AlpAydinoglu/cartpole_mechanical_setup/Mechanical Design/CAD/foam.SLDPRT

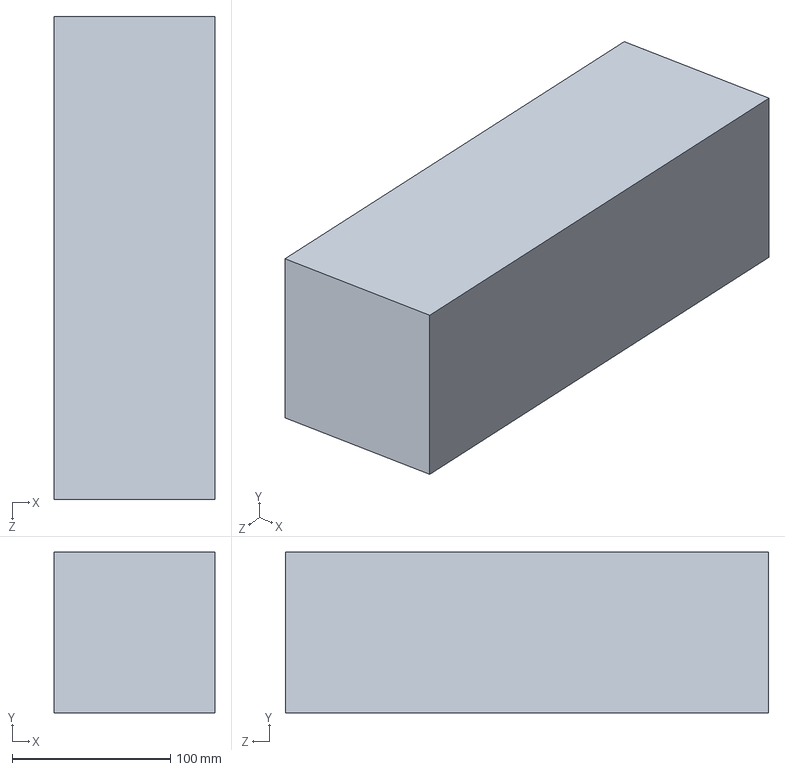
[picture p1: CAD file, 2021-07-19]
Mechanical Design/CAD/foam.SLDPRT
101.6 x 101.6 x 304.8 mm
