AlpAydinoglu/cartpole_mechanical_setup/Mechanical Design/CAD/linearBearingBig.SLDPRT

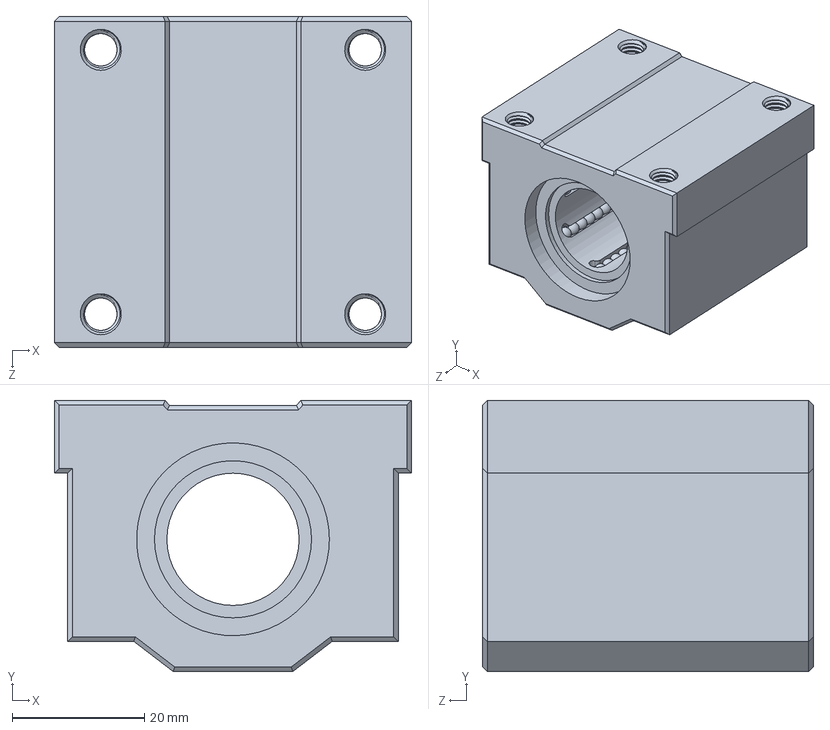
[picture p2: CAD file, 2021-07-19]
Mechanical Design/CAD/linearBearingBig.SLDPRT
54.0 x 41.0 x 50.0 mm
