AlpAydinoglu/cartpole_mechanical_setup/Mechanical Design/CAD/PC42part.SLDPRT

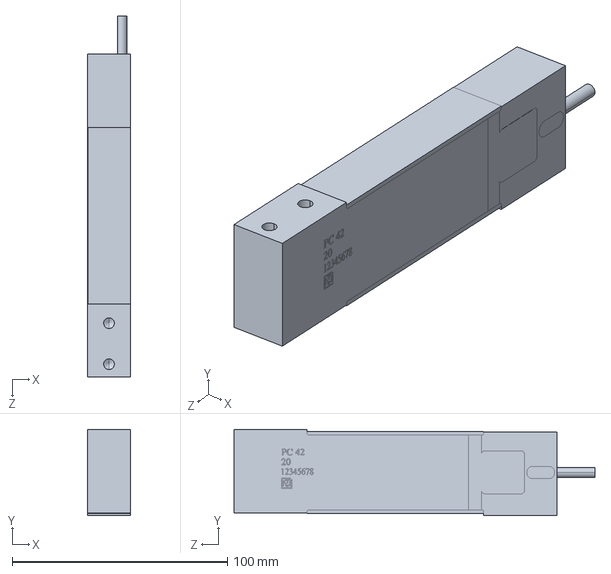
[picture p3: CAD file, 2021-07-19]
Mechanical Design/CAD/PC42part.SLDPRT
20.0 x 40.0 x 167.7 mm
