AlpAydinoglu/cartpole_mechanical_setup/Mechanical Design/CAD/ballBearingAndHousing.SLDPRT

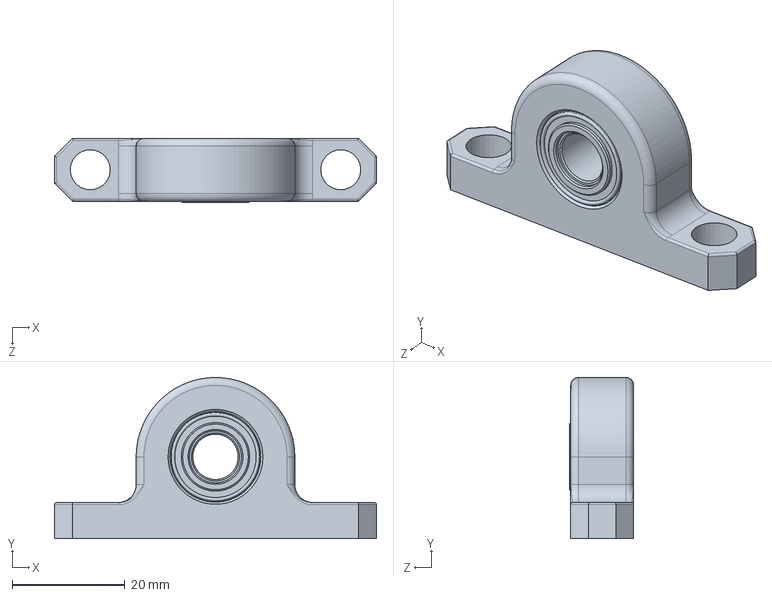
[picture p4: CAD file, 2021-07-19]
Mechanical Design/CAD/ballBearingAndHousing.SLDPRT
57.2 x 28.6 x 11.5 mm
