AlpAydinoglu/cartpole_mechanical_setup/Mechanical Design/CAD/motorMount.SLDPRT

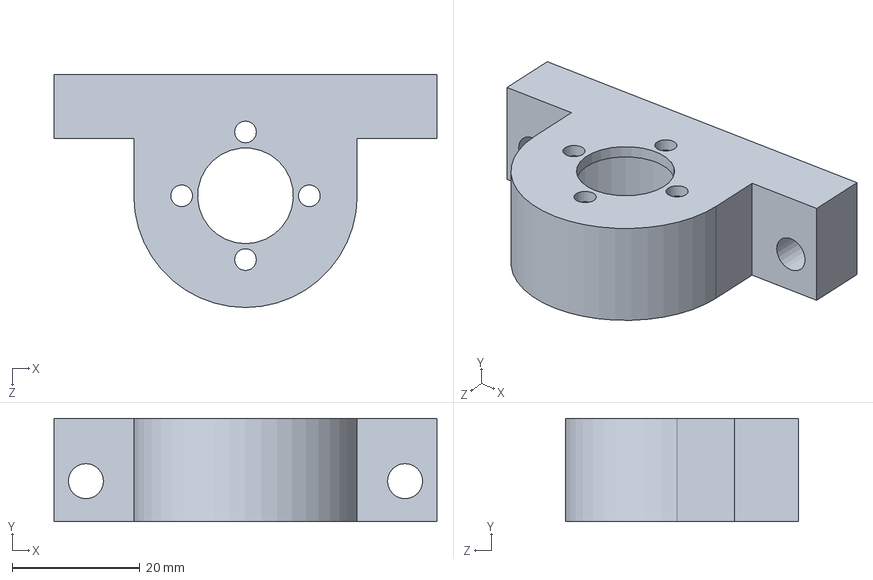
[picture p5: CAD file, 2021-07-19]
Mechanical Design/CAD/motorMount.SLDPRT
60.0 x 16.2 x 36.5 mm
