AlpAydinoglu/cartpole_mechanical_setup/Mechanical Design/CAD/Long.SLDPRT

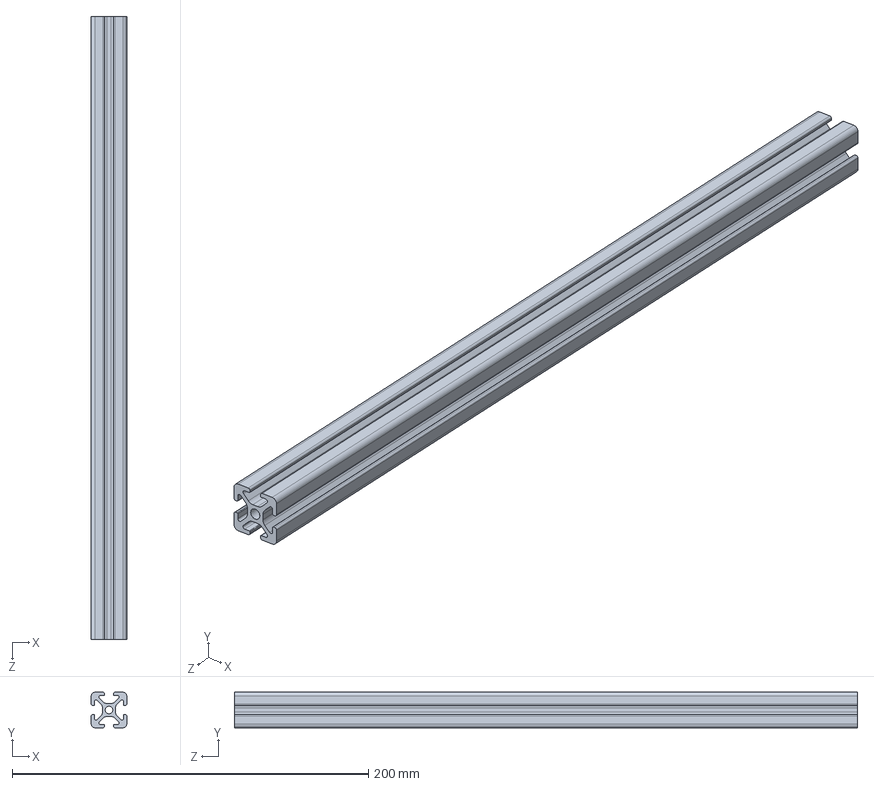
[picture p6: CAD file, 2021-07-19]
Mechanical Design/CAD/Long.SLDPRT
20.0 x 20.0 x 350.0 mm
