AlpAydinoglu/cartpole_mechanical_setup/Mechanical Design/CAD/motorConfigPart.SLDPRT

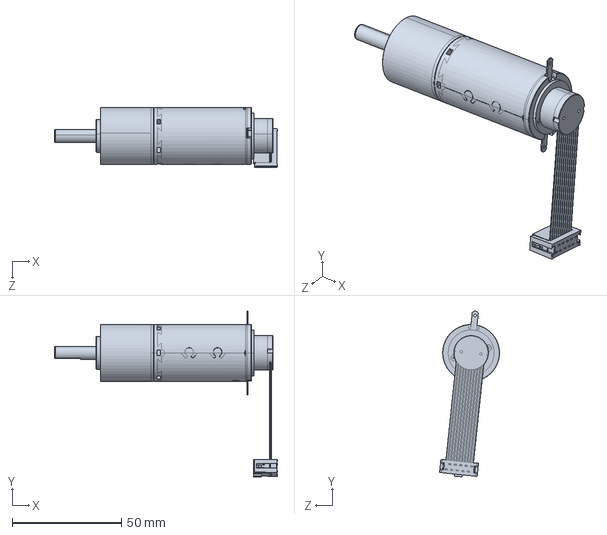
[picture p7: CAD file, 2021-07-19]
Mechanical Design/CAD/motorConfigPart.SLDPRT
102.1 x 75.9 x 27.5 mm
