AlpAydinoglu/cartpole_mechanical_setup/Mechanical Design/CAD/encoderHub.SLDPRT

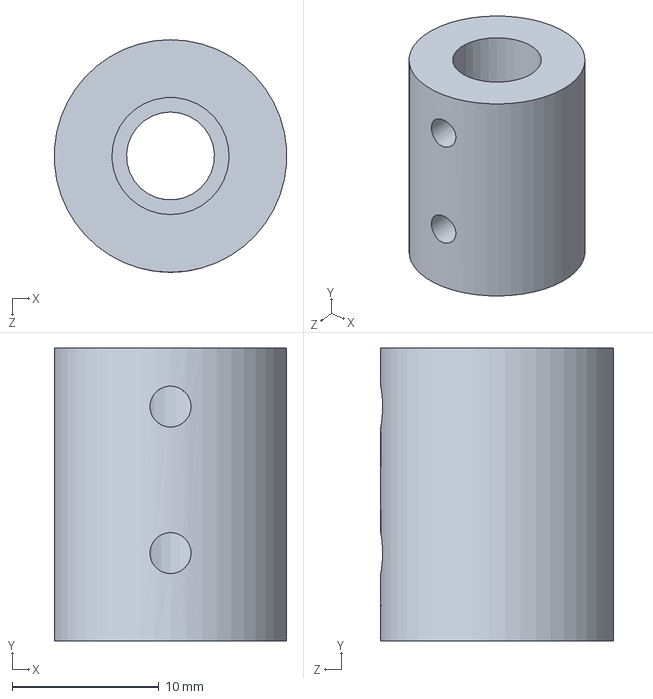
[picture p8: CAD file, 2021-07-19]
Mechanical Design/CAD/encoderHub.SLDPRT
15.8 x 20.0 x 15.9 mm
