AlpAydinoglu/cartpole_mechanical_setup/Mechanical Design/CAD/newEncoderMount.SLDPRT

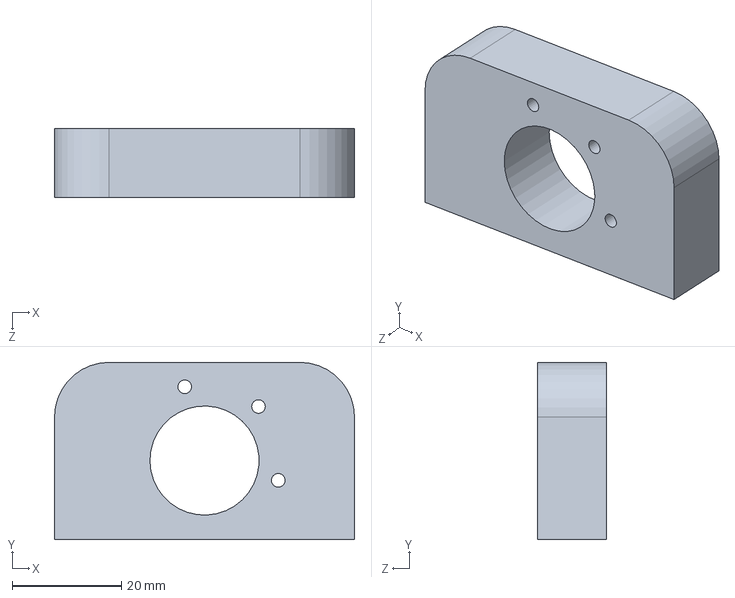
[picture p9: CAD file, 2021-07-19]
Mechanical Design/CAD/newEncoderMount.SLDPRT
55.0 x 32.5 x 12.7 mm
