AlpAydinoglu/cartpole_mechanical_setup/Mechanical Design/CAD/ShortSideBar.SLDPRT

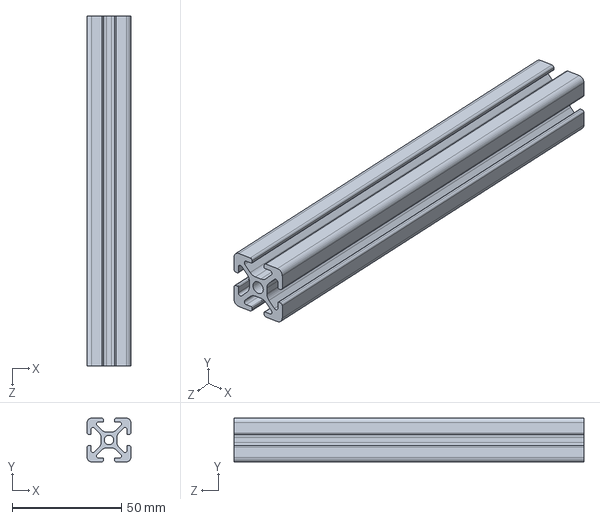
[picture p10: CAD file, 2021-07-19]
Mechanical Design/CAD/ShortSideBar.SLDPRT
20.0 x 20.0 x 160.0 mm
