AlpAydinoglu/cartpole_mechanical_setup/Mechanical Design/CAD/LongBaseBar.SLDPRT

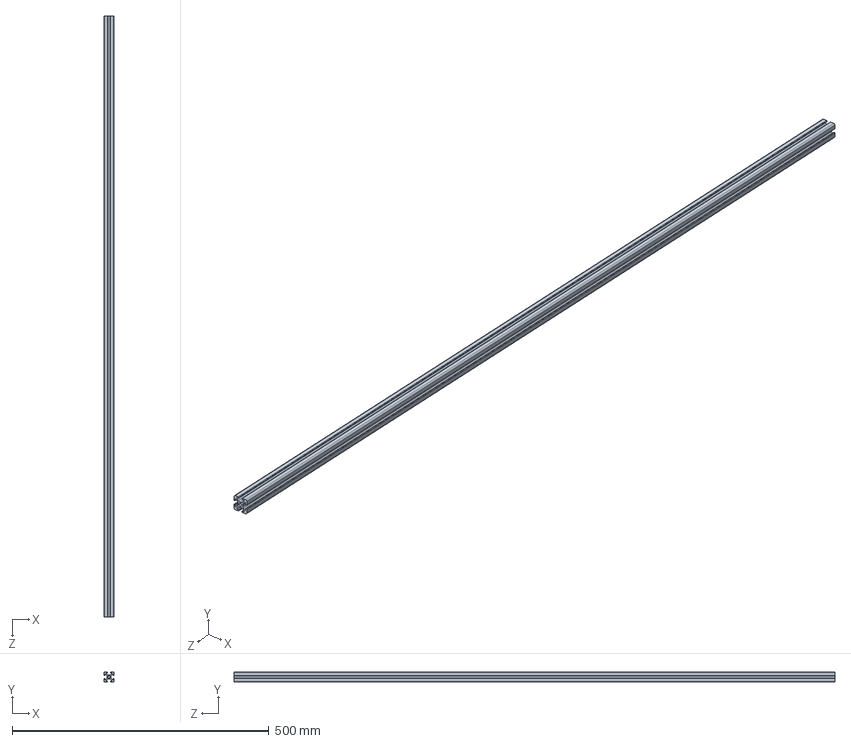
[picture p11: CAD file, 2021-07-19]
Mechanical Design/CAD/LongBaseBar.SLDPRT
20.0 x 20.0 x 1170.0 mm
