AlpAydinoglu/cartpole_mechanical_setup/Mechanical Design/CAD/BTBar.SLDPRT

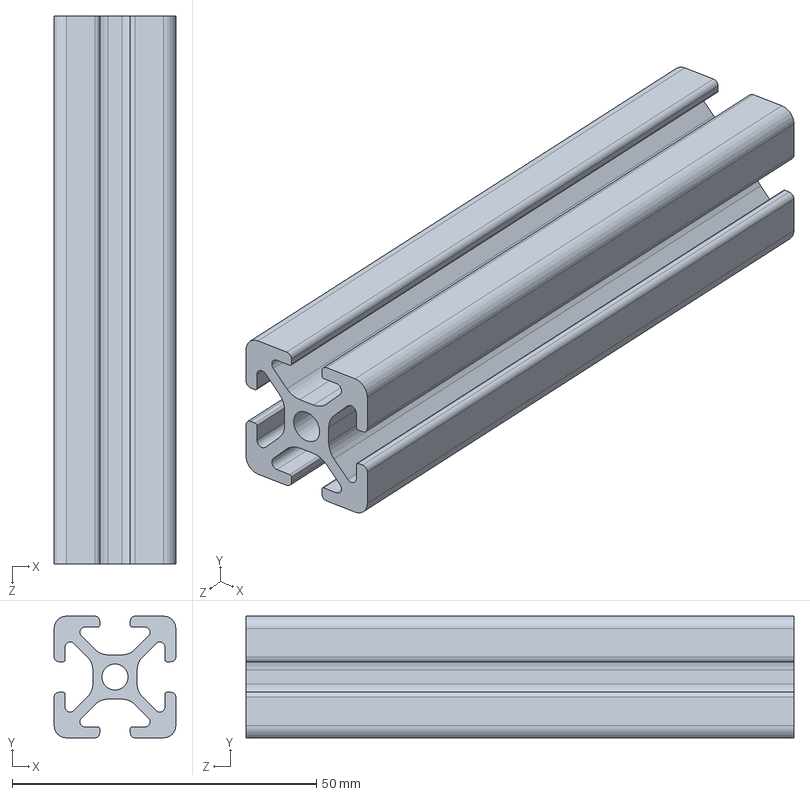
[picture p12: CAD file, 2021-07-19]
Mechanical Design/CAD/BTBar.SLDPRT
20.0 x 20.0 x 90.0 mm
