AlpAydinoglu/cartpole_mechanical_setup/Mechanical Design/CAD/outerEM.SLDPRT

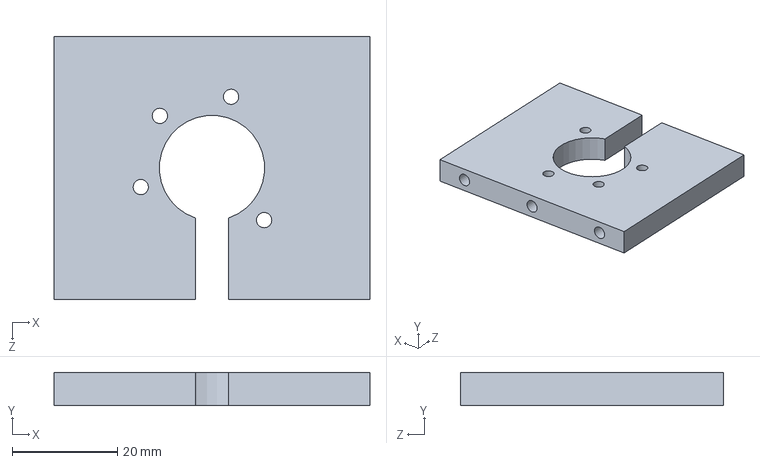
[picture p13: CAD file, 2021-07-19]
Mechanical Design/CAD/outerEM.SLDPRT
60.0 x 6.35 x 50.0 mm
