AlpAydinoglu/cartpole_mechanical_setup/Mechanical Design/CAD/cap.SLDPRT

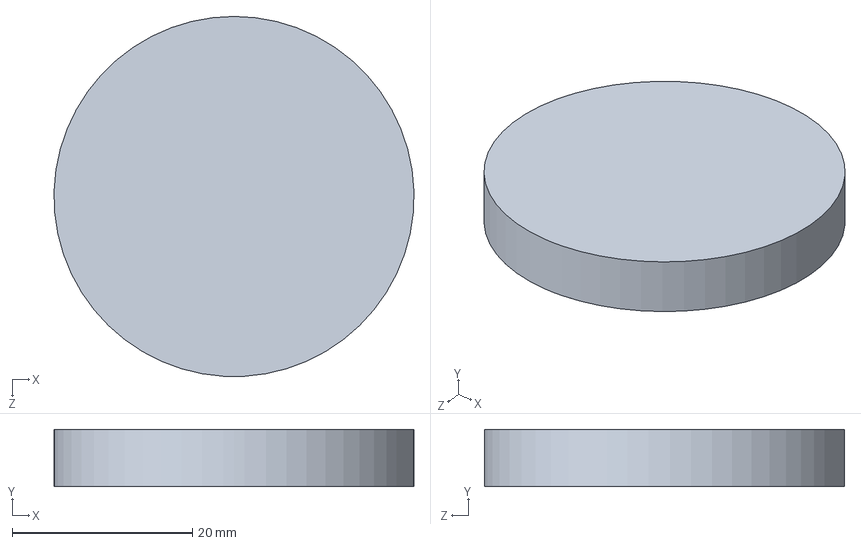
[picture p14: CAD file, 2021-07-19]
Mechanical Design/CAD/cap.SLDPRT
40.0 x 6.35 x 40.0 mm
