AlpAydinoglu/cartpole_mechanical_setup/Mechanical Design/CAD/blockTilt.SLDPRT

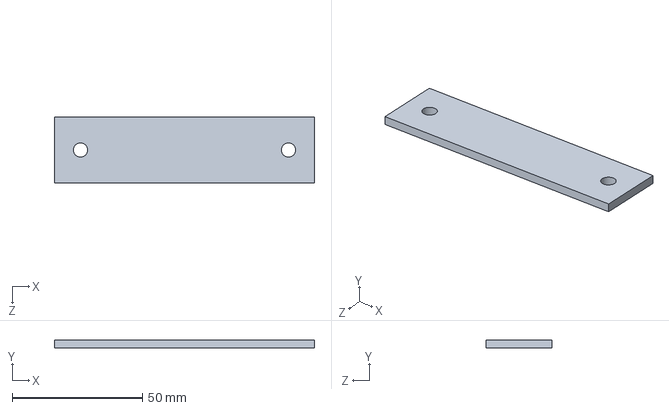
[picture p15: CAD file, 2021-07-19]
Mechanical Design/CAD/blockTilt.SLDPRT
100.0 x 3.17 x 25.4 mm
