AlpAydinoglu/cartpole_mechanical_setup/Mechanical Design/CAD/halfSquashBall.SLDPRT

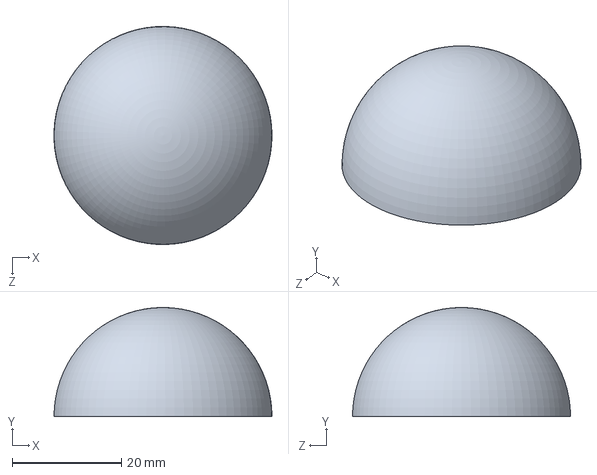
[picture p16: CAD file, 2021-07-19]
Mechanical Design/CAD/halfSquashBall.SLDPRT
40.0 x 20.0 x 40.0 mm
