AlpAydinoglu/cartpole_mechanical_setup/Mechanical Design/CAD/shaftSupportBig.SLDPRT

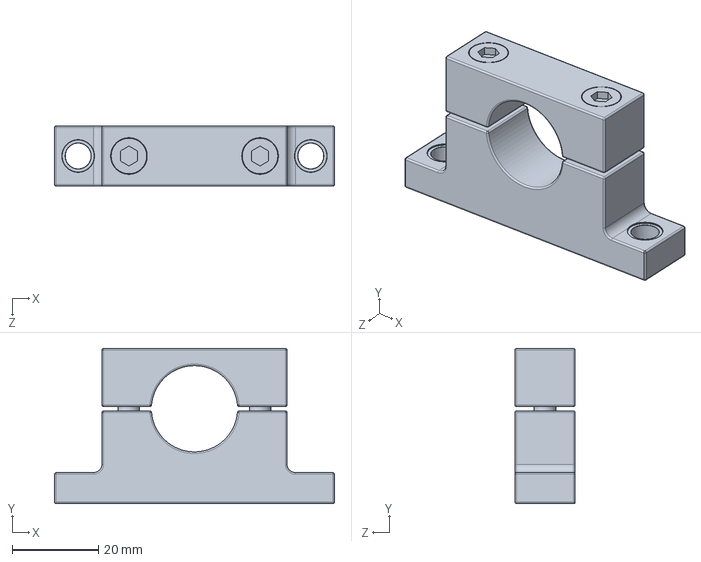
[picture p17: CAD file, 2021-07-19]
Mechanical Design/CAD/shaftSupportBig.SLDPRT
65.0 x 36.0 x 14.0 mm
