AlpAydinoglu/cartpole_mechanical_setup/Mechanical Design/CAD/mdfPart.SLDPRT

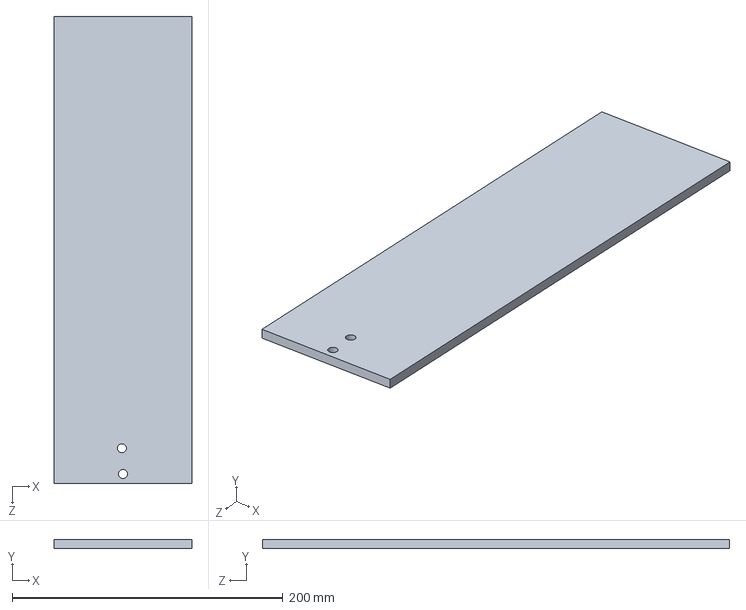
[picture p18: CAD file, 2021-07-19]
Mechanical Design/CAD/mdfPart.SLDPRT
101.6 x 6.35 x 344.8 mm
