AlpAydinoglu/cartpole_mechanical_setup/Mechanical Design/CAD/newEncoder.SLDPRT

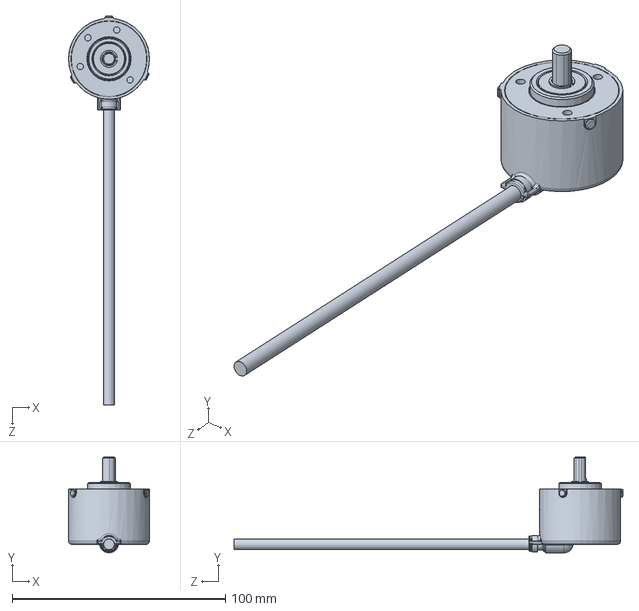
[picture p19: CAD file, 2021-07-19]
Mechanical Design/CAD/newEncoder.SLDPRT
38.0 x 44.9 x 182.6 mm
