AlpAydinoglu/cartpole_mechanical_setup/Mechanical Design/CAD/cornerBracket.SLDPRT

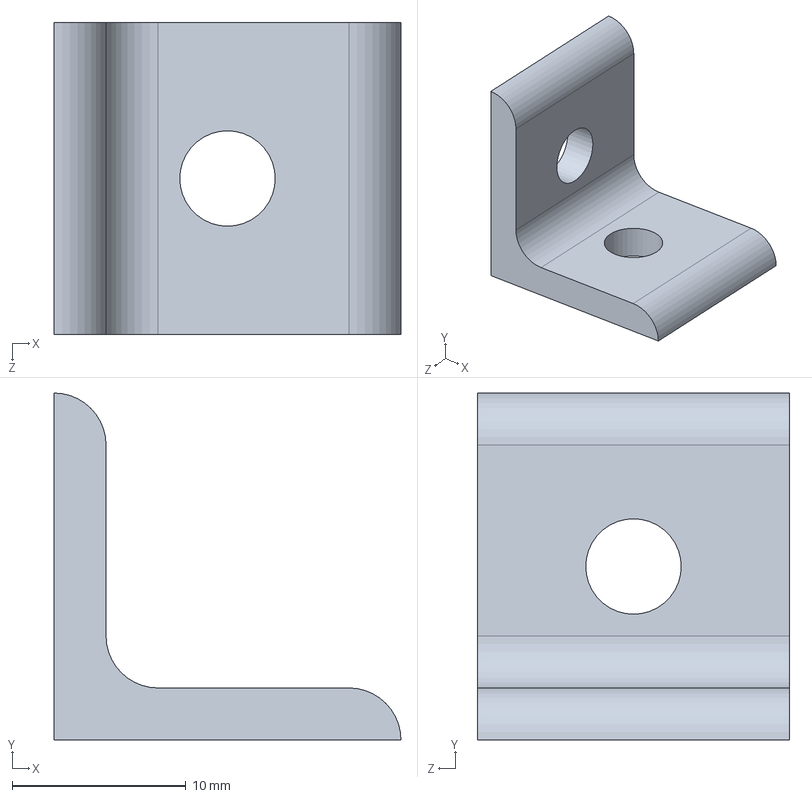
[picture p20: CAD file, 2021-07-19]
Mechanical Design/CAD/cornerBracket.SLDPRT
20.0 x 20.0 x 18.0 mm
