AlpAydinoglu/cartpole_mechanical_setup/Mechanical Design/CAD/motorPulley.SLDPRT

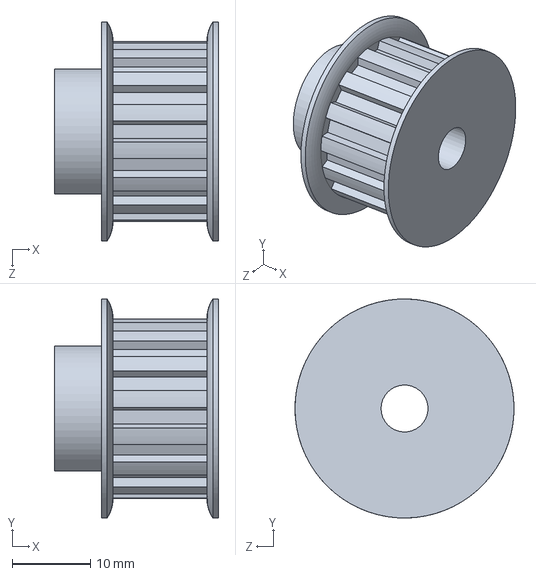
[picture p21: CAD file, 2021-07-19]
Mechanical Design/CAD/motorPulley.SLDPRT
21.0 x 28.0 x 28.0 mm
