AlpAydinoglu/cartpole_mechanical_setup/Mechanical Design/CAD/PCMount.SLDPRT

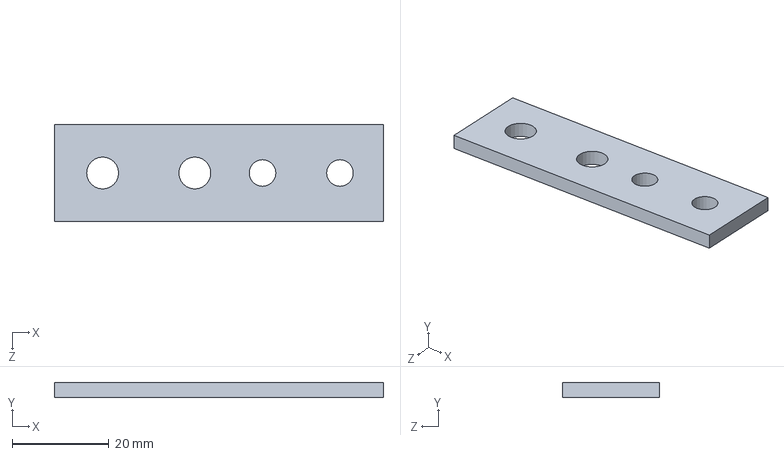
[picture p22: CAD file, 2021-07-19]
Mechanical Design/CAD/PCMount.SLDPRT
68.0 x 3.17 x 20.0 mm
