AlpAydinoglu/cartpole_mechanical_setup/Mechanical Design/CAD/beltTensioner.SLDPRT

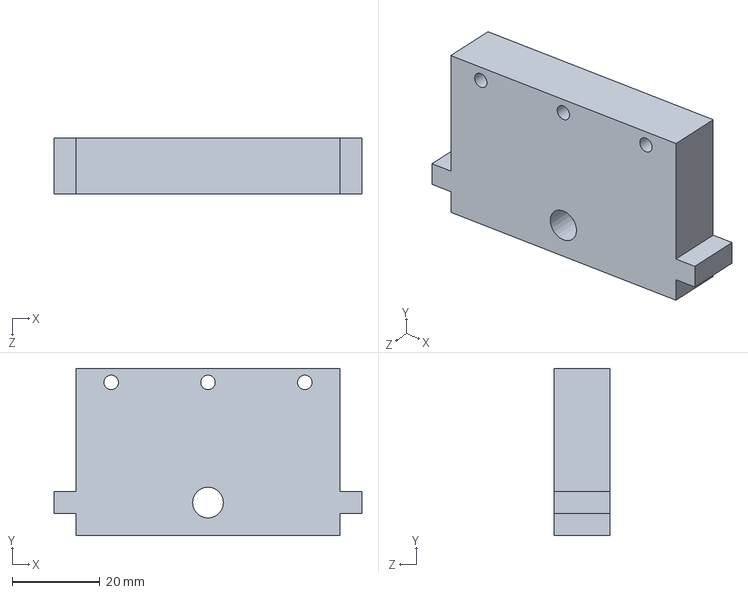
[picture p23: CAD file, 2021-07-19]
Mechanical Design/CAD/beltTensioner.SLDPRT
70.0 x 38.0 x 12.7 mm
