AlpAydinoglu/cartpole_mechanical_setup/Mechanical Design/CAD/pole.SLDPRT

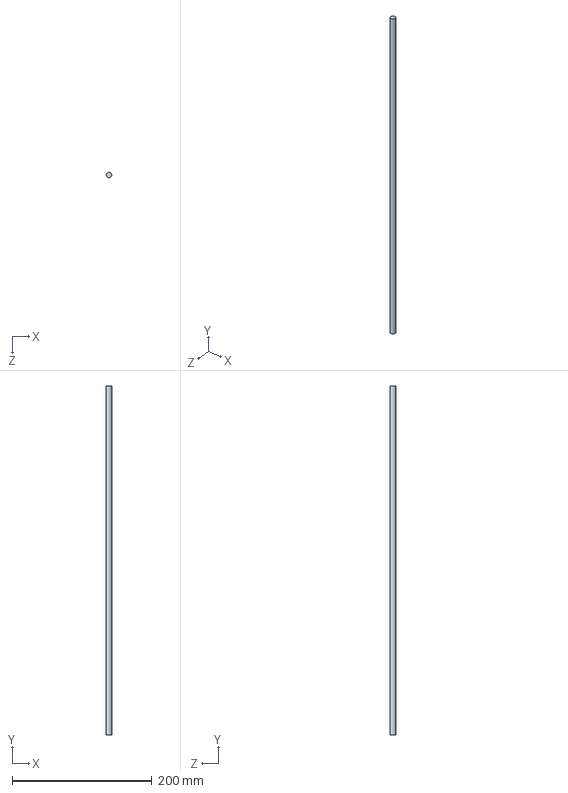
[picture p24: CAD file, 2021-07-19]
Mechanical Design/CAD/pole.SLDPRT
8.00 x 500.0 x 8.00 mm
