AlpAydinoglu/cartpole_mechanical_setup/Mechanical Design/CAD/shaftBig.SLDPRT

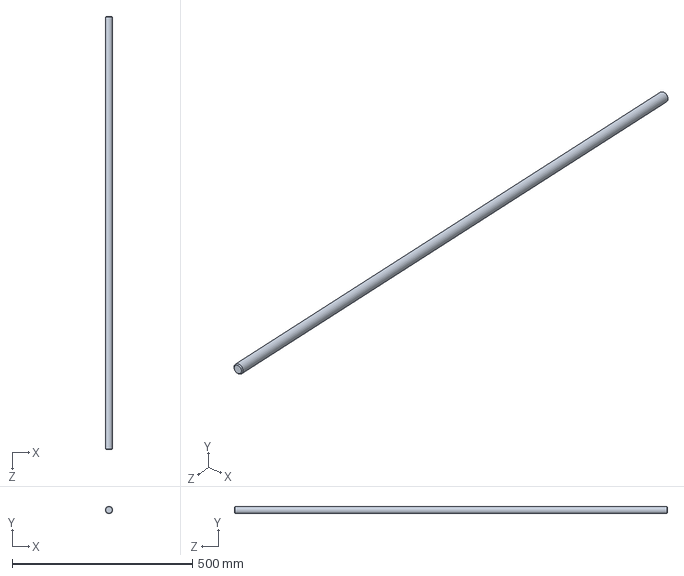
[picture p25: CAD file, 2021-07-19]
Mechanical Design/CAD/shaftBig.SLDPRT
20.0 x 20.0 x 1200.0 mm
