AlpAydinoglu/cartpole_mechanical_setup/Mechanical Design/CAD/newPoleHub.SLDPRT

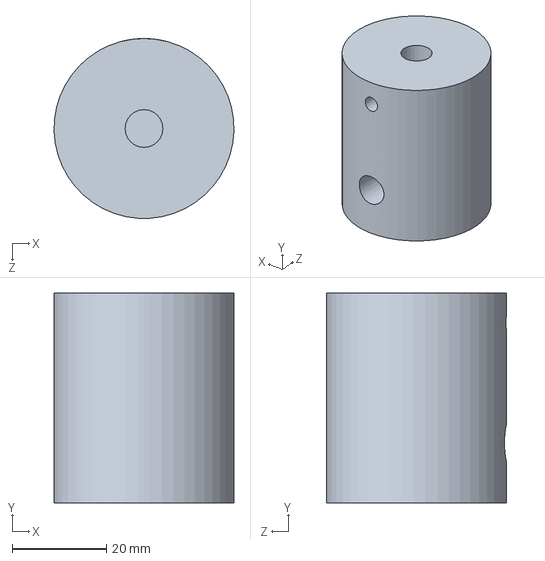
[picture p26: CAD file, 2021-07-19]
Mechanical Design/CAD/newPoleHub.SLDPRT
38.1 x 44.5 x 38.1 mm
