AlpAydinoglu/cartpole_mechanical_setup/Mechanical Design/CAD/Bottom.SLDPRT

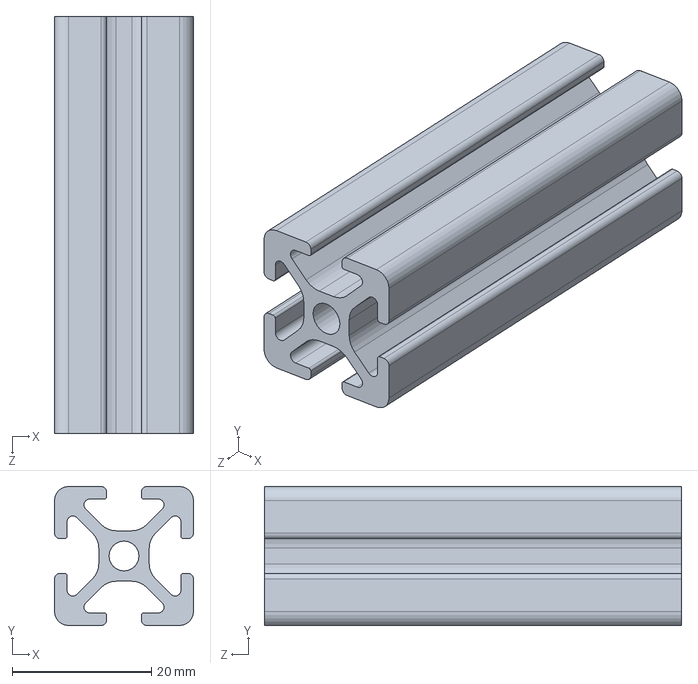
[picture p27: CAD file, 2021-07-19]
Mechanical Design/CAD/Bottom.SLDPRT
20.0 x 20.0 x 60.0 mm
