AlpAydinoglu/cartpole_mechanical_setup/Mechanical Design/CAD/cartBaseBig.SLDPRT

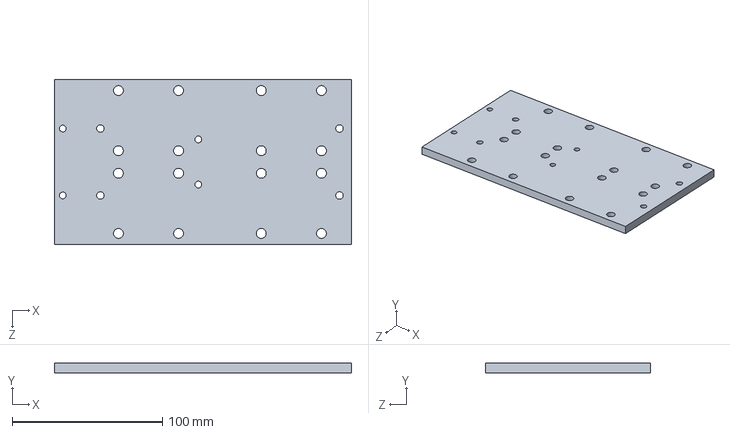
[picture p28: CAD file, 2021-07-19]
Mechanical Design/CAD/cartBaseBig.SLDPRT
197.5 x 6.35 x 110.0 mm
