AlpAydinoglu/cartpole_mechanical_setup/Mechanical Design/CAD/LongSideBar.SLDPRT

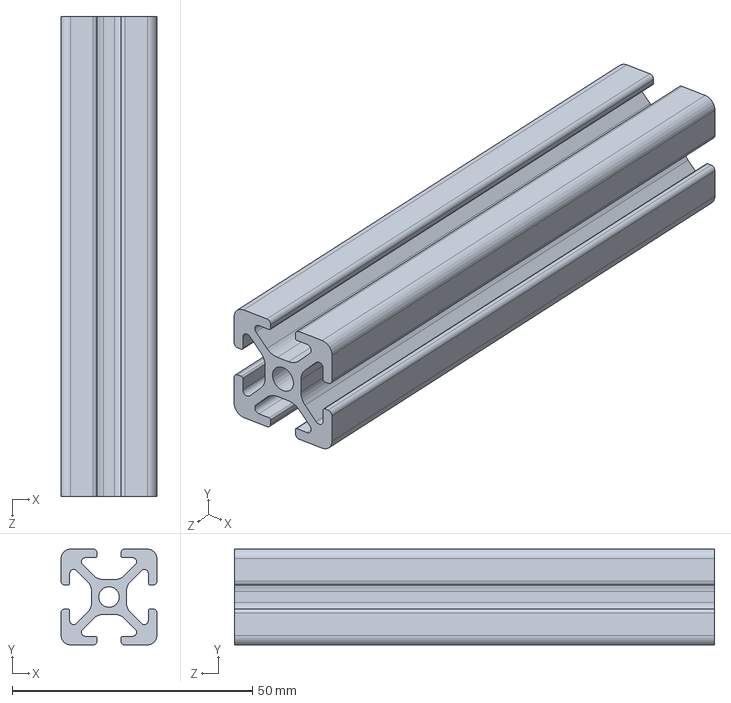
[picture p29: CAD file, 2021-07-19]
Mechanical Design/CAD/LongSideBar.SLDPRT
20.0 x 20.0 x 100.0 mm
