AlpAydinoglu/cartpole_mechanical_setup/Mechanical Design/CAD/beltClamp.SLDPRT

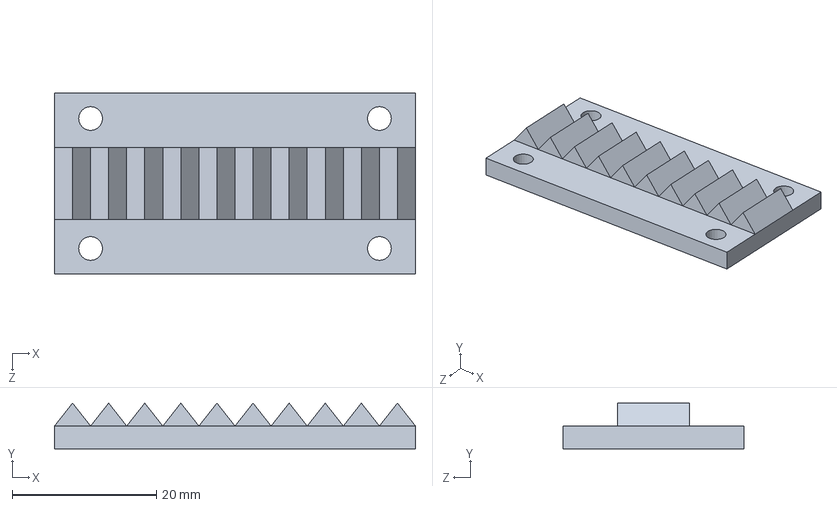
[picture p30: CAD file, 2021-07-19]
Mechanical Design/CAD/beltClamp.SLDPRT
50.0 x 6.35 x 25.0 mm
