AlpAydinoglu/cartpole_mechanical_setup/Mechanical Design/CAD/beltMount.SLDPRT

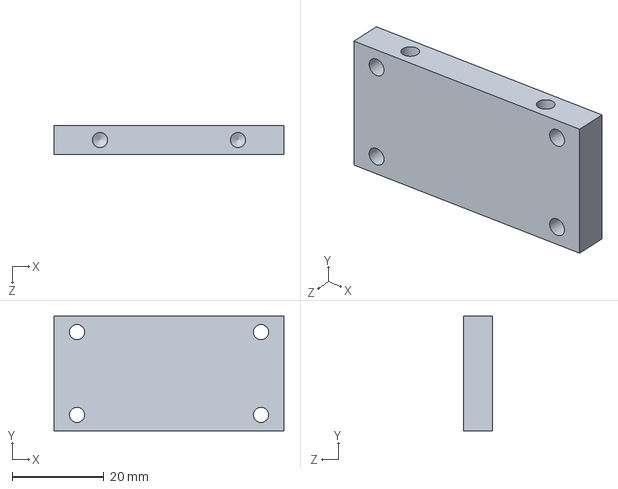
[picture p31: CAD file, 2021-07-19]
Mechanical Design/CAD/beltMount.SLDPRT
50.0 x 25.0 x 6.35 mm
