AlpAydinoglu/cartpole_mechanical_setup/Mechanical Design/CAD/poleCap.SLDPRT

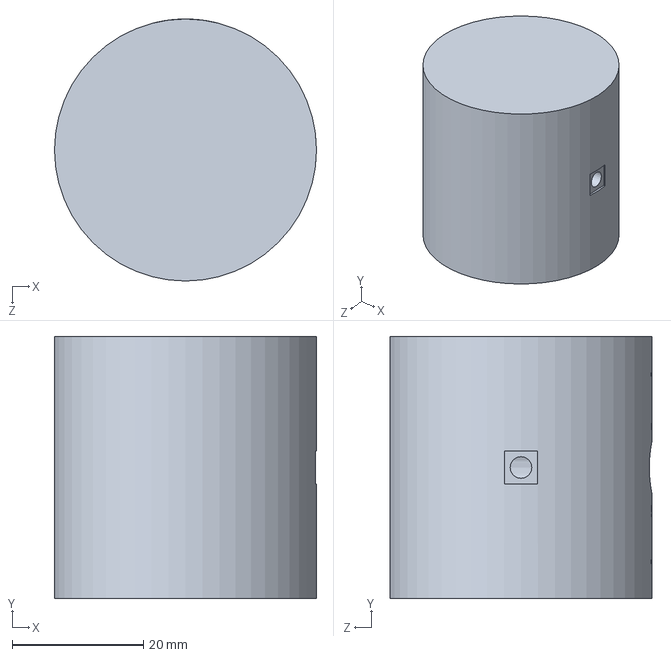
[picture p32: CAD file, 2021-07-19]
Mechanical Design/CAD/poleCap.SLDPRT
40.0 x 40.0 x 40.0 mm
