AlpAydinoglu/cartpole_mechanical_setup/Mechanical Design/CAD/motorMountLift.SLDPRT

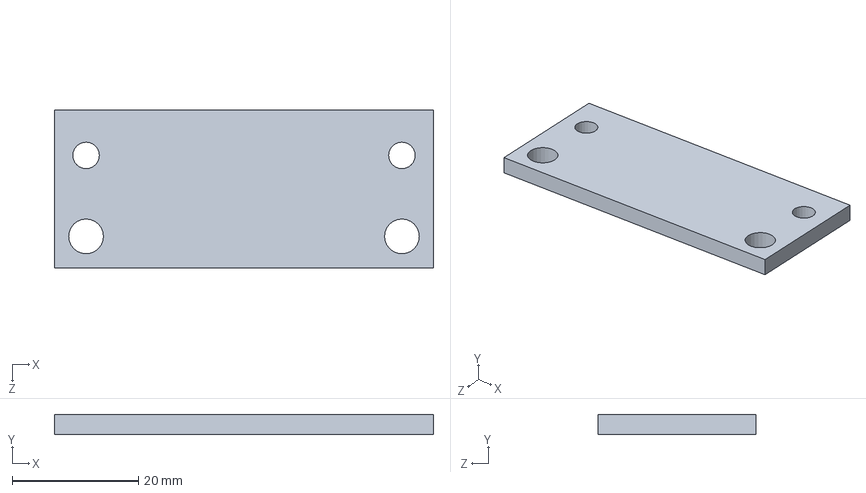
[picture p33: CAD file, 2021-07-19]
Mechanical Design/CAD/motorMountLift.SLDPRT
60.0 x 3.17 x 25.0 mm
