AlpAydinoglu/cartpole_mechanical_setup/Mechanical Design/CAD/rod.SLDPRT

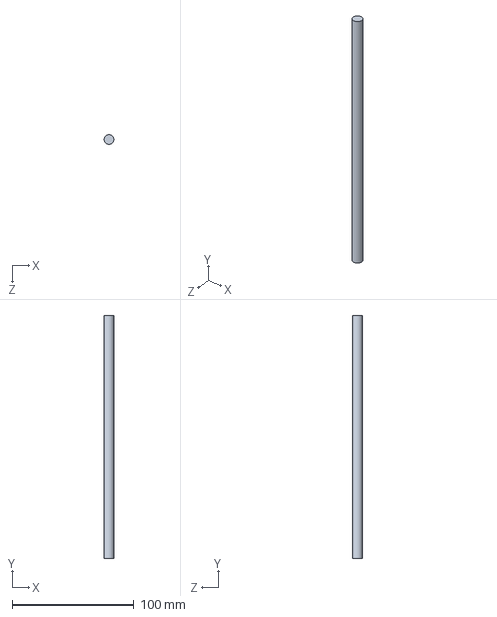
[picture p34: CAD file, 2021-07-19]
Mechanical Design/CAD/rod.SLDPRT
8.00 x 200.0 x 8.00 mm
