AlpAydinoglu/cartpole_mechanical_setup/(list of files, cad)

Other CAD files:
Mechanical Design/DWG/squashBallCap.DWG
Mechanical Design/DWG/foamMount.DWG
Mechanical Design/CAD/screwPress.SLDPRT
Mechanical Design/STL/beltClamp.STL
Mechanical Design/STL/motorMount.STL
