AlpAydinoglu/cartpole_mechanical_setup/Mechanical Design/Documents/Drawings - PDF/1-SimpleSide.pdf

2
3

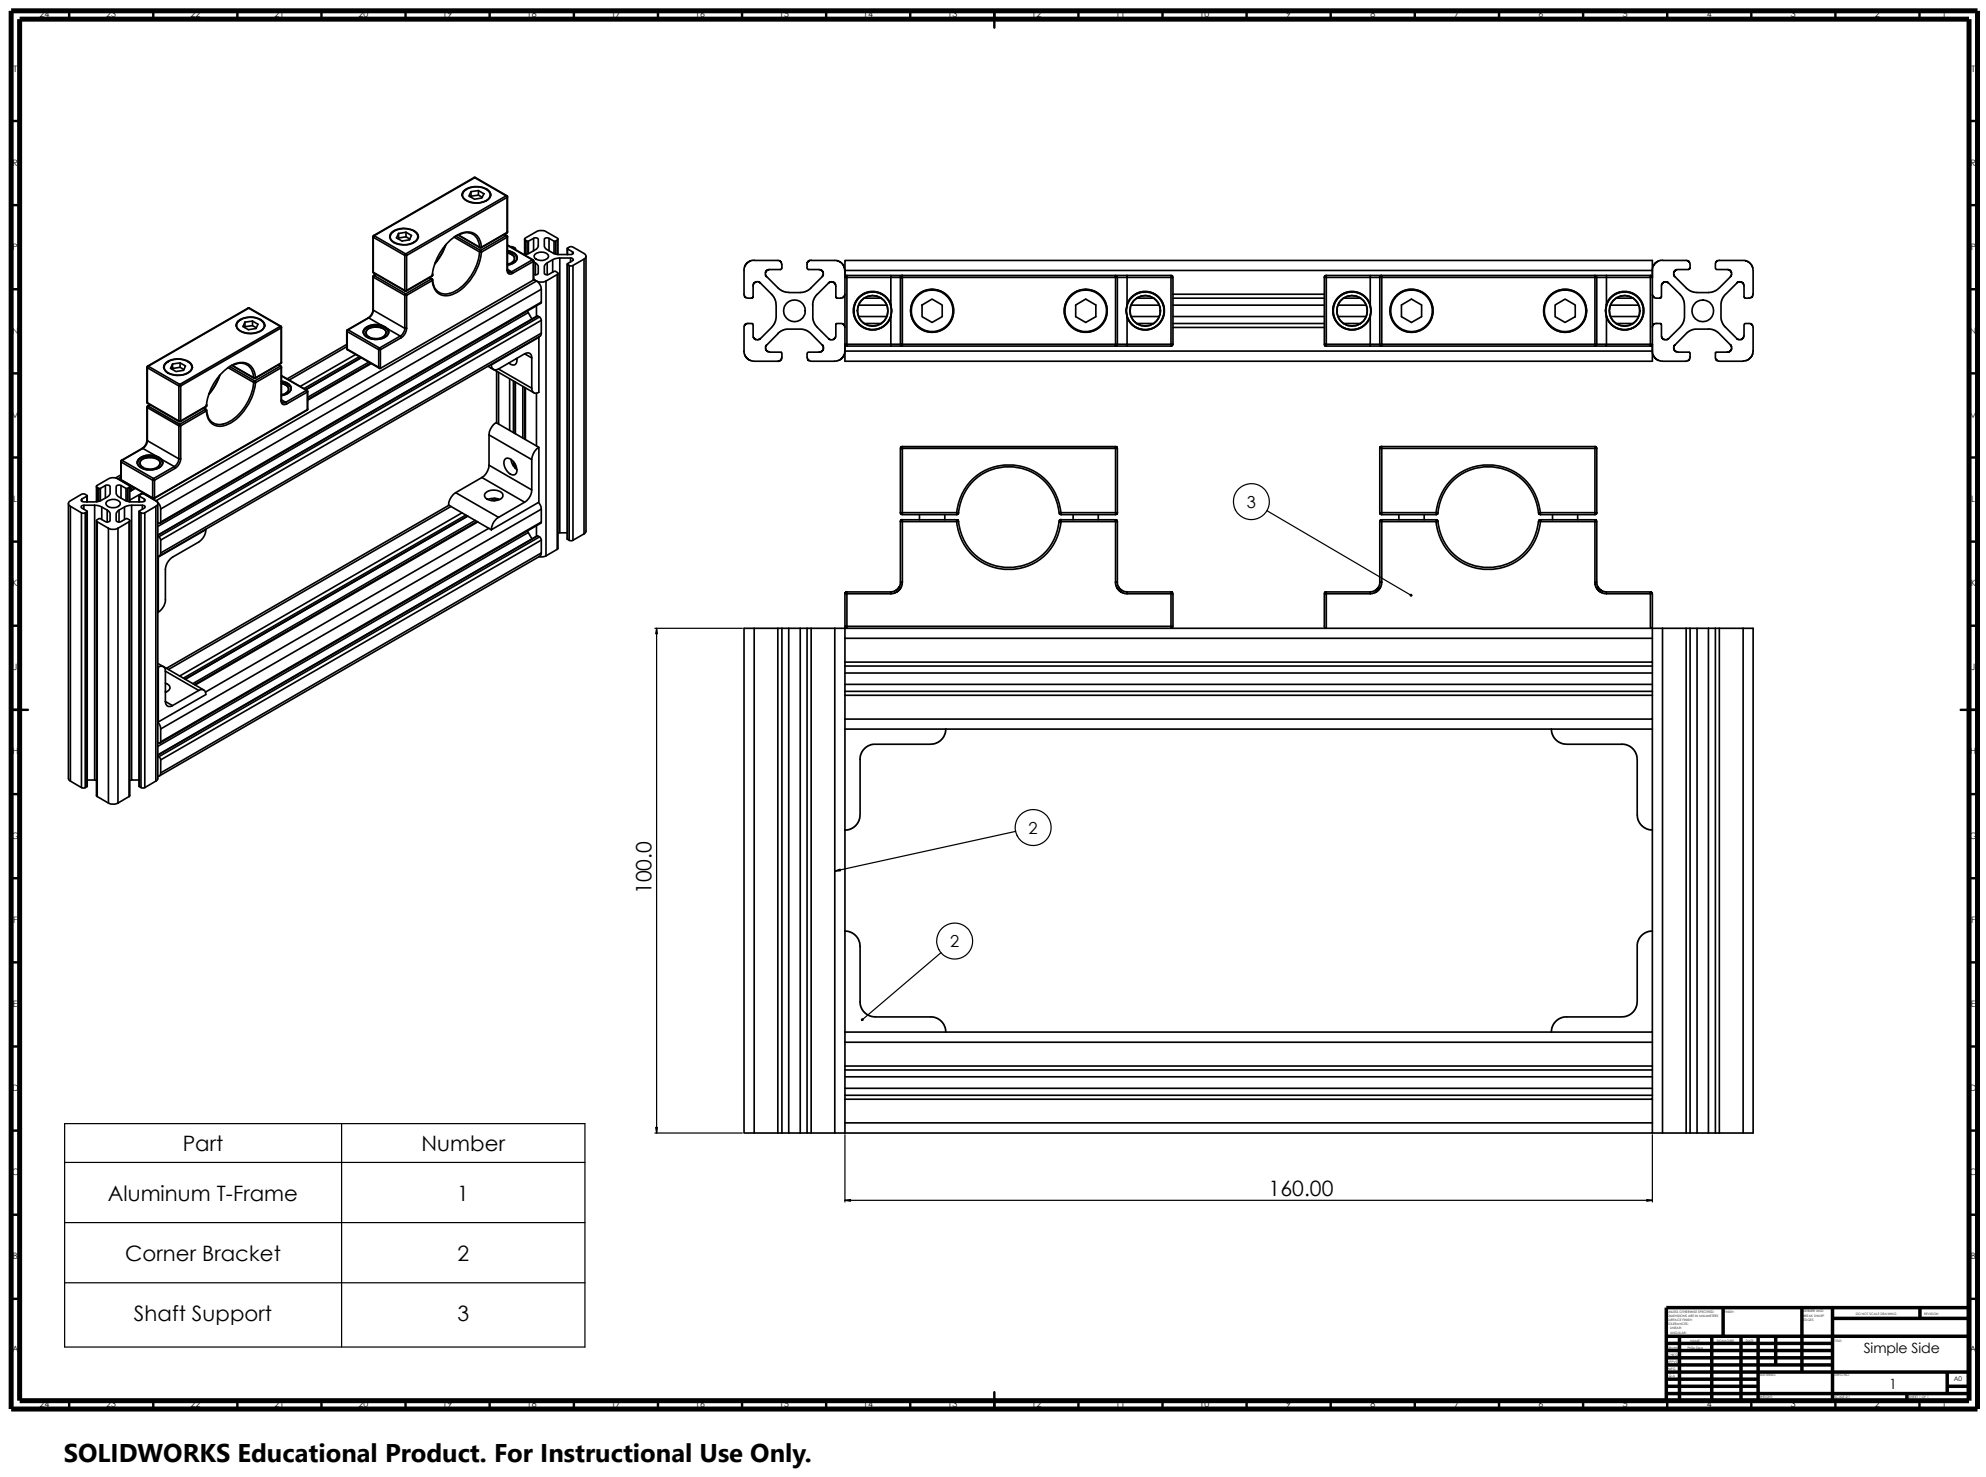
[picture p35: page 1]
FINISH:; EDGES; DO NOT SCALE DRAWING; REVISION; Simple Side; DEBURR AND BREAK SHARP

Part | Number
Aluminum T-Frame | 1

Corner Bracket | 2

Shaft Support | 3

UNLESS OTHERWISE SPECIFIED:
DIMENSIONS ARE IN MILLIMETERS
SURFACE FINISH:
TOLERANCES:
LINEAR:
ANGULAR:

NAME | SIGNATURE | DATE | | | | TITLE:

DRAWN | Philip Sieg
CHK'D APPV'D

MFG
Q.A | | | | MATERIAL: | DWG NO. 1 | A0

24 23 22 21 20 19 18 17 16 15 14 13 | 12 11 10 9 8 7 6 5 | 4 | WEIGHT: 3 | SCALE:2:1 SHEET 1 OF 1 2 1

SOLIDWORKS Educational Product. For Instructional Use Only.
