AlpAydinoglu/cartpole_mechanical_setup/Mechanical Design/Documents/Drawings - PDF/10-EncoderHub.pdf

P | P
R | R

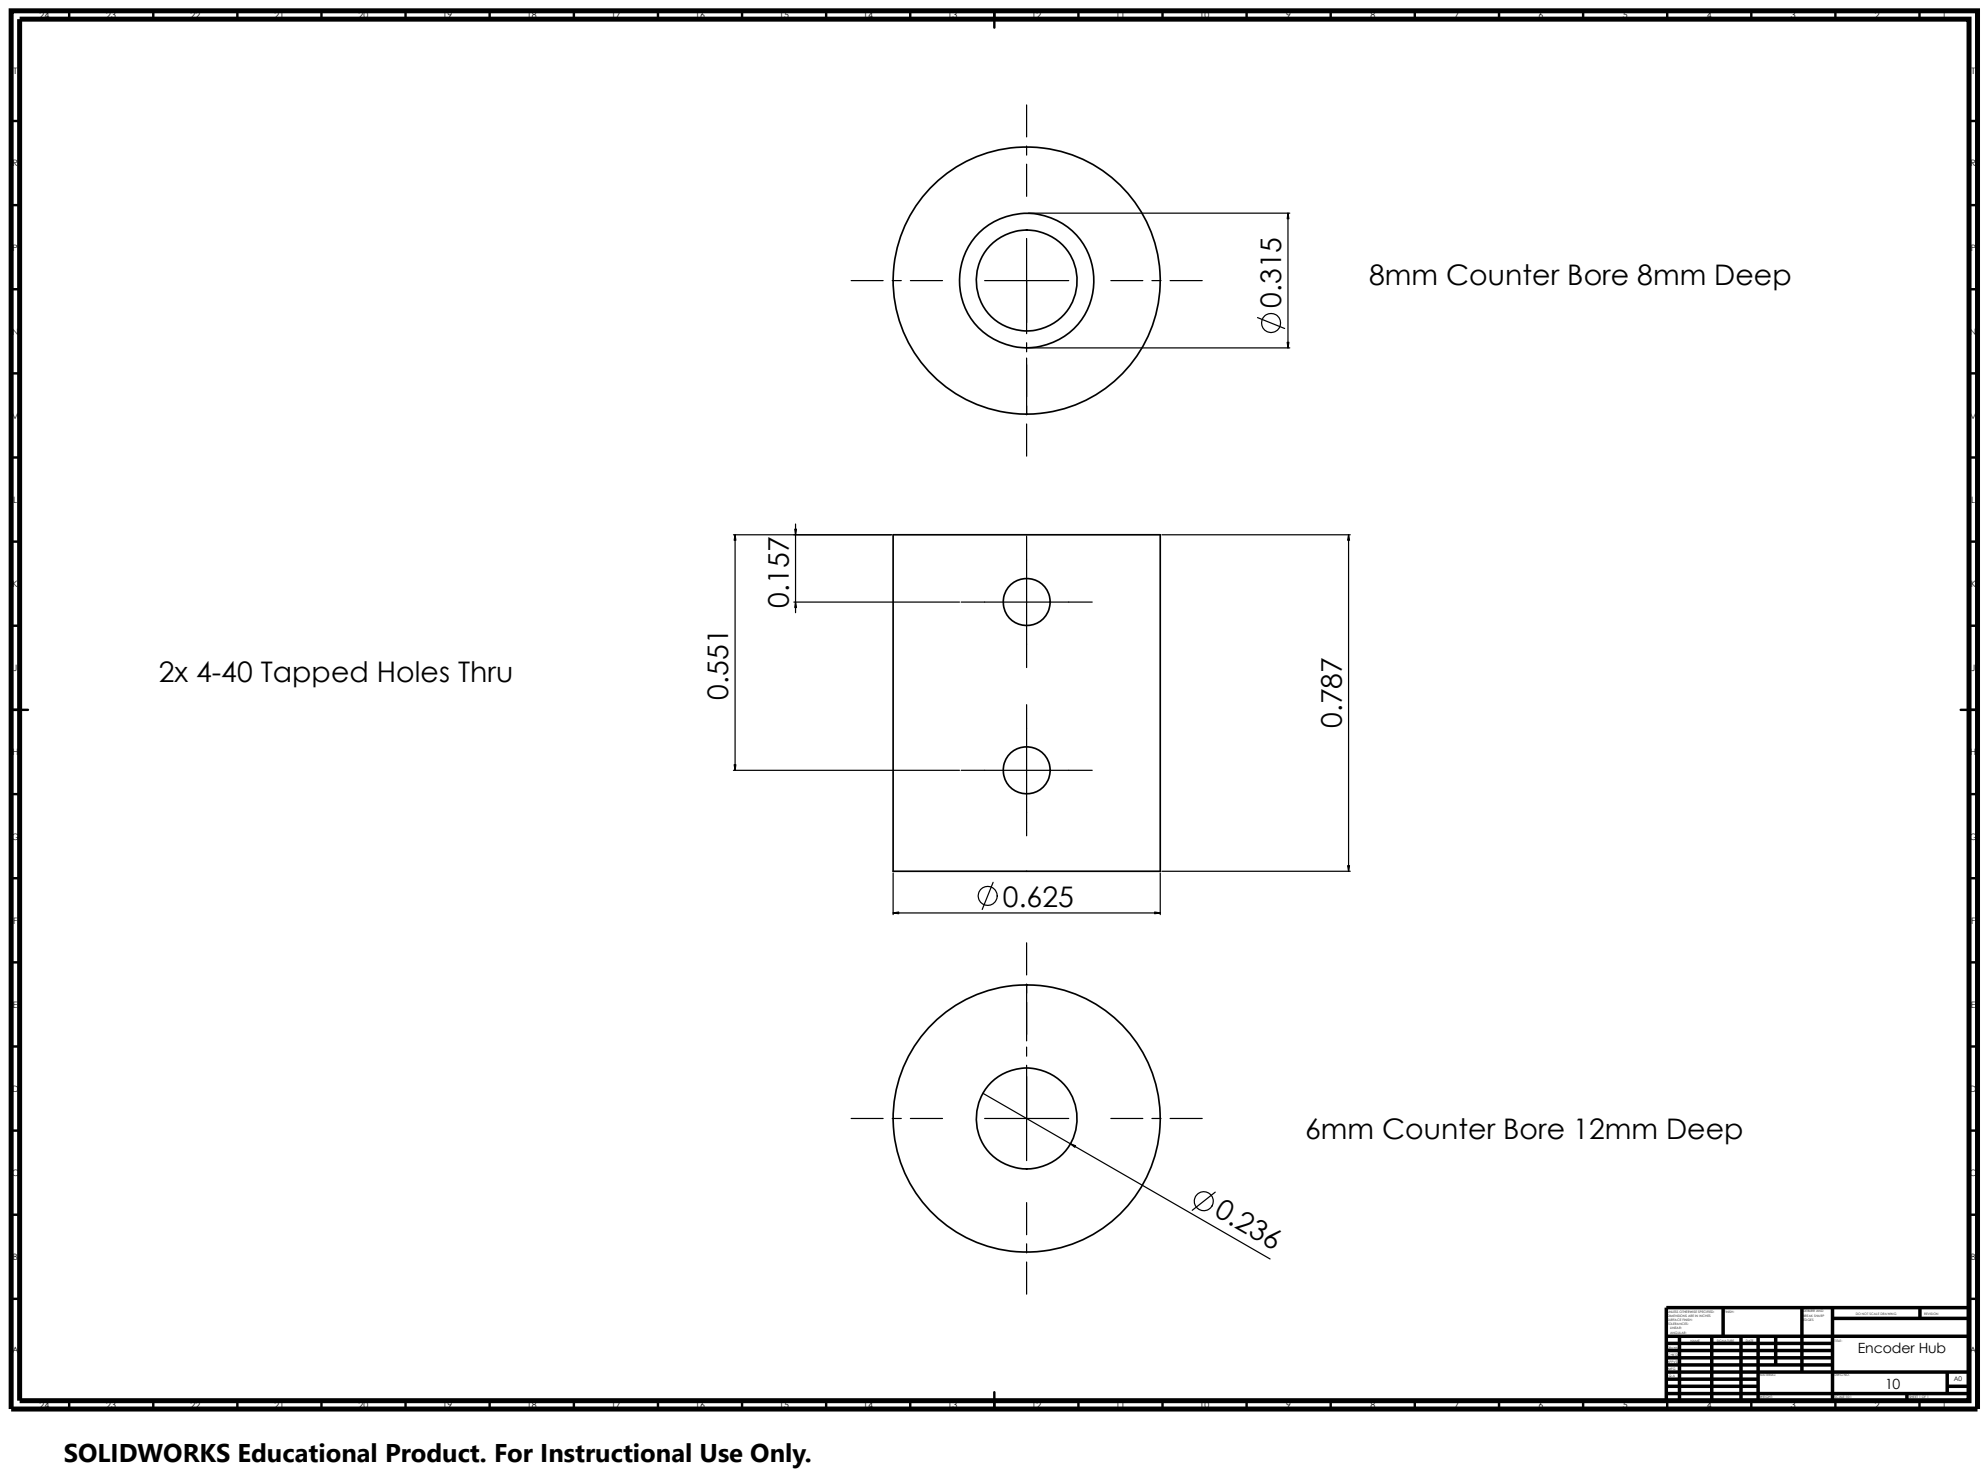
[picture p36: page 1]
WEIGHT:; SCALE:10:1; SHEET 1 OF 1; DWG NO.; FINISH:; EDGES; NAME; SIGNATURE; DATE; MATERIAL:; DO NOT SCALE DRAWING; REVISION; TITLE:; DEBURR AND BREAK SHARP; Encoder Hub

8mm Counter Bore 8mm Deep

2x 4-40 Tapped Holes Thru

6mm Counter Bore 12mm Deep

UNLESS OTHERWISE SPECIFIED:
DIMENSIONS ARE IN INCHES
SURFACE FINISH:
TOLERANCES:
LINEAR:
ANGULAR:

DRAWN
CHK'D APPV'D

MFG Q.A

SOLIDWORKS Educational Product. For Instructional Use Only.
