AlpAydinoglu/cartpole_mechanical_setup/Mechanical Design/Documents/Drawings - PDF/11-ClampMount.pdf

P | P
R | R

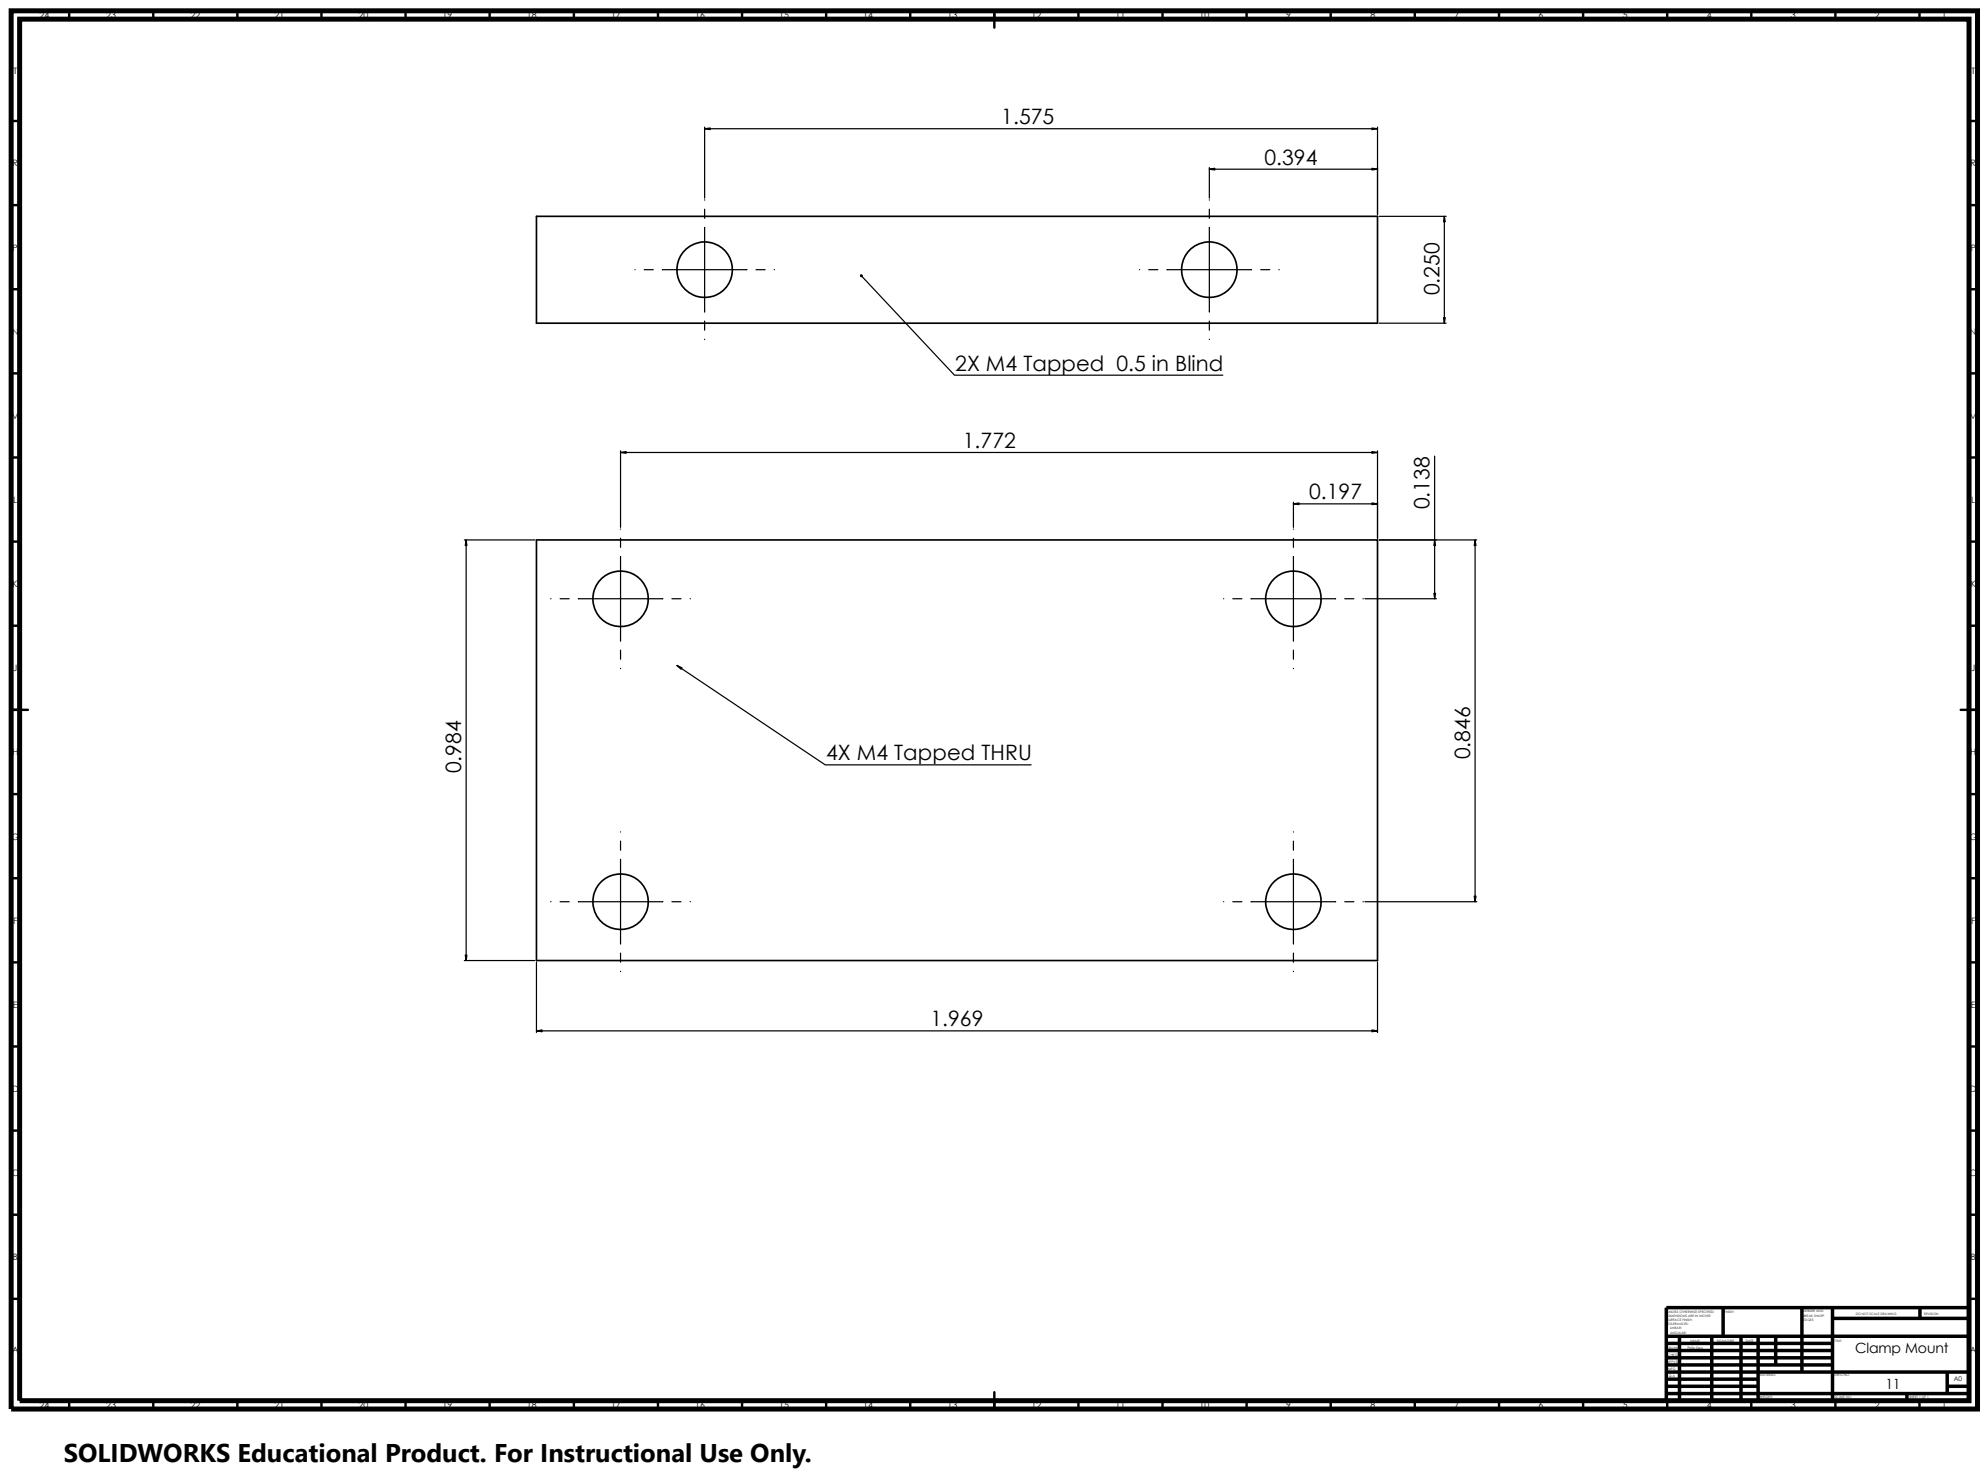
[picture p37: page 1]
WEIGHT:; SCALE:10:1; SHEET 1 OF 1; DWG NO.; FINISH:; EDGES; NAME; SIGNATURE; DATE; MATERIAL:; DO NOT SCALE DRAWING; REVISION; TITLE:; DEBURR AND BREAK SHARP; Clamp Mount; 4X M4 Tapped THRU

2X M4 Tapped 0.5 in Blind

UNLESS OTHERWISE SPECIFIED:
DIMENSIONS ARE IN INCHES
SURFACE FINISH:
TOLERANCES:
LINEAR:
ANGULAR:

DRAWN | Philip Sieg
CHK'D APPV'D

MFG Q.A

SOLIDWORKS Educational Product. For Instructional Use Only.
