AlpAydinoglu/cartpole_mechanical_setup/Mechanical Design/Documents/Drawings - PDF/12-PoleHub.pdf

P | P
R | R

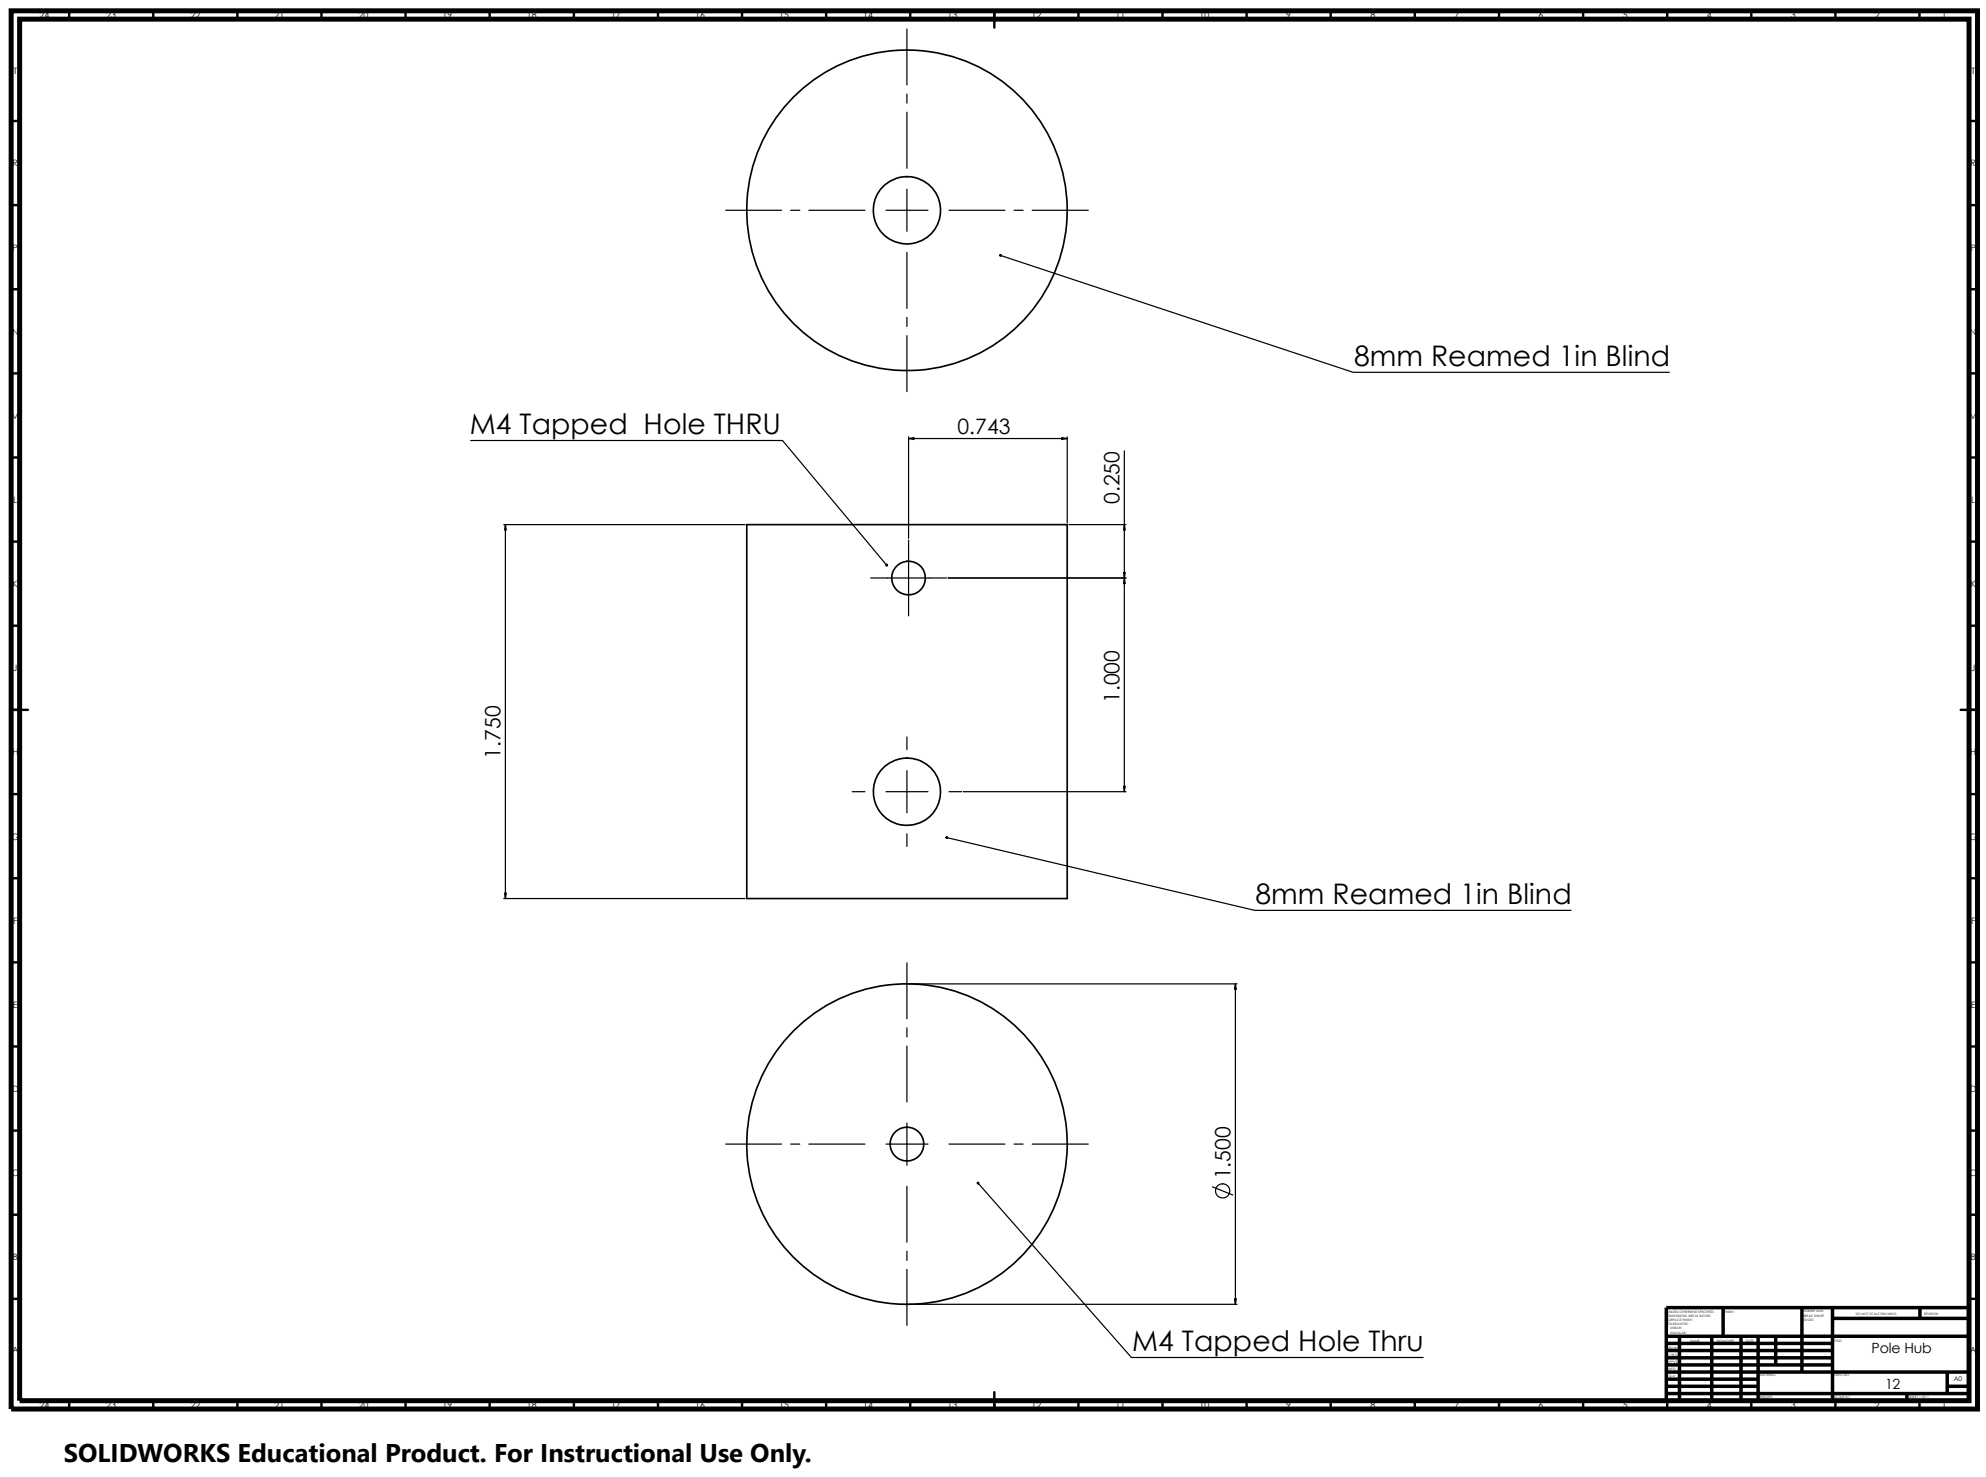
[picture p38: page 1]
WEIGHT:; SCALE:5:1; SHEET 1 OF 1; DWG NO.; FINISH:; EDGES; NAME; SIGNATURE; DATE; MATERIAL:; DO NOT SCALE DRAWING; REVISION; TITLE:; DEBURR AND BREAK SHARP; Pole Hub; 8mm Reamed 1in Blind

M4 Tapped Hole THRU

UNLESS OTHERWISE SPECIFIED:
DIMENSIONS ARE IN INCHES
SURFACE FINISH:
TOLERANCES:
LINEAR:
ANGULAR:

M4 Tapped Hole Thru

DRAWN
CHK'D APPV'D

MFG Q.A

SOLIDWORKS Educational Product. For Instructional Use Only.
