AlpAydinoglu/cartpole_mechanical_setup/Mechanical Design/Documents/Drawings - PDF/13-PoleCap.pdf

P | P
R | R

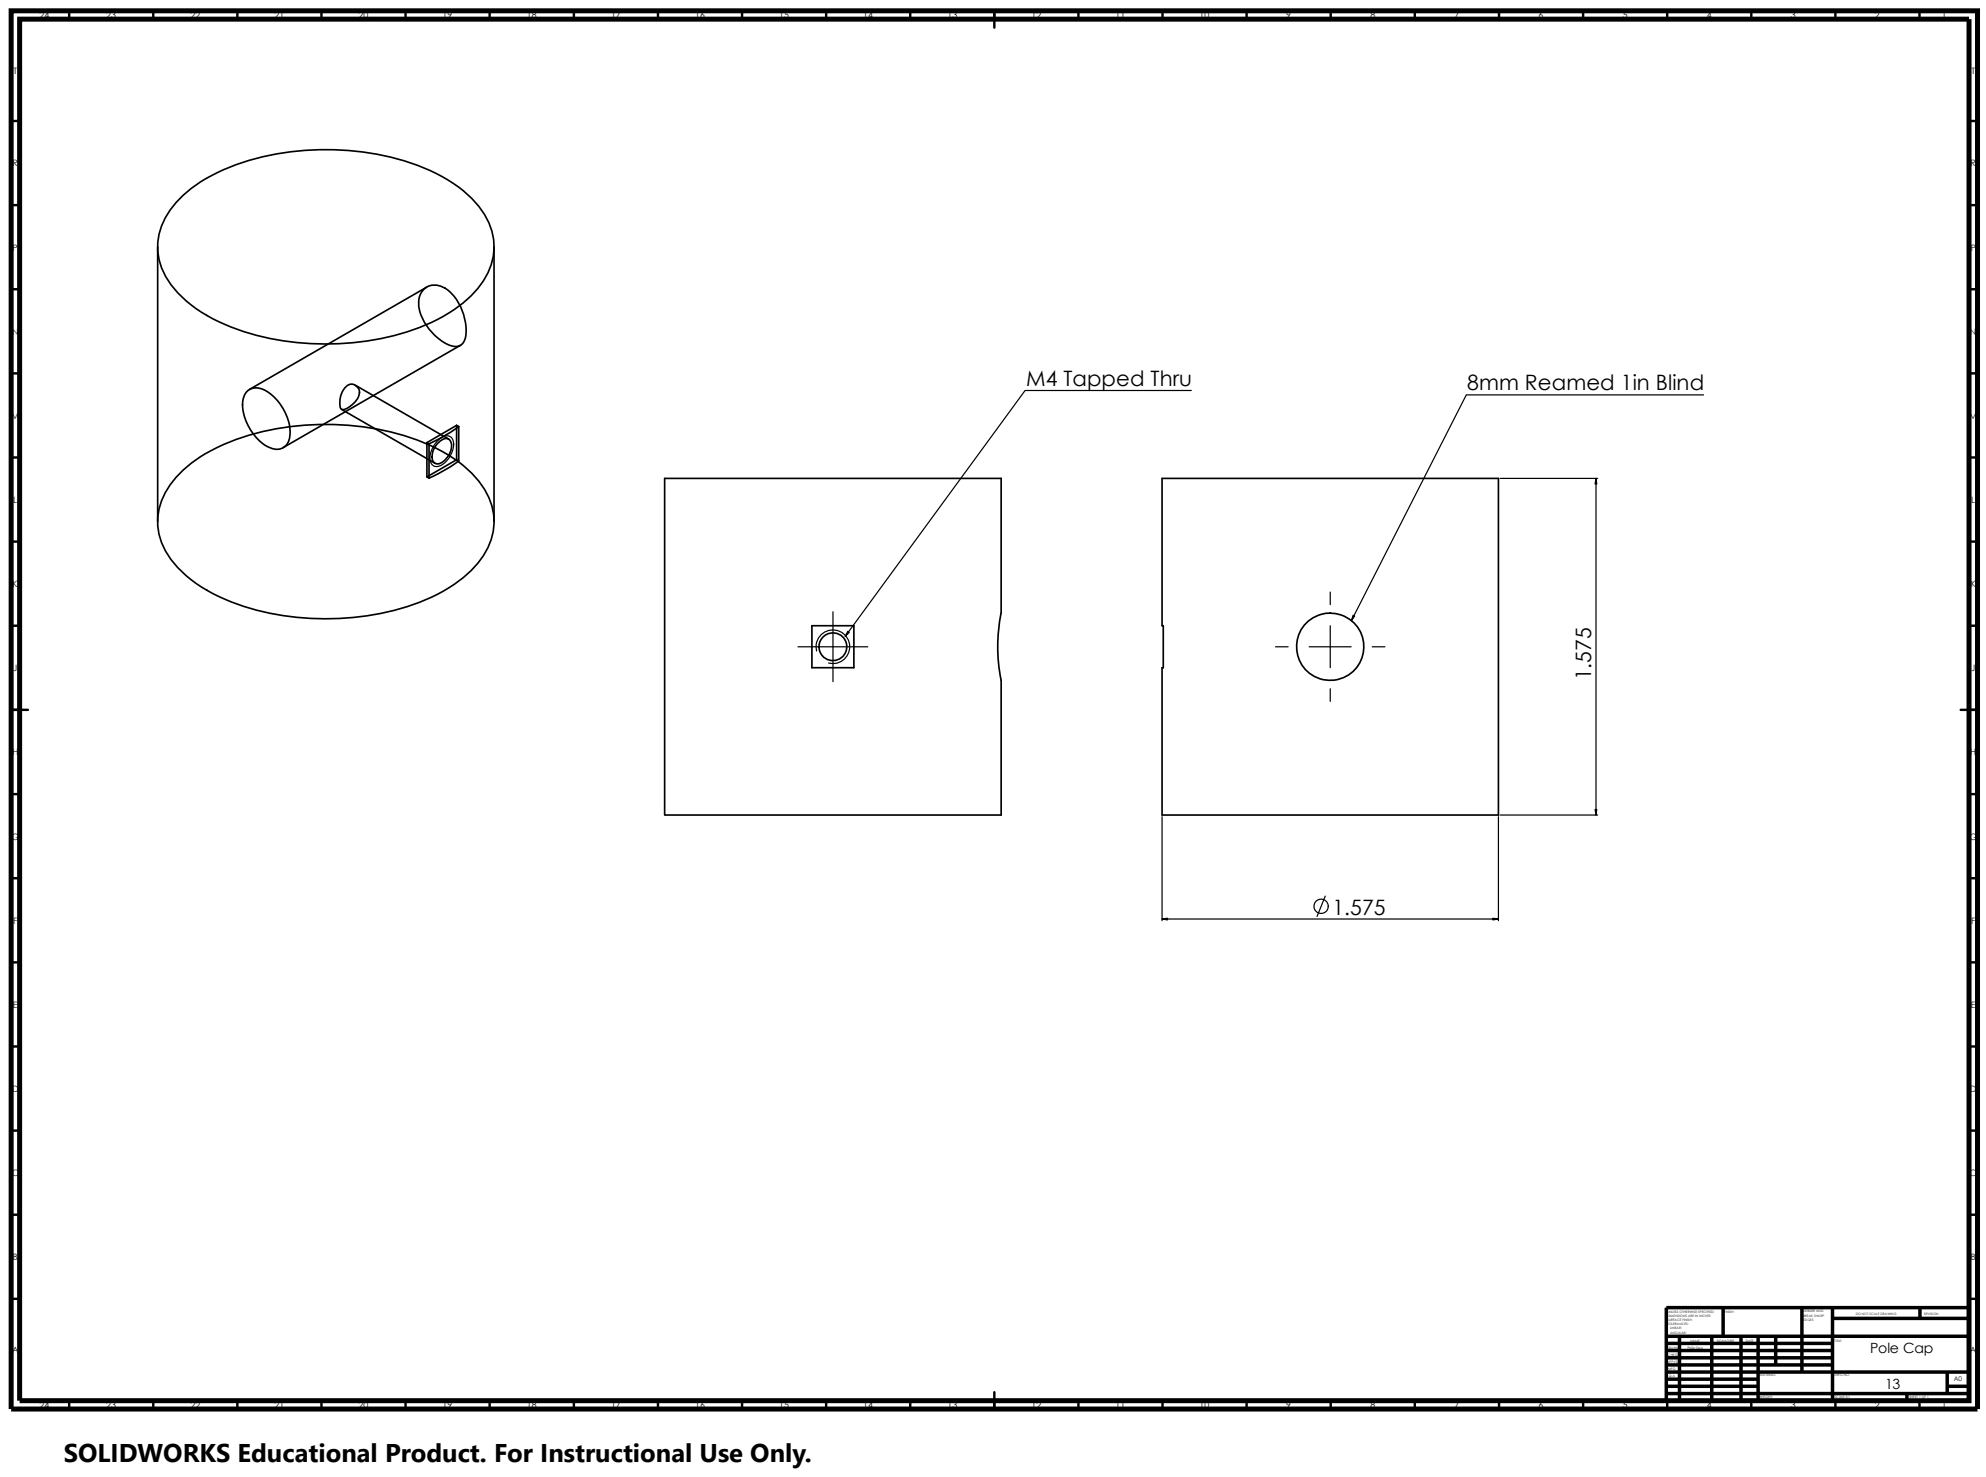
[picture p39: page 1]
WEIGHT:; SCALE:5:1; SHEET 1 OF 1; FINISH:; EDGES; NAME; SIGNATURE; DATE; MATERIAL:; DO NOT SCALE DRAWING; REVISION; TITLE:; DWG NO.; DEBURR AND BREAK SHARP; Pole Cap; M4 Tapped Thru; 8mm Reamed 1in Blind

UNLESS OTHERWISE SPECIFIED:
DIMENSIONS ARE IN INCHES
SURFACE FINISH:
TOLERANCES:
LINEAR:
ANGULAR:

DRAWN | Philip Sieg
CHK'D APPV'D

MFG Q.A

SOLIDWORKS Educational Product. For Instructional Use Only.
