AlpAydinoglu/cartpole_mechanical_setup/Mechanical Design/Documents/Drawings - PDF/14-PCMount.pdf

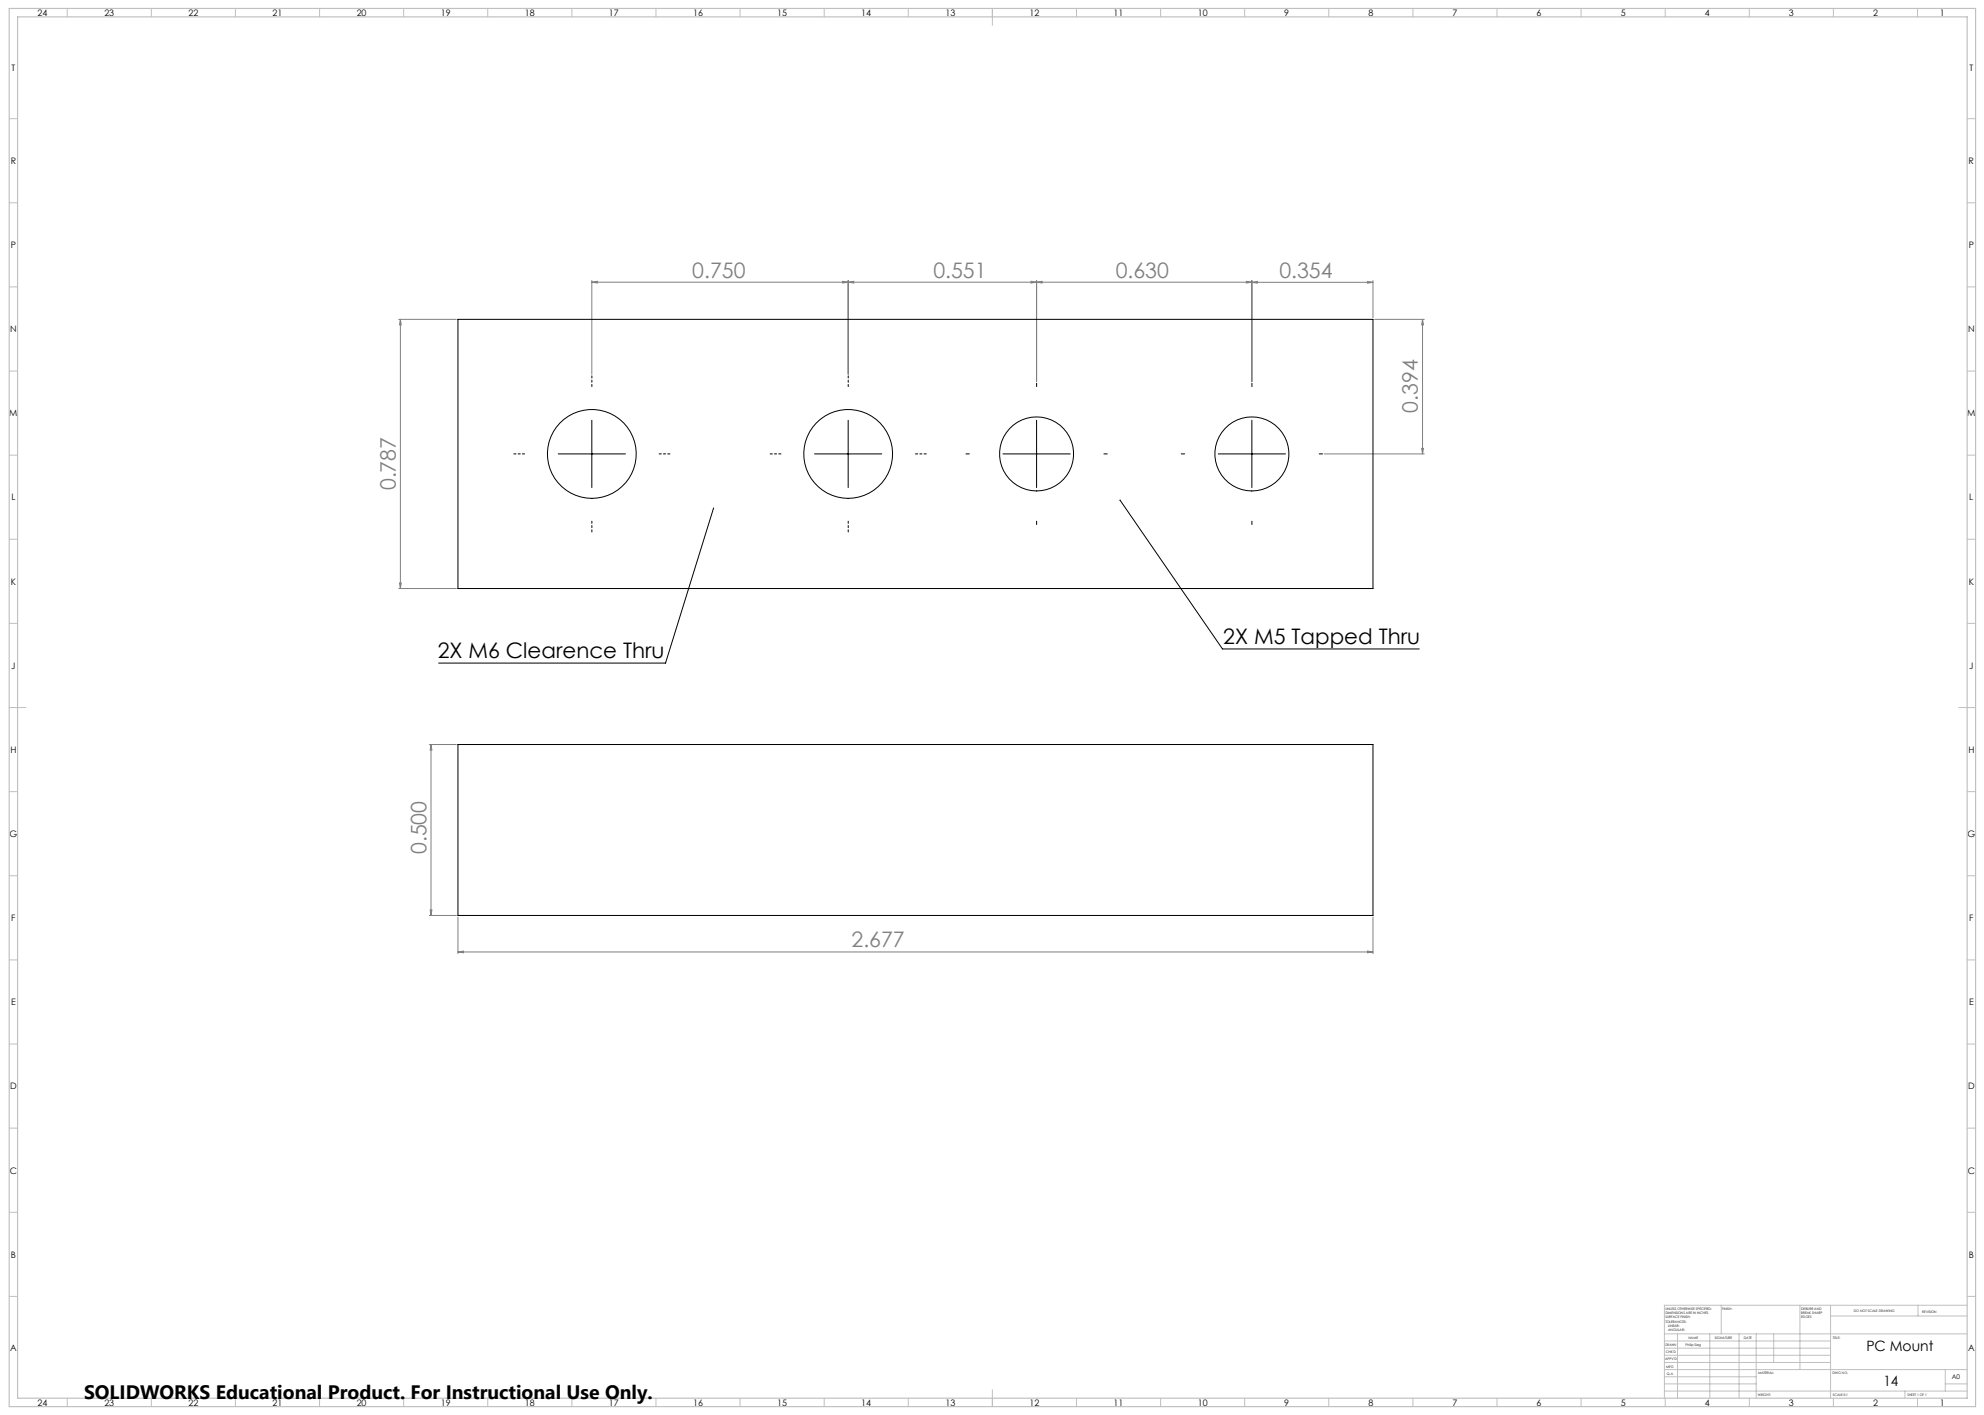
[picture p40: page 1]
FINISH:; DEBURR AND; BREAK SHARP; DO NOT SCALE DRAWING; REVISION; SCALE:5:1; SHEET 1 OF 1

2X M5 Tapped Thru 2X M6 Clearence Thru

UNLESS OTHERWISE SPECIFIED:
DIMENSIONS ARE IN INCHES
SURFACE FINISH:
TOLERANCES:
LINEAR:
ANGULAR:

NAME | SIGNATURE | DATE | | | | TITLE: PC Mount

SOLIDWORKS Educational Product. For Instructional Use Only.

DRAWN | Philip Sieg
CHK'D
APPV'D
MFG
Q.A | | | | MATERIAL: | DWG NO. 14 | A0
