AlpAydinoglu/cartpole_mechanical_setup/Mechanical Design/Documents/Drawings - PDF/15-Wall.pdf

P | P
R | R

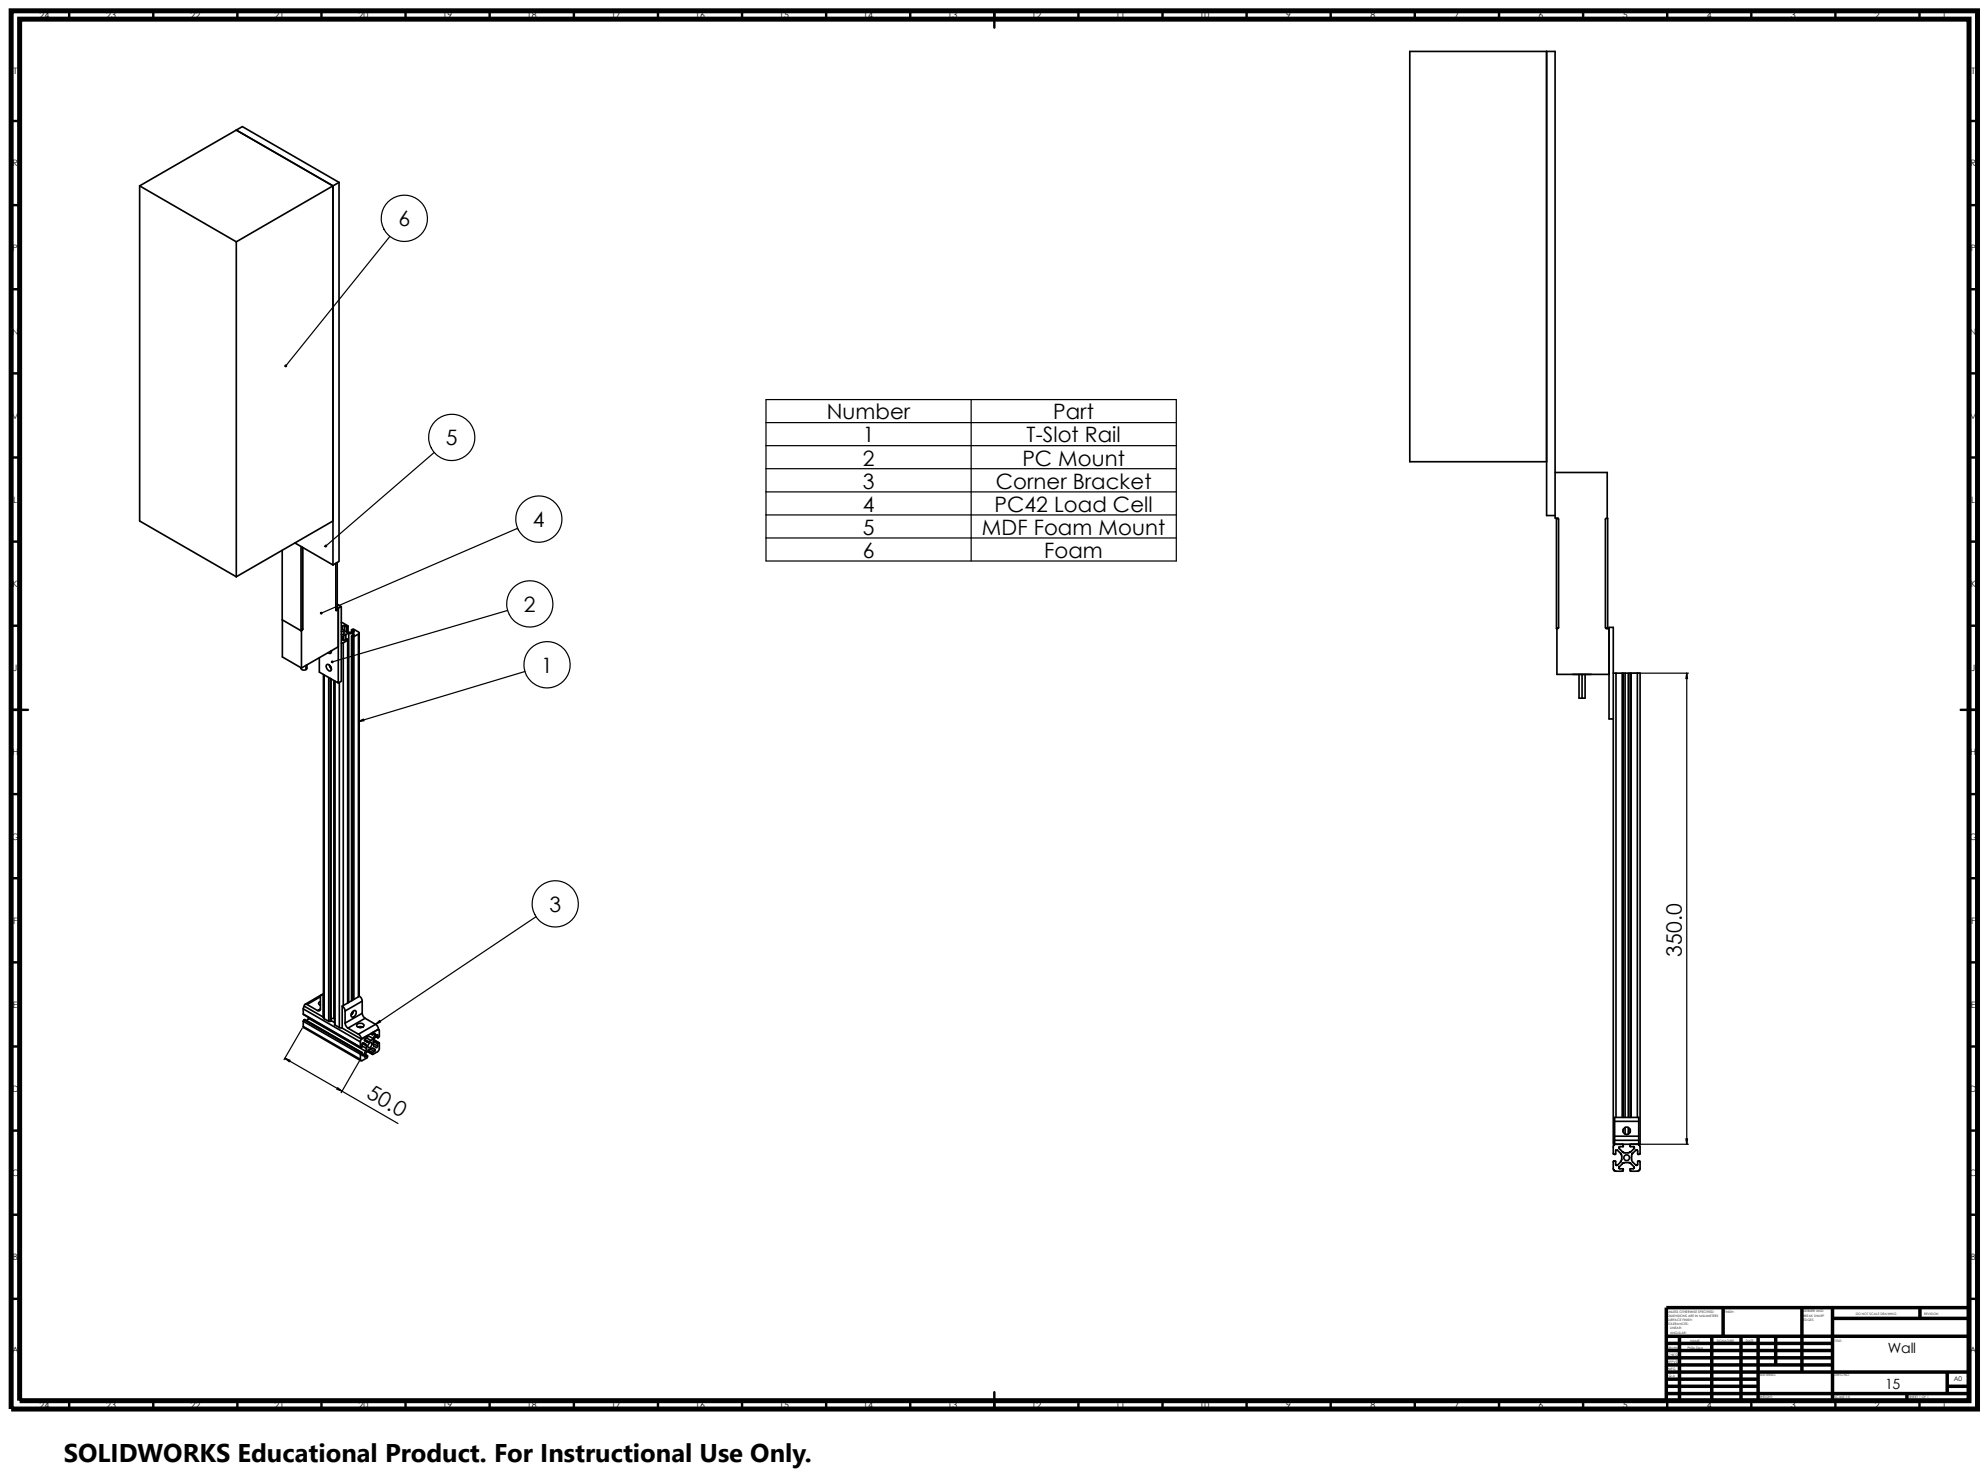
[picture p41: page 1]
WEIGHT:; SCALE:1:5; SHEET 1 OF 1; FINISH:; EDGES; NAME; SIGNATURE; DATE; MATERIAL:; DO NOT SCALE DRAWING; REVISION; TITLE:; DWG NO.; DEBURR AND BREAK SHARP; Wall

Number | Part
1 | T-Slot Rail
2 | PC Mount
3 | Corner Bracket
4 | PC42 Load Cell
5 | MDF Foam Mount
6 | Foam

UNLESS OTHERWISE SPECIFIED:
DIMENSIONS ARE IN MILLIMETERS
SURFACE FINISH:
TOLERANCES:
LINEAR:
ANGULAR:

DRAWN | Philip Sieg
CHK'D APPV'D

MFG Q.A

SOLIDWORKS Educational Product. For Instructional Use Only.
