AlpAydinoglu/cartpole_mechanical_setup/Mechanical Design/Documents/Drawings - PDF/16-TwistGuard.pdf

P | P
R | R

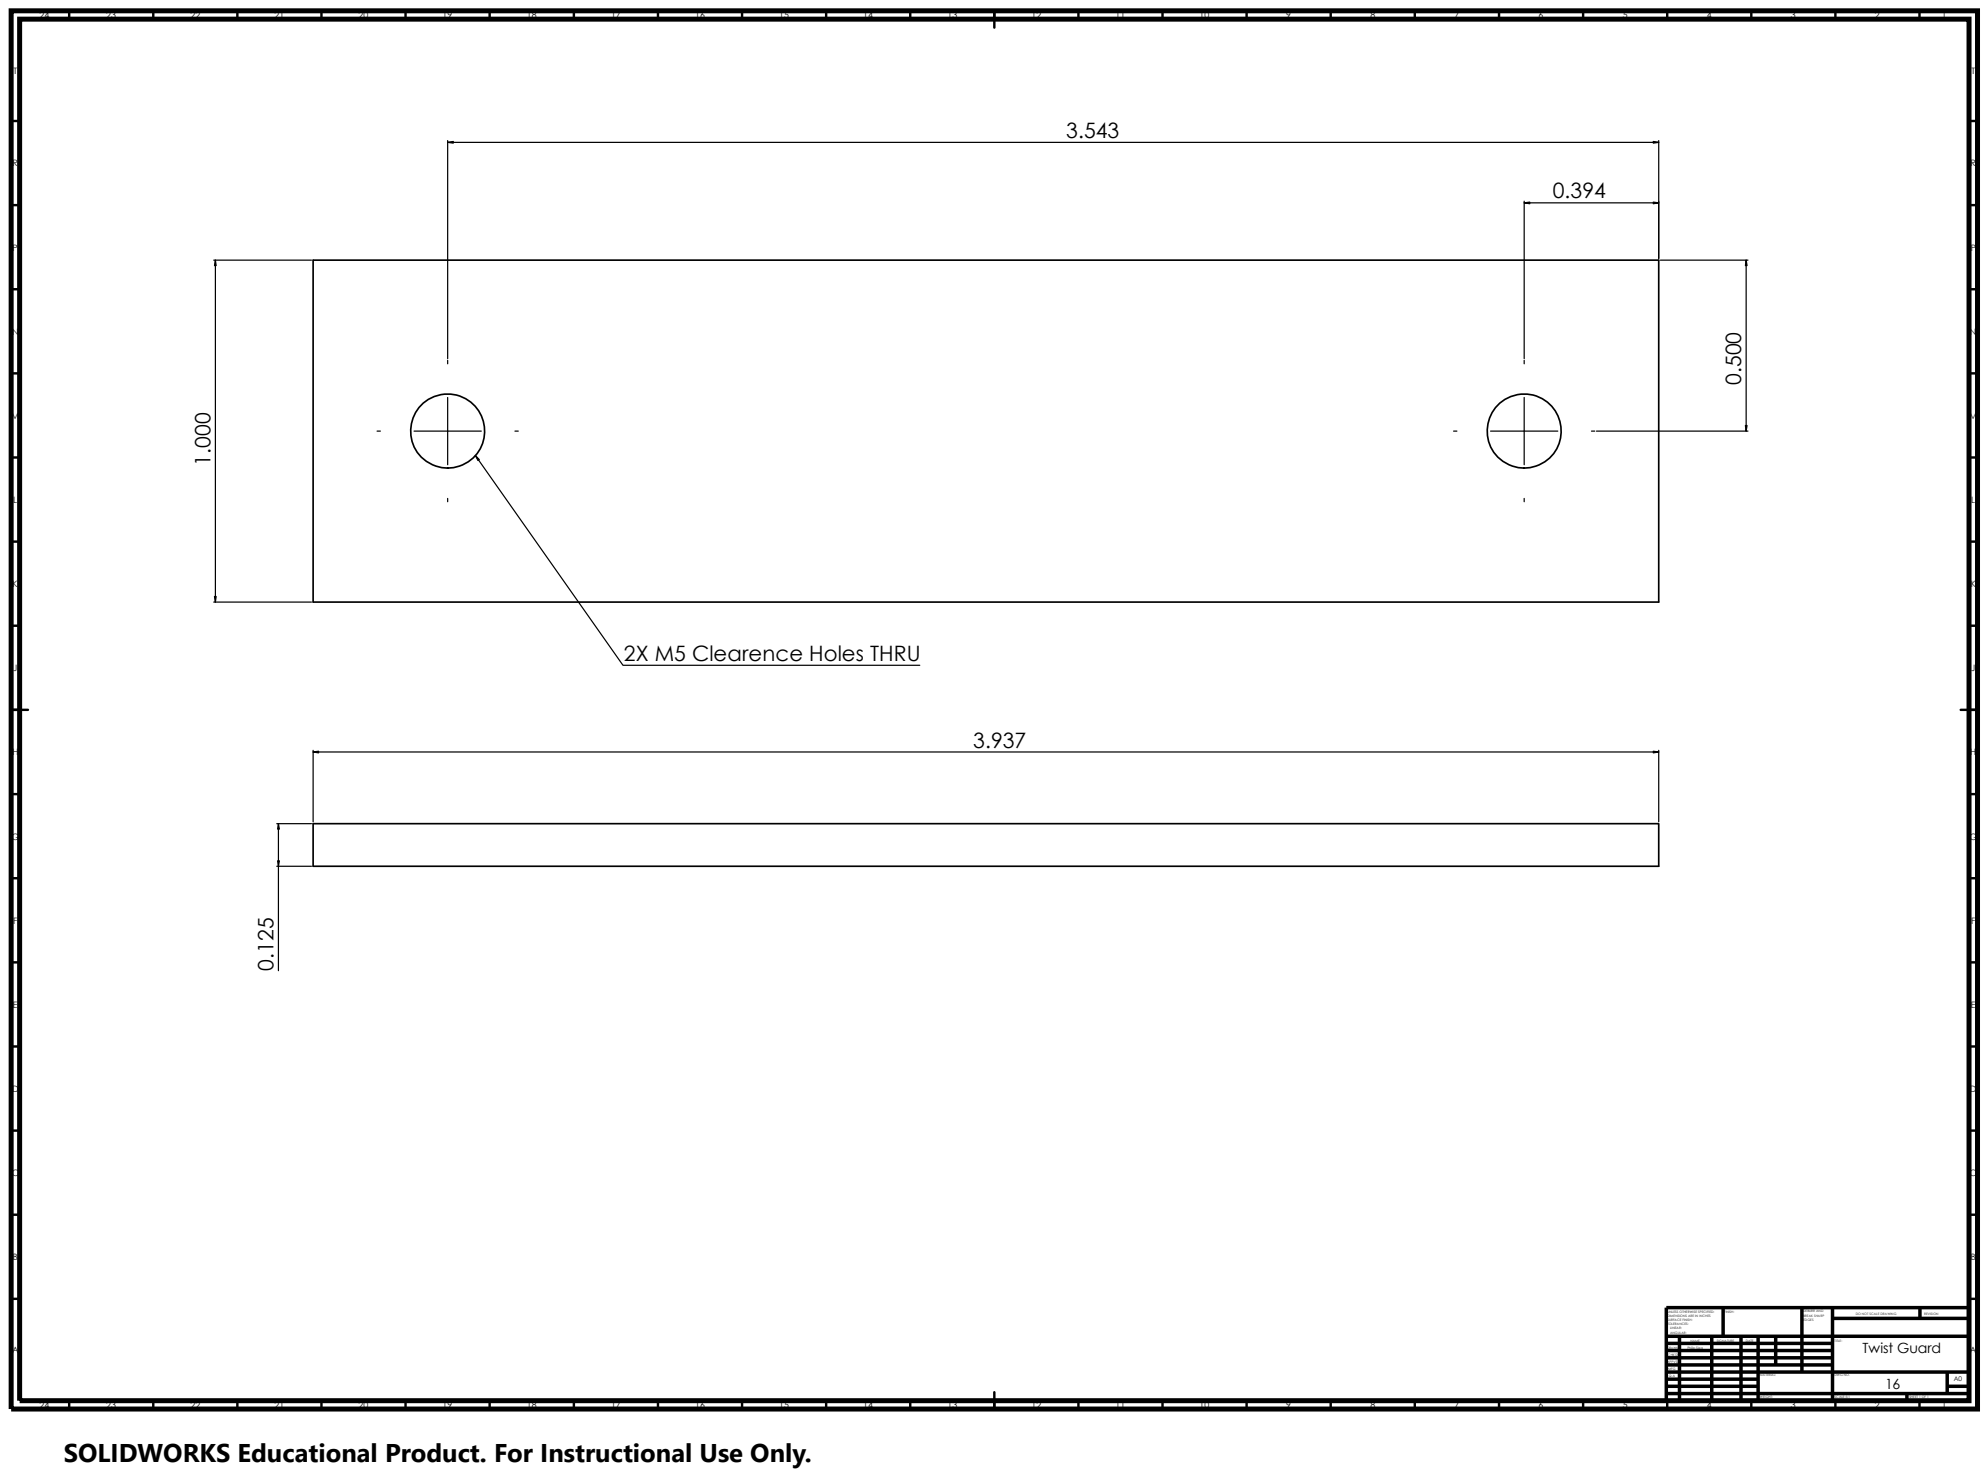
[picture p42: page 1]
WEIGHT:; SHEET 1 OF 1; DWG NO.; FINISH:; EDGES; NAME; SIGNATURE; DATE; MATERIAL:; DO NOT SCALE DRAWING; REVISION; TITLE:; SCALE:5:1; DEBURR AND BREAK SHARP; Twist Guard

2X M5 Clearence Holes THRU

UNLESS OTHERWISE SPECIFIED:
DIMENSIONS ARE IN INCHES
SURFACE FINISH:
TOLERANCES:
LINEAR:
ANGULAR:

DRAWN | Philip Sieg
CHK'D APPV'D

MFG Q.A

SOLIDWORKS Educational Product. For Instructional Use Only.
