AlpAydinoglu/cartpole_mechanical_setup/Mechanical Design/Documents/Drawings - PDF/17-beltTensionerEM.PDF

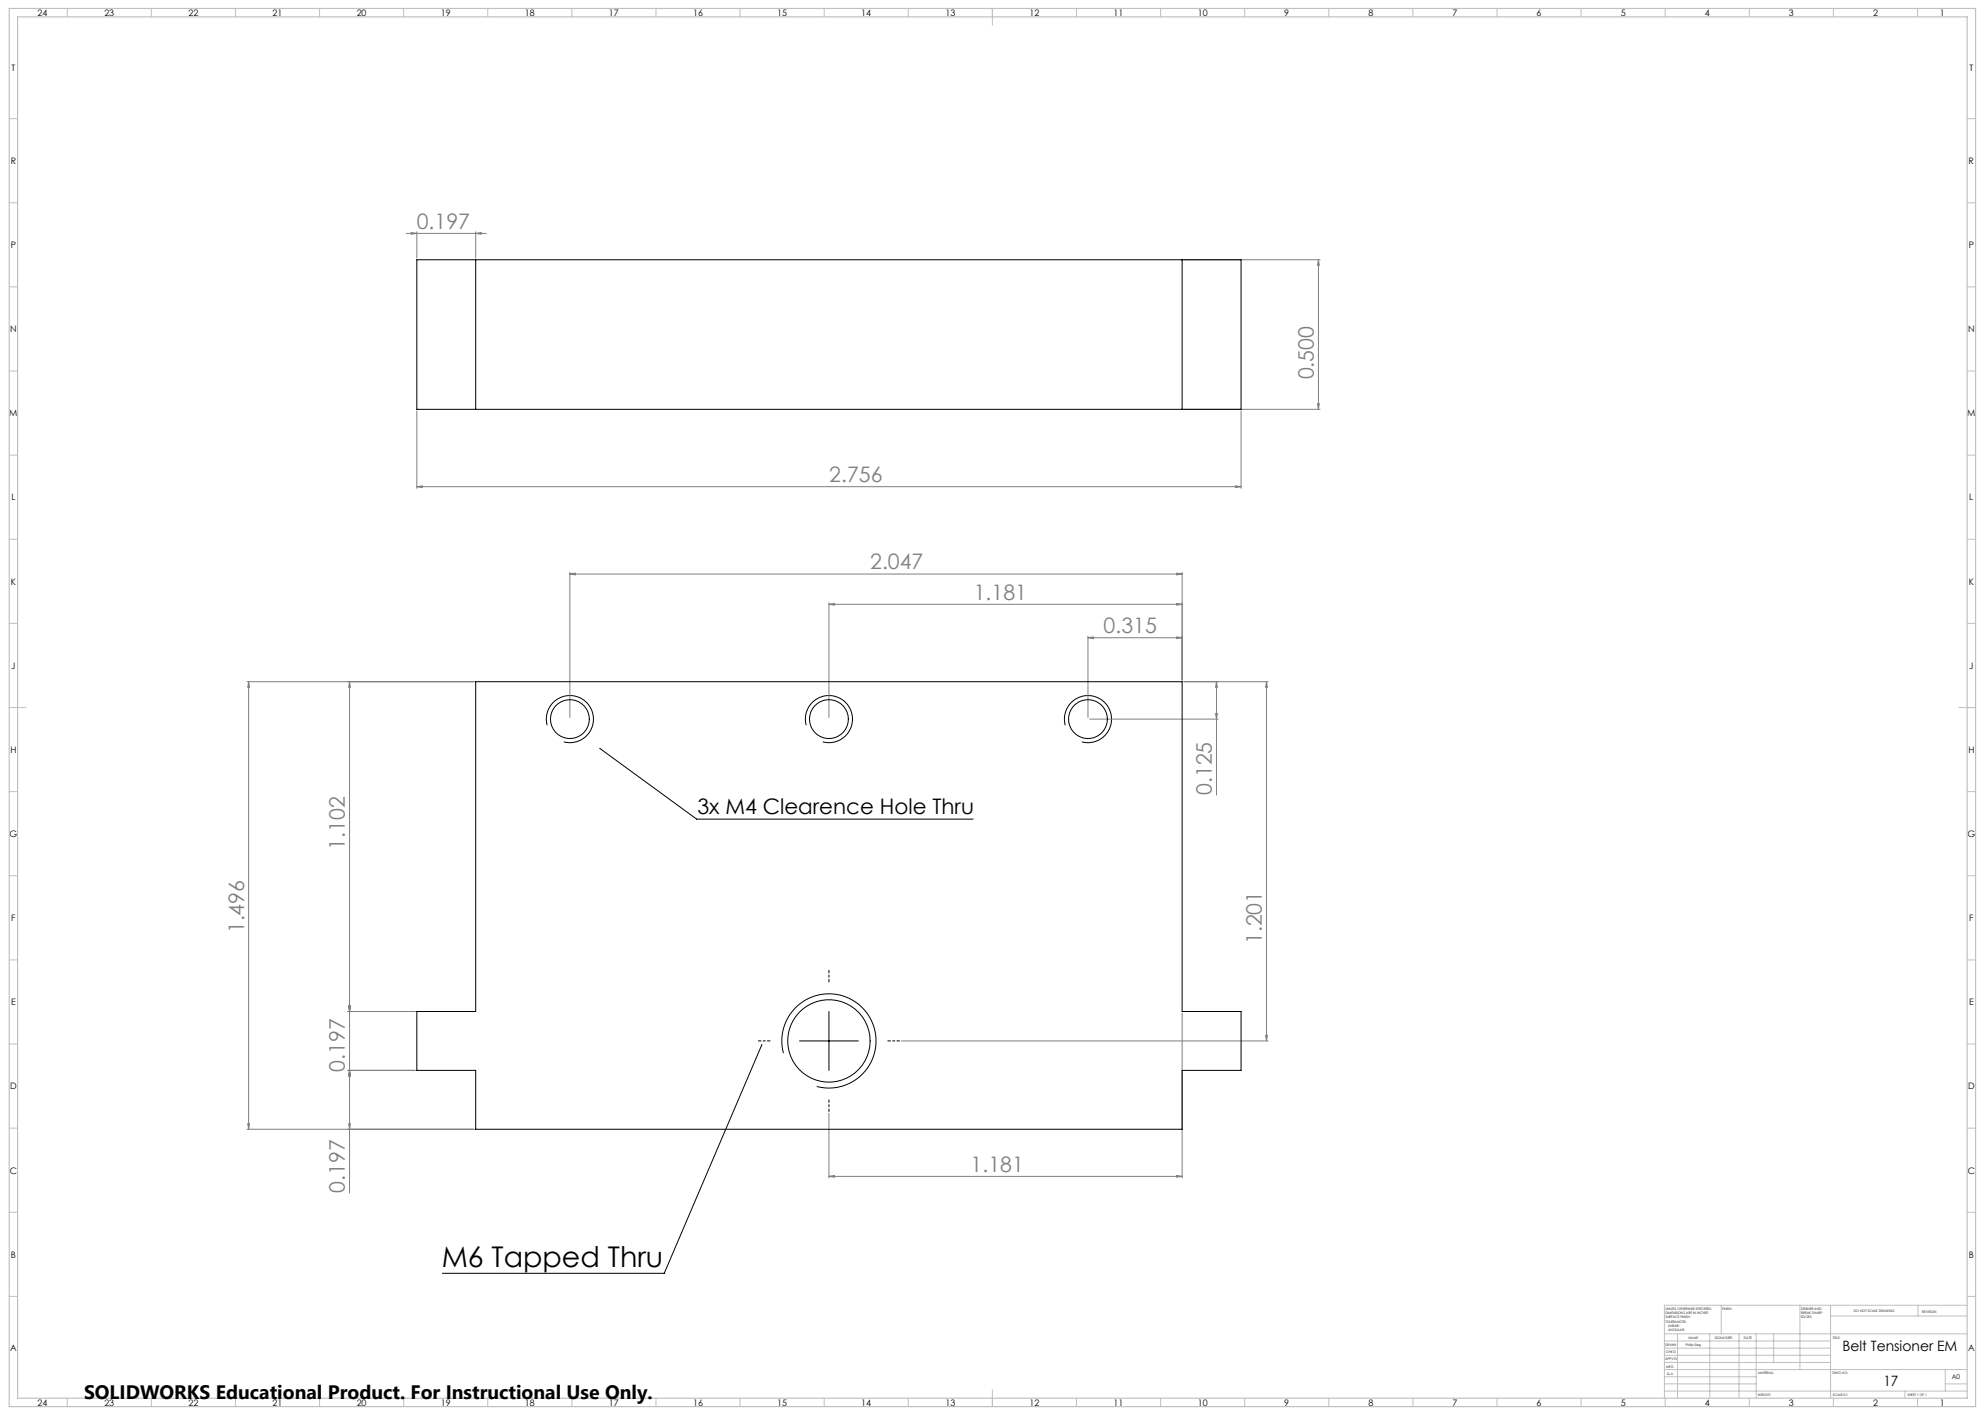
[picture p43: page 1]
M6 Tapped Thru; FINISH:; DEBURR AND; BREAK SHARP; DO NOT SCALE DRAWING; REVISION; SCALE:5:1; SHEET 1 OF 1

3x M4 Clearence Hole Thru

UNLESS OTHERWISE SPECIFIED:
DIMENSIONS ARE IN INCHES
SURFACE FINISH:
TOLERANCES:
LINEAR:
ANGULAR:

NAME | SIGNATURE | DATE | | | | TITLE: Belt Tensioner EM

SOLIDWORKS Educational Product. For Instructional Use Only.

DRAWN | Philip Sieg
CHK'D
APPV'D
MFG
Q.A | | | | MATERIAL: | DWG NO. 17 | A0
