AlpAydinoglu/cartpole_mechanical_setup/Mechanical Design/Documents/Drawings - PDF/18-outerEM.PDF

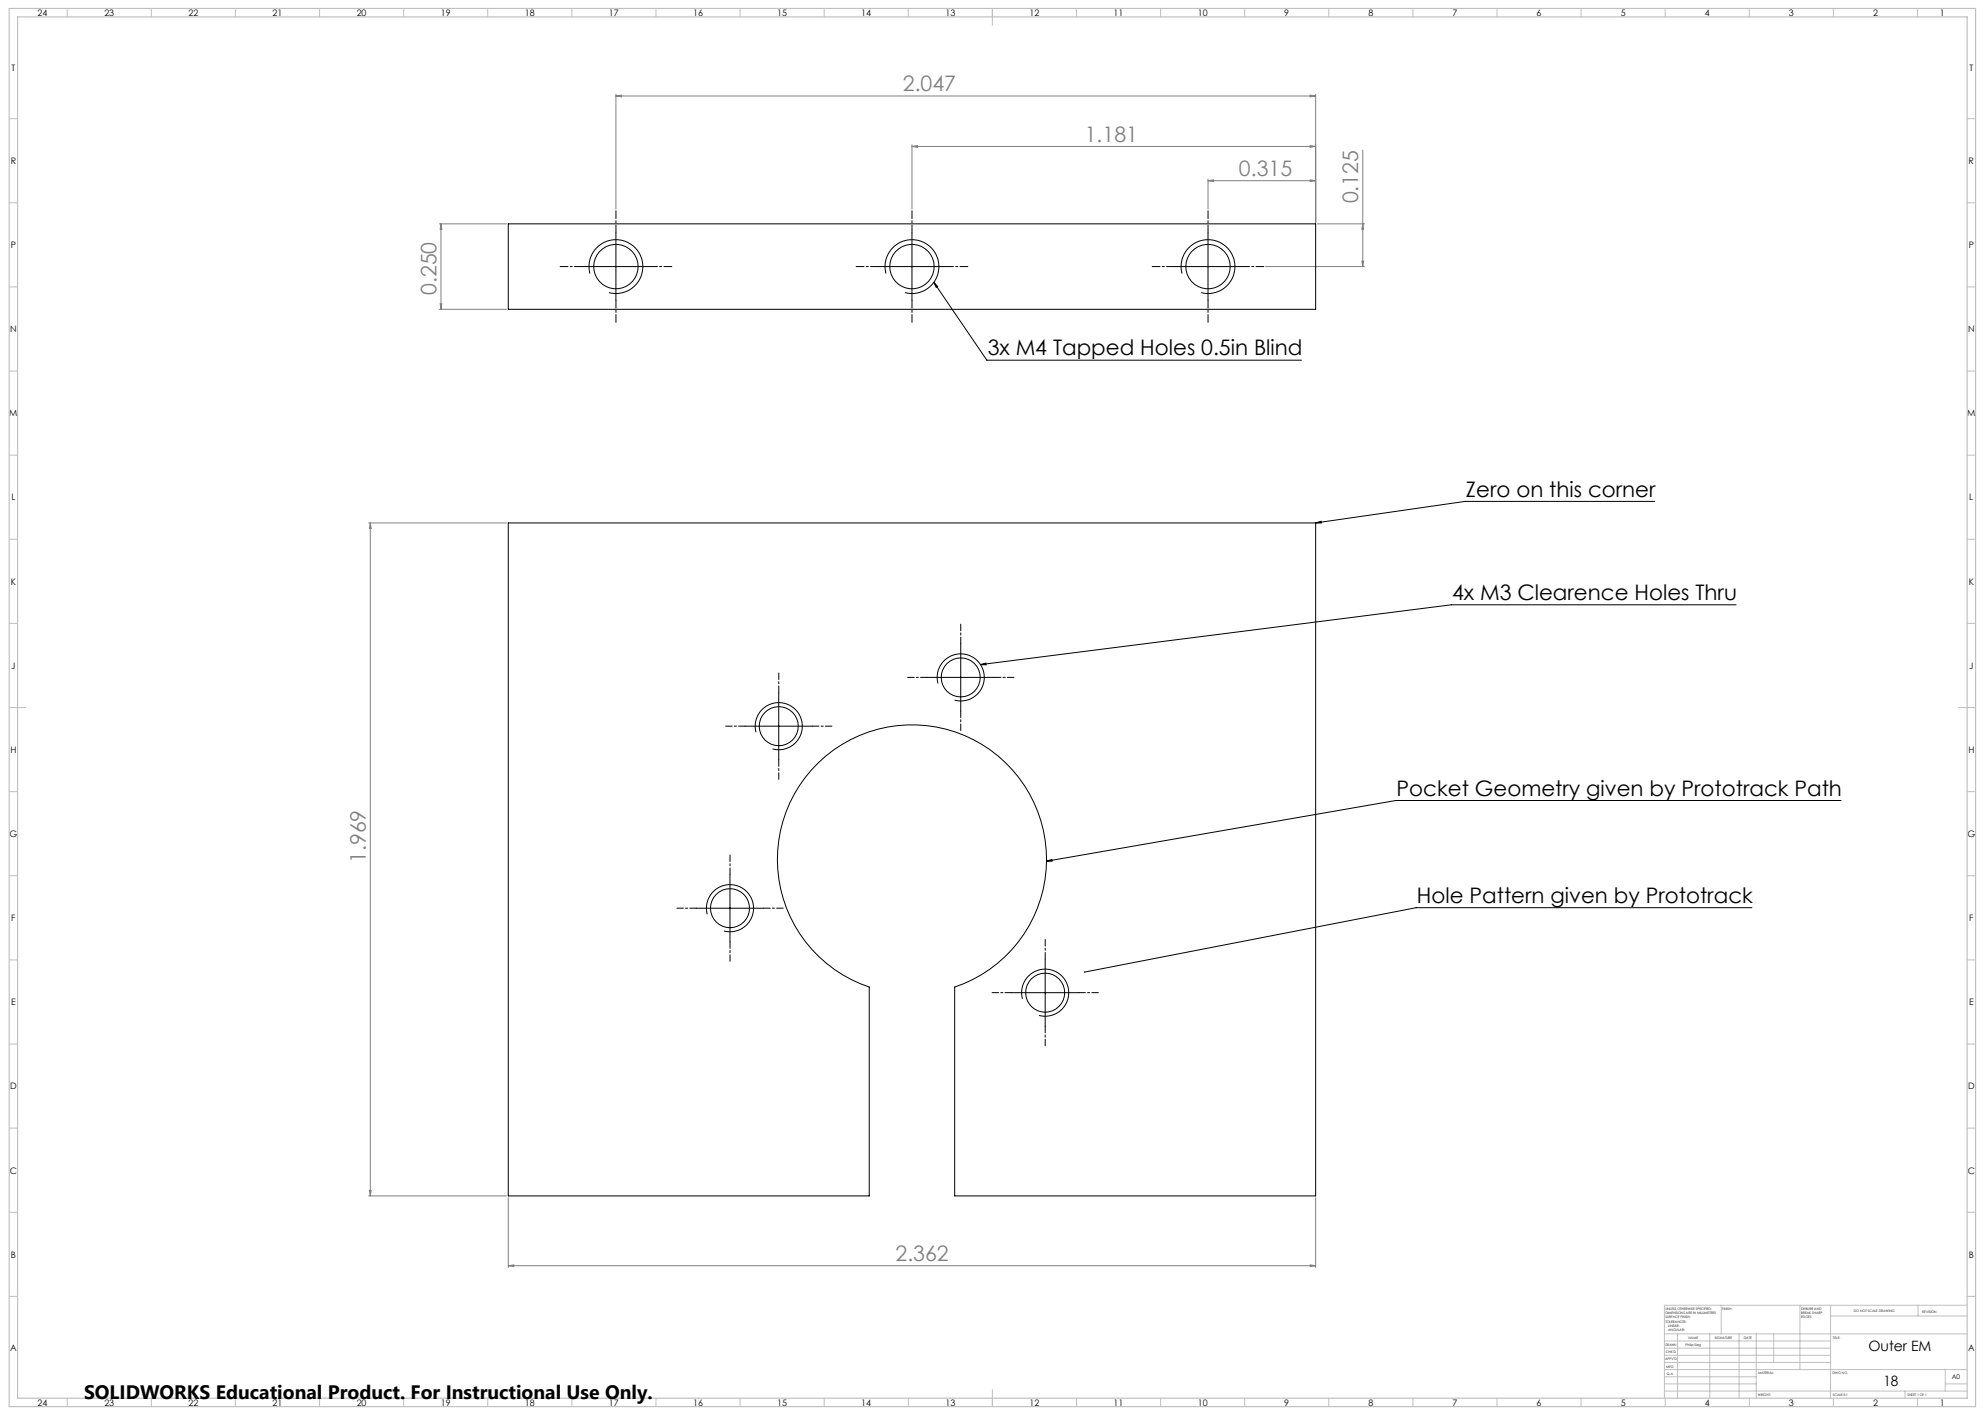
[picture p44: page 1]
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

3x M4 Tapped Holes 0.5in Blind

Zero on this corner

4x M3 Clearence Holes Thru

Pocket Geometry given by Prototrack Path

Hole Pattern given by Prototrack

UNLESS OTHERWISE SPECIFIED:
DIMENSIONS ARE IN MILLIMETERS
SURFACE FINISH:
TOLERANCES:
LINEAR:
ANGULAR:

NAME | SIGNATURE | DATE | | | | TITLE: Outer EM

SOLIDWORKS Educational Product. For Instructional Use Only.

DRAWN | Philip Sieg
CHK'D
APPV'D
MFG
Q.A | | | | MATERIAL: | DWG NO. 18 | A0
