AlpAydinoglu/cartpole_mechanical_setup/Mechanical Design/Documents/Drawings - PDF/19-smallerCartBase.PDF

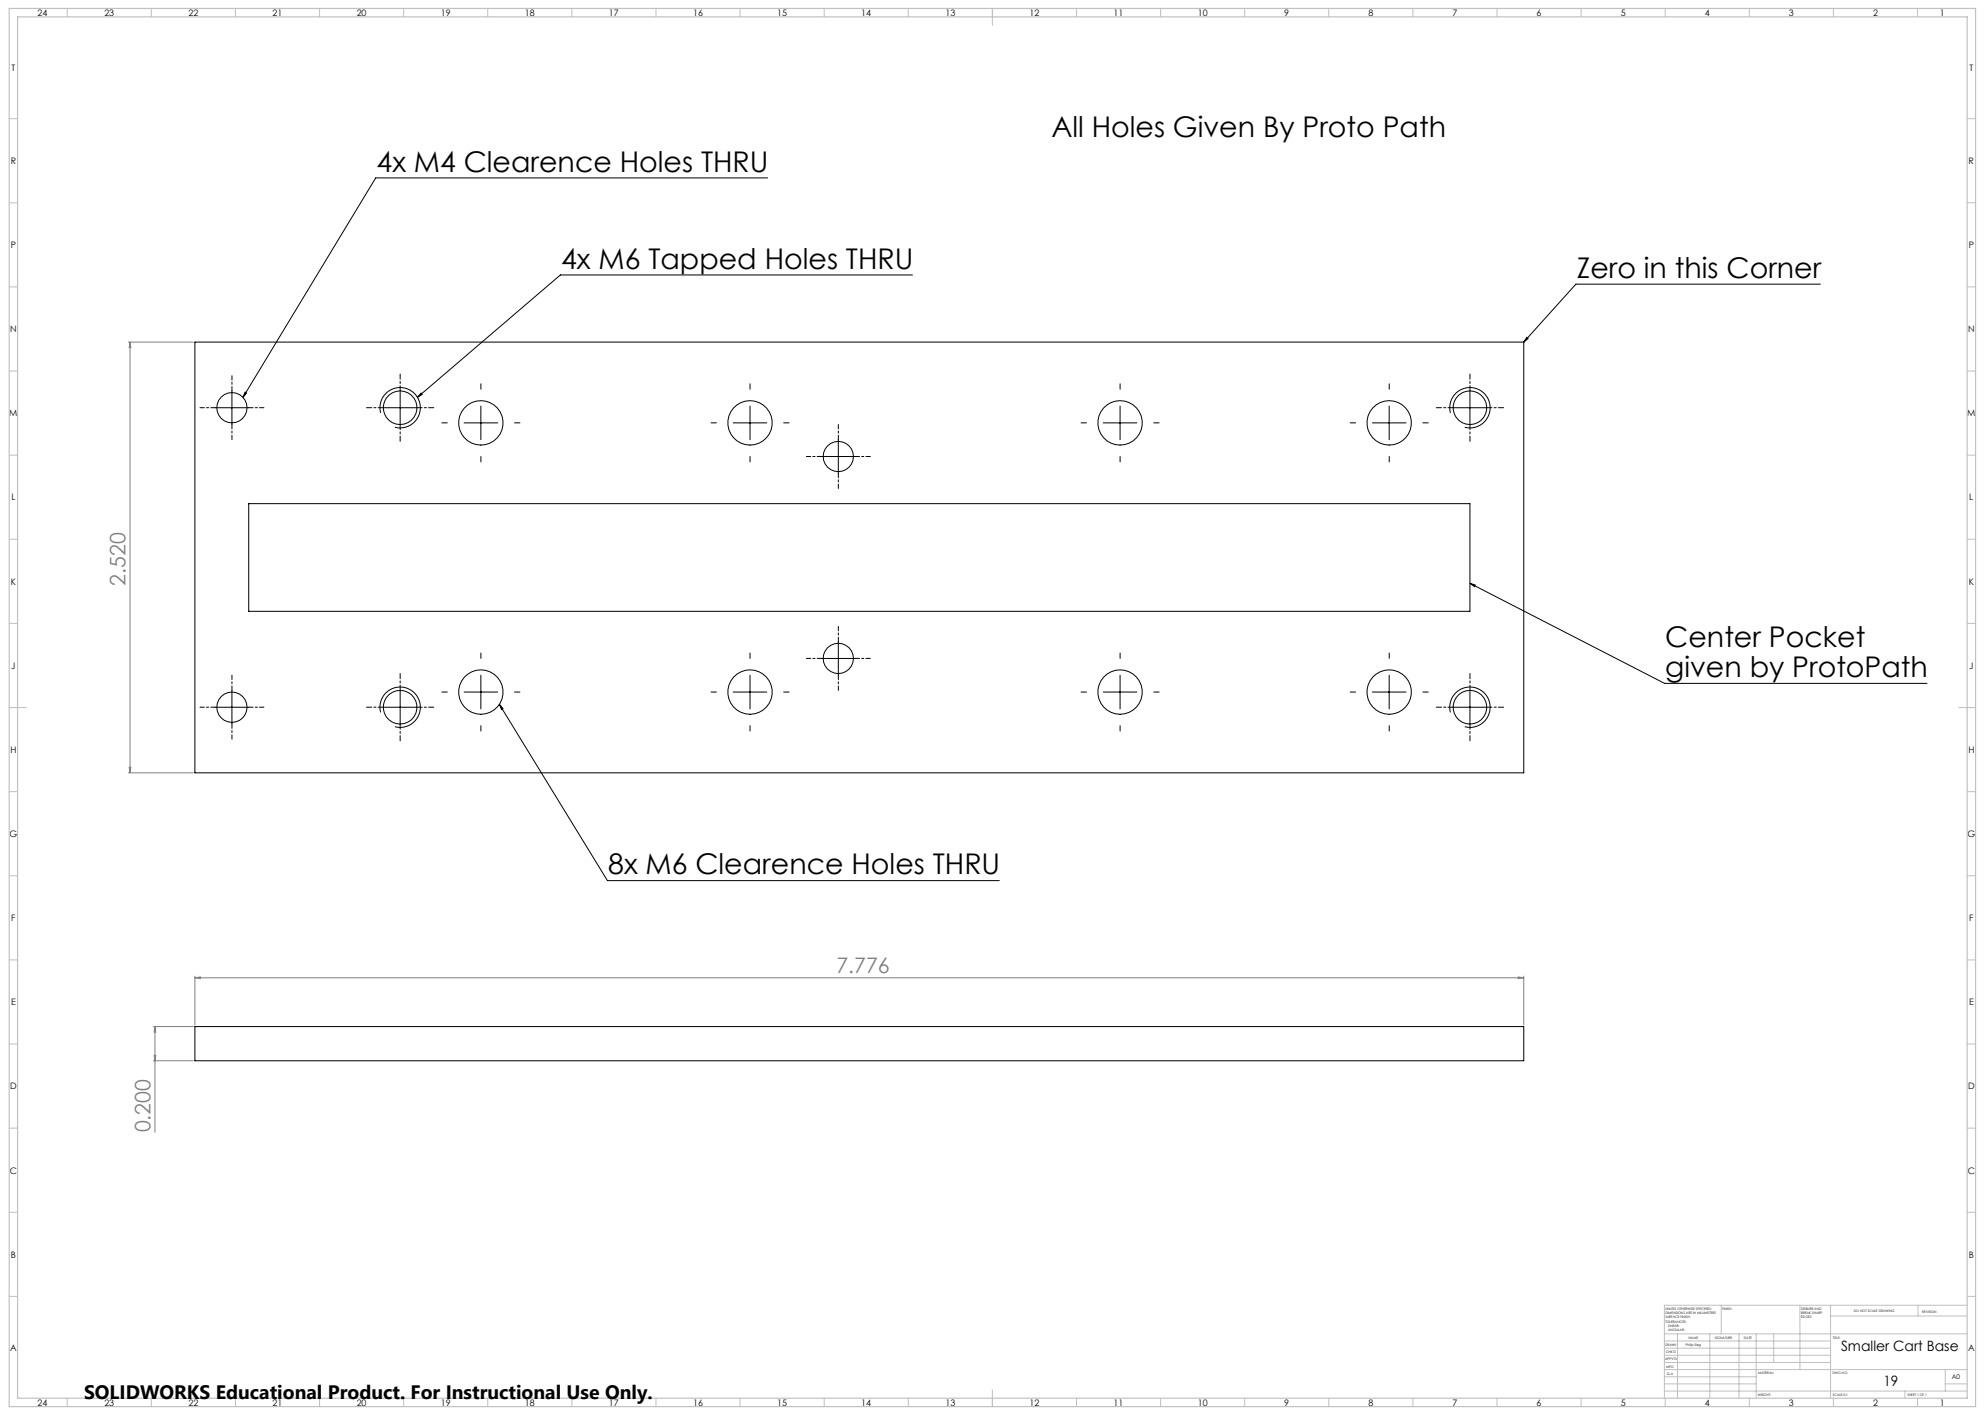
[picture p45: page 1]
FINISH:; DEBURR AND; BREAK SHARP; DO NOT SCALE DRAWING; REVISION; SCALE:2:1; SHEET 1 OF 1

All Holes Given By Proto Path

4x M4 Clearence Holes THRU

4x M6 Tapped Holes THRU

Zero in this Corner

Center Pocket
given by ProtoPath

8x M6 Clearence Holes THRU

UNLESS OTHERWISE SPECIFIED:
DIMENSIONS ARE IN MILLIMETERS
SURFACE FINISH:
TOLERANCES:
LINEAR:
ANGULAR:

NAME | SIGNATURE | DATE | | | | TITLE: Smaller Cart Base

SOLIDWORKS Educational Product. For Instructional Use Only.

DRAWN | Philip Sieg
CHK'D
APPV'D
MFG
Q.A | | | | MATERIAL: | DWG NO. 19 | A0
