AlpAydinoglu/cartpole_mechanical_setup/Mechanical Design/Documents/Drawings - PDF/2-MechanicalBase.pdf

2
3

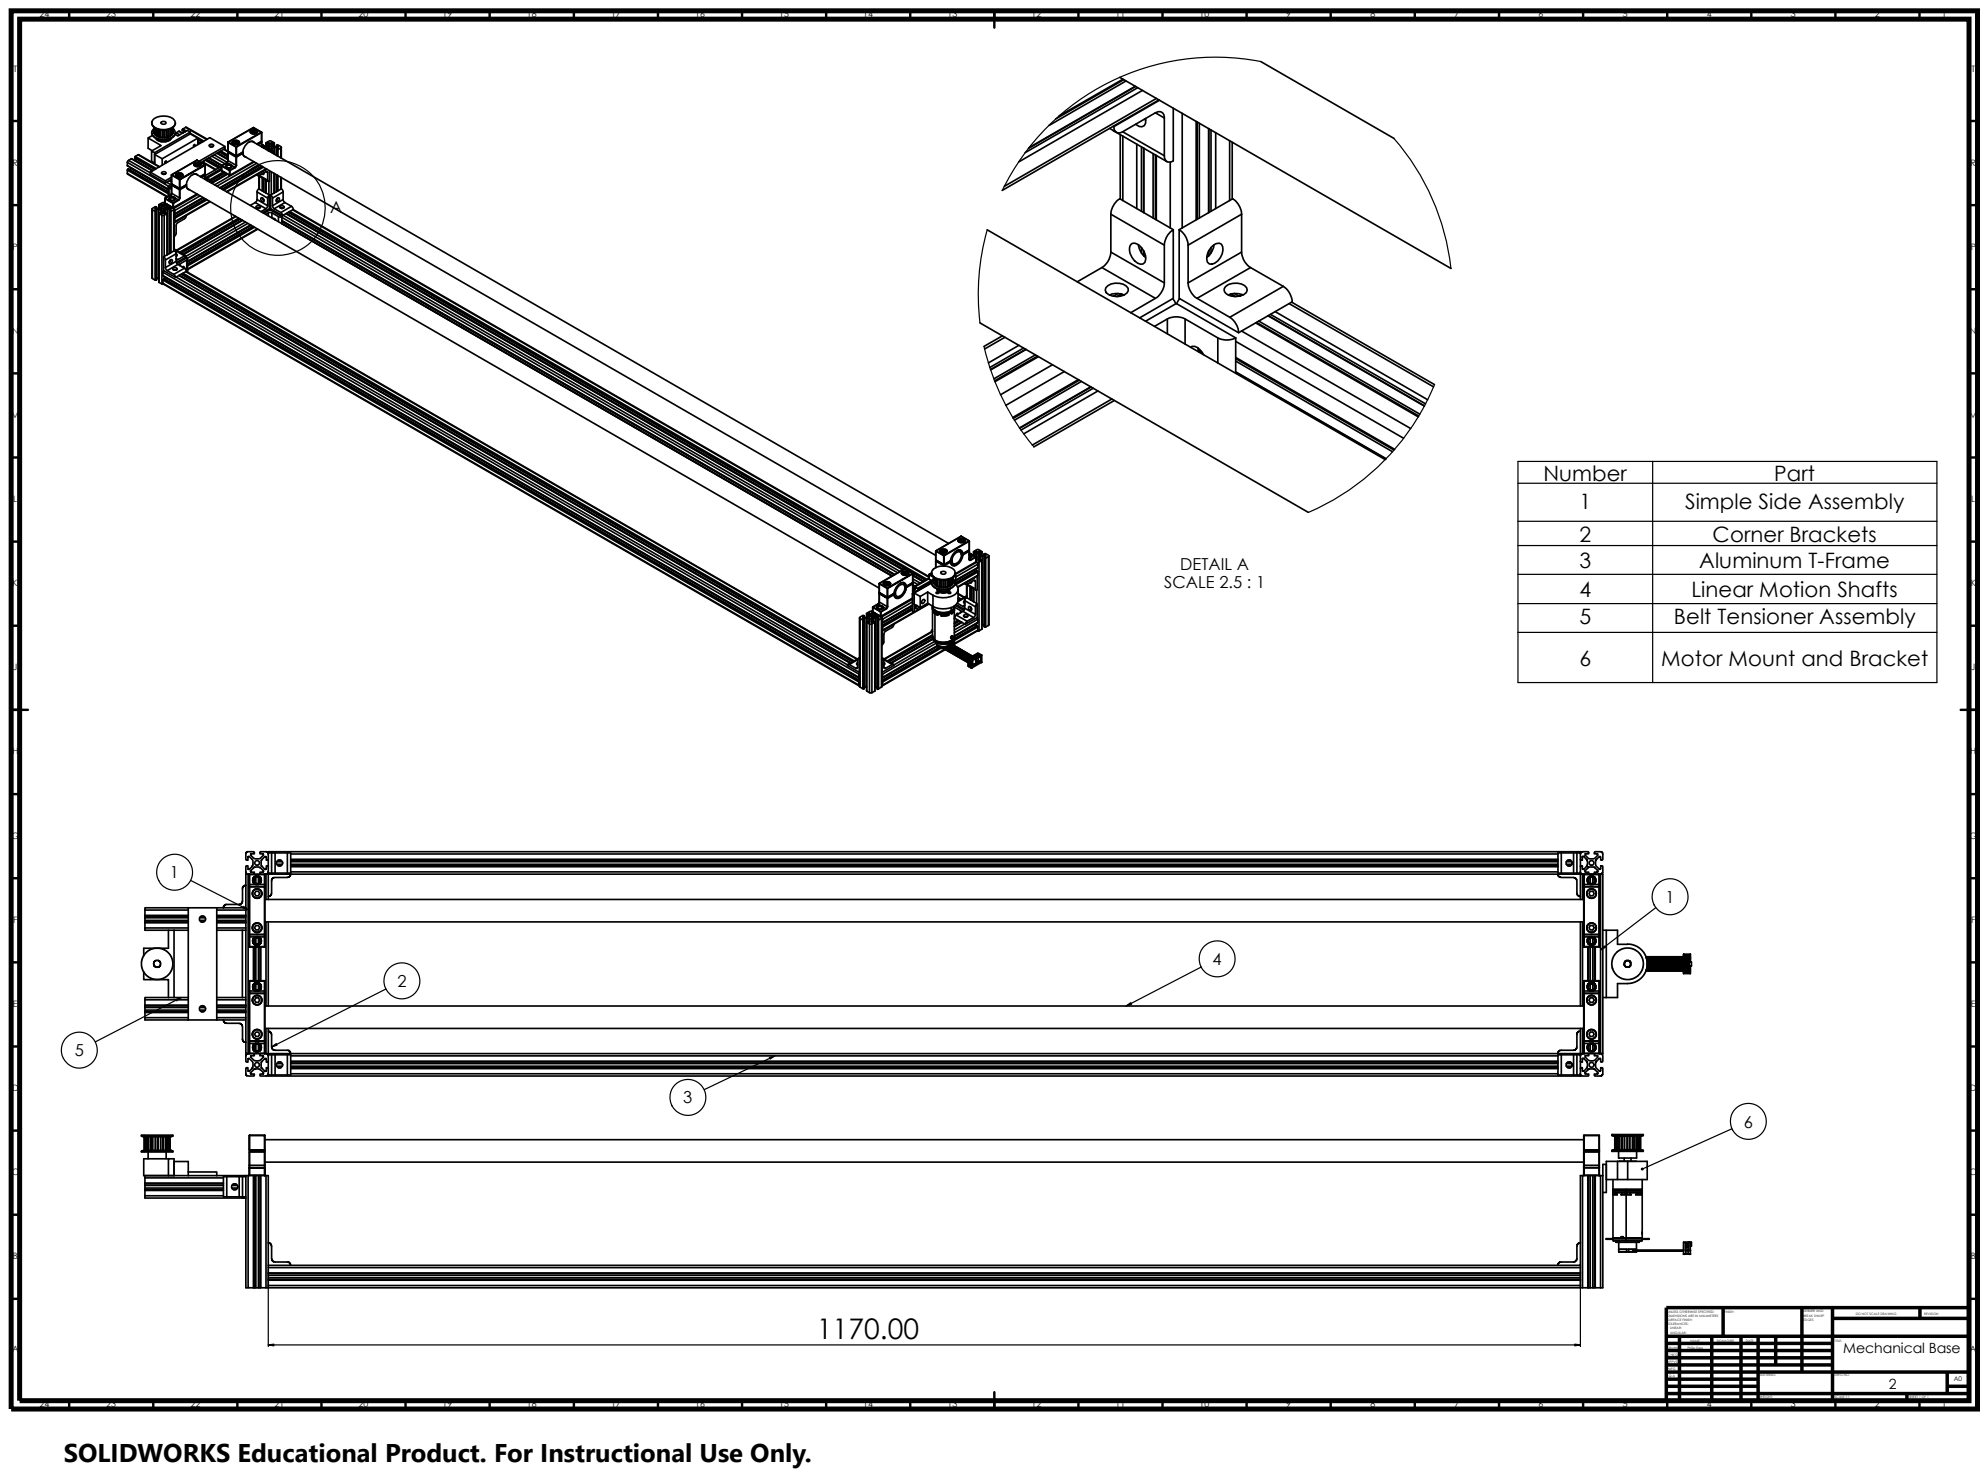
[picture p46: page 1]
FINISH:; EDGES; NAME; SIGNATURE; DATE; MATERIAL:; DO NOT SCALE DRAWING; REVISION; TITLE:; DWG NO.; SCALE:1:1; SHEET 1 OF 1; WEIGHT:; Mechanical Base A; DEBURR AND BREAK SHARP; DETAIL A SCALE 2.5 : 1

Number | Part
1 | Simple Side Assembly
2 | Corner Brackets
3 | Aluminum T-Frame
4 | Linear Motion Shafts
5 | Belt Tensioner Assembly
6 | Motor Mount and Bracket

UNLESS OTHERWISE SPECIFIED:
DIMENSIONS ARE IN MILLIMETERS
SURFACE FINISH:
TOLERANCES:
LINEAR:
ANGULAR:

DRAWN | Philip SIeg
CHK'D APPV'D

MFG Q.A

SOLIDWORKS Educational Product. For Instructional Use Only.
