AlpAydinoglu/cartpole_mechanical_setup/Mechanical Design/Documents/Drawings - PDF/3-BeltTensionerAssemb.pdf

P | P
R | R

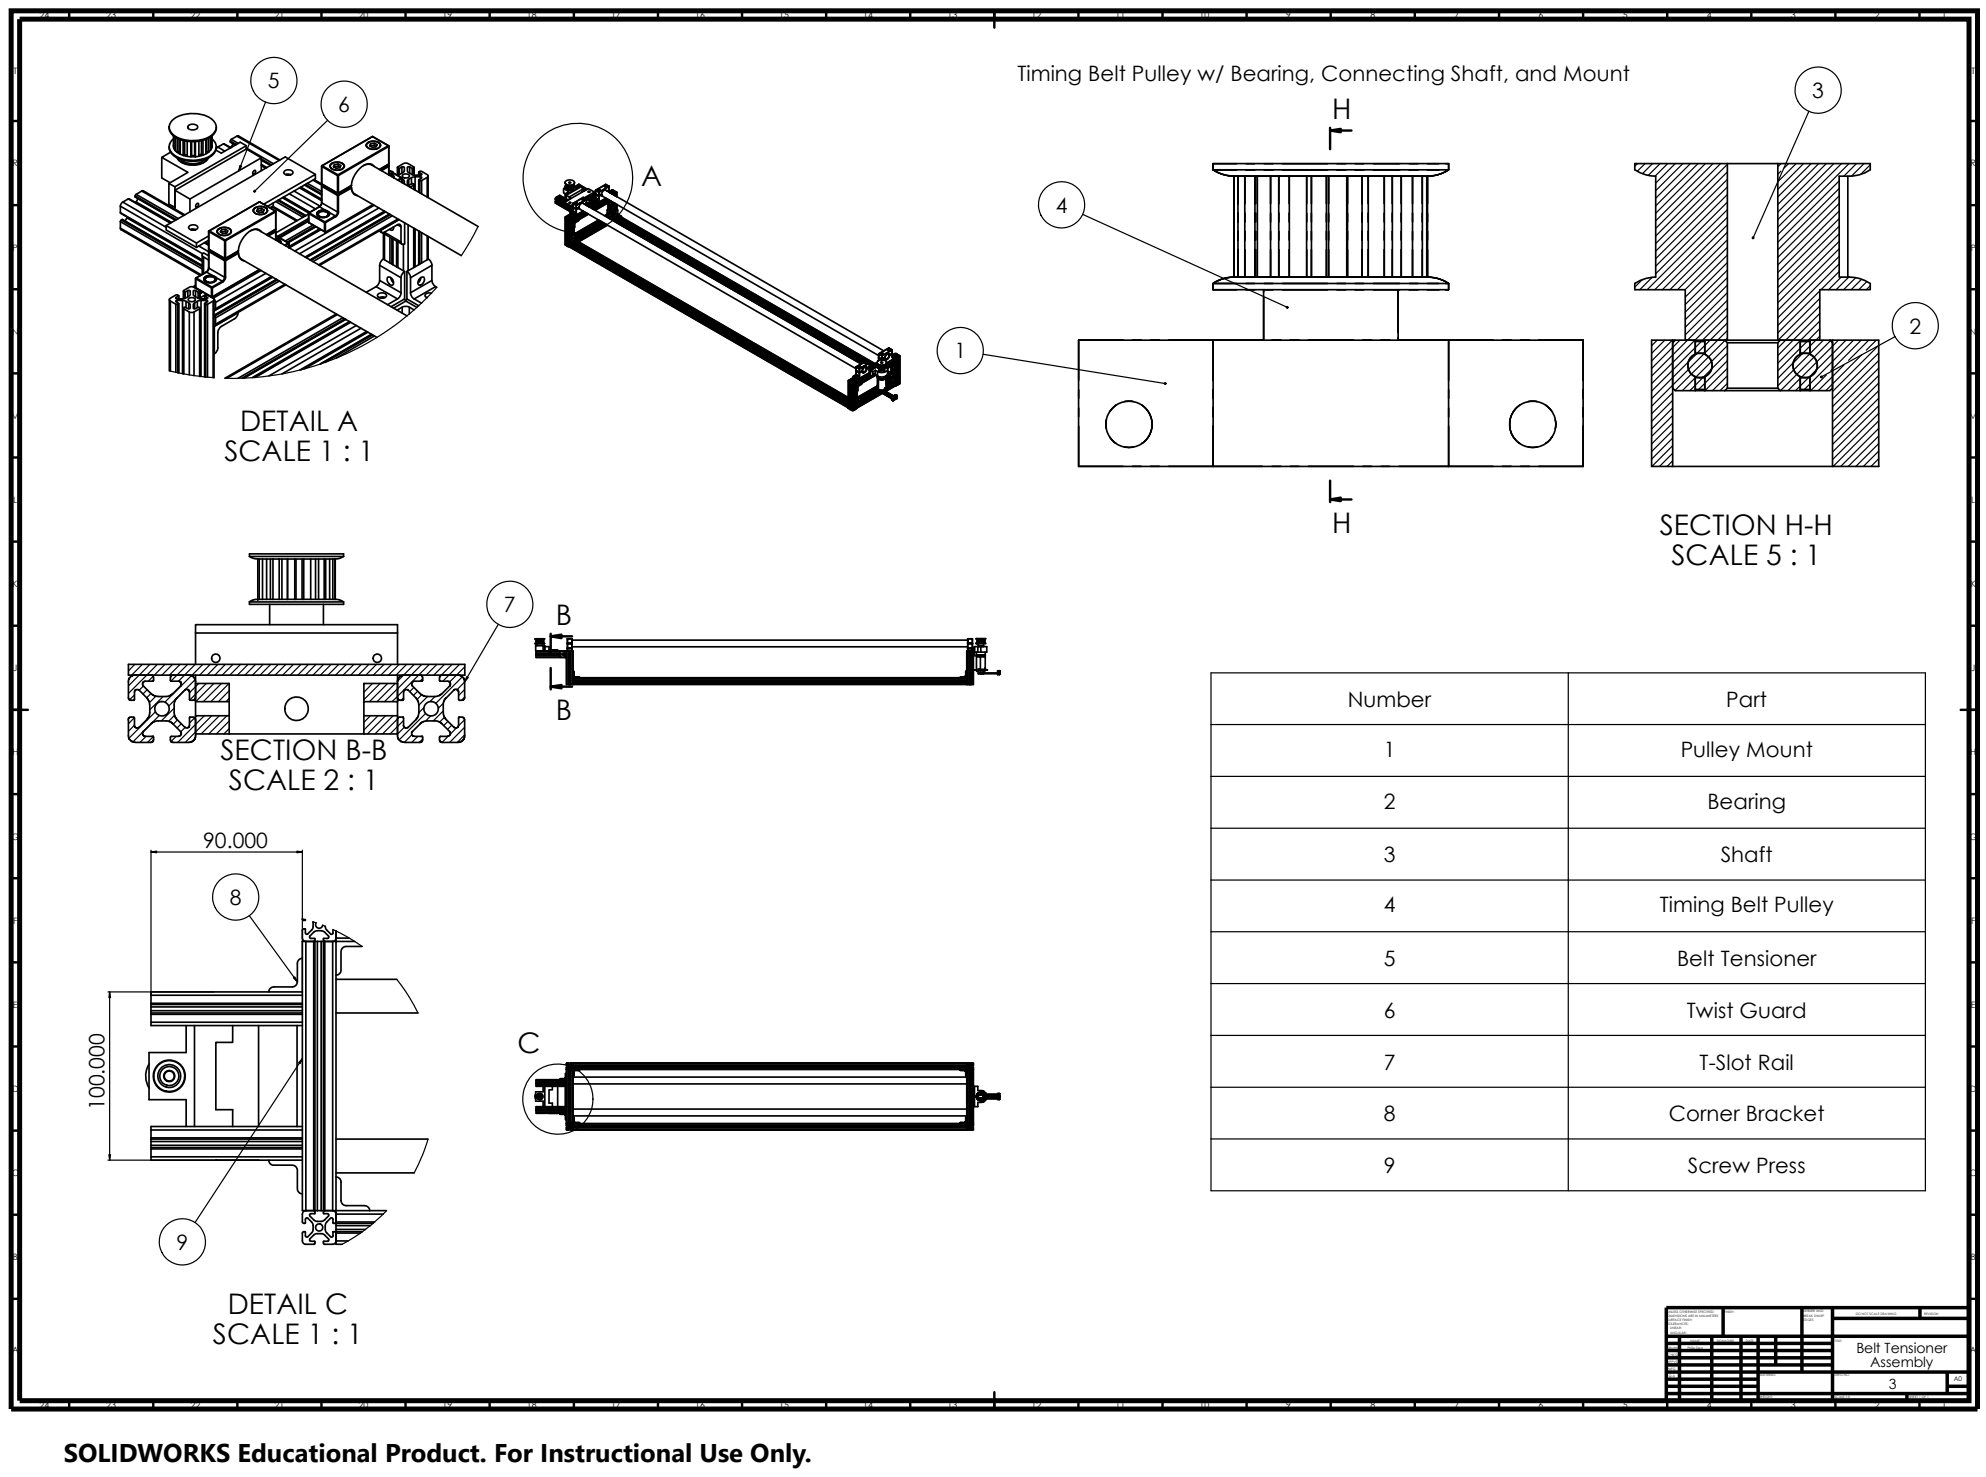
[picture p47: page 1]
BREAK SHARP; WEIGHT:; SHEET 1 OF 1; FINISH:; EDGES; NAME; SIGNATURE; DATE; MATERIAL:; DO NOT SCALE DRAWING; REVISION; TITLE:; DWG NO.; SCALE:1:5; DEBURR AND; Belt Tensioner Assembly; SCALE 1 : 1; DETAIL A; DETAIL C; SECTION B-B SCALE 2 : 1; SECTION H-H; SCALE 5 : 1; Number; Part; Pulley Mount; Bearing; Shaft; Timing Belt Pulley; Belt Tensioner; Twist Guard; T-Slot Rail; Corner Bracket; Screw Press

Timing Belt Pulley w/ Bearing, Connecting Shaft, and Mount

UNLESS OTHERWISE SPECIFIED:
DIMENSIONS ARE IN MILLIMETERS
SURFACE FINISH:
TOLERANCES:
LINEAR:
ANGULAR:

DRAWN | Philip Sieg
CHK'D APPV'D

MFG Q.A

SOLIDWORKS Educational Product. For Instructional Use Only.
