AlpAydinoglu/cartpole_mechanical_setup/Mechanical Design/Documents/Drawings - PDF/4-PulleyMount.pdf

P | P
R | R

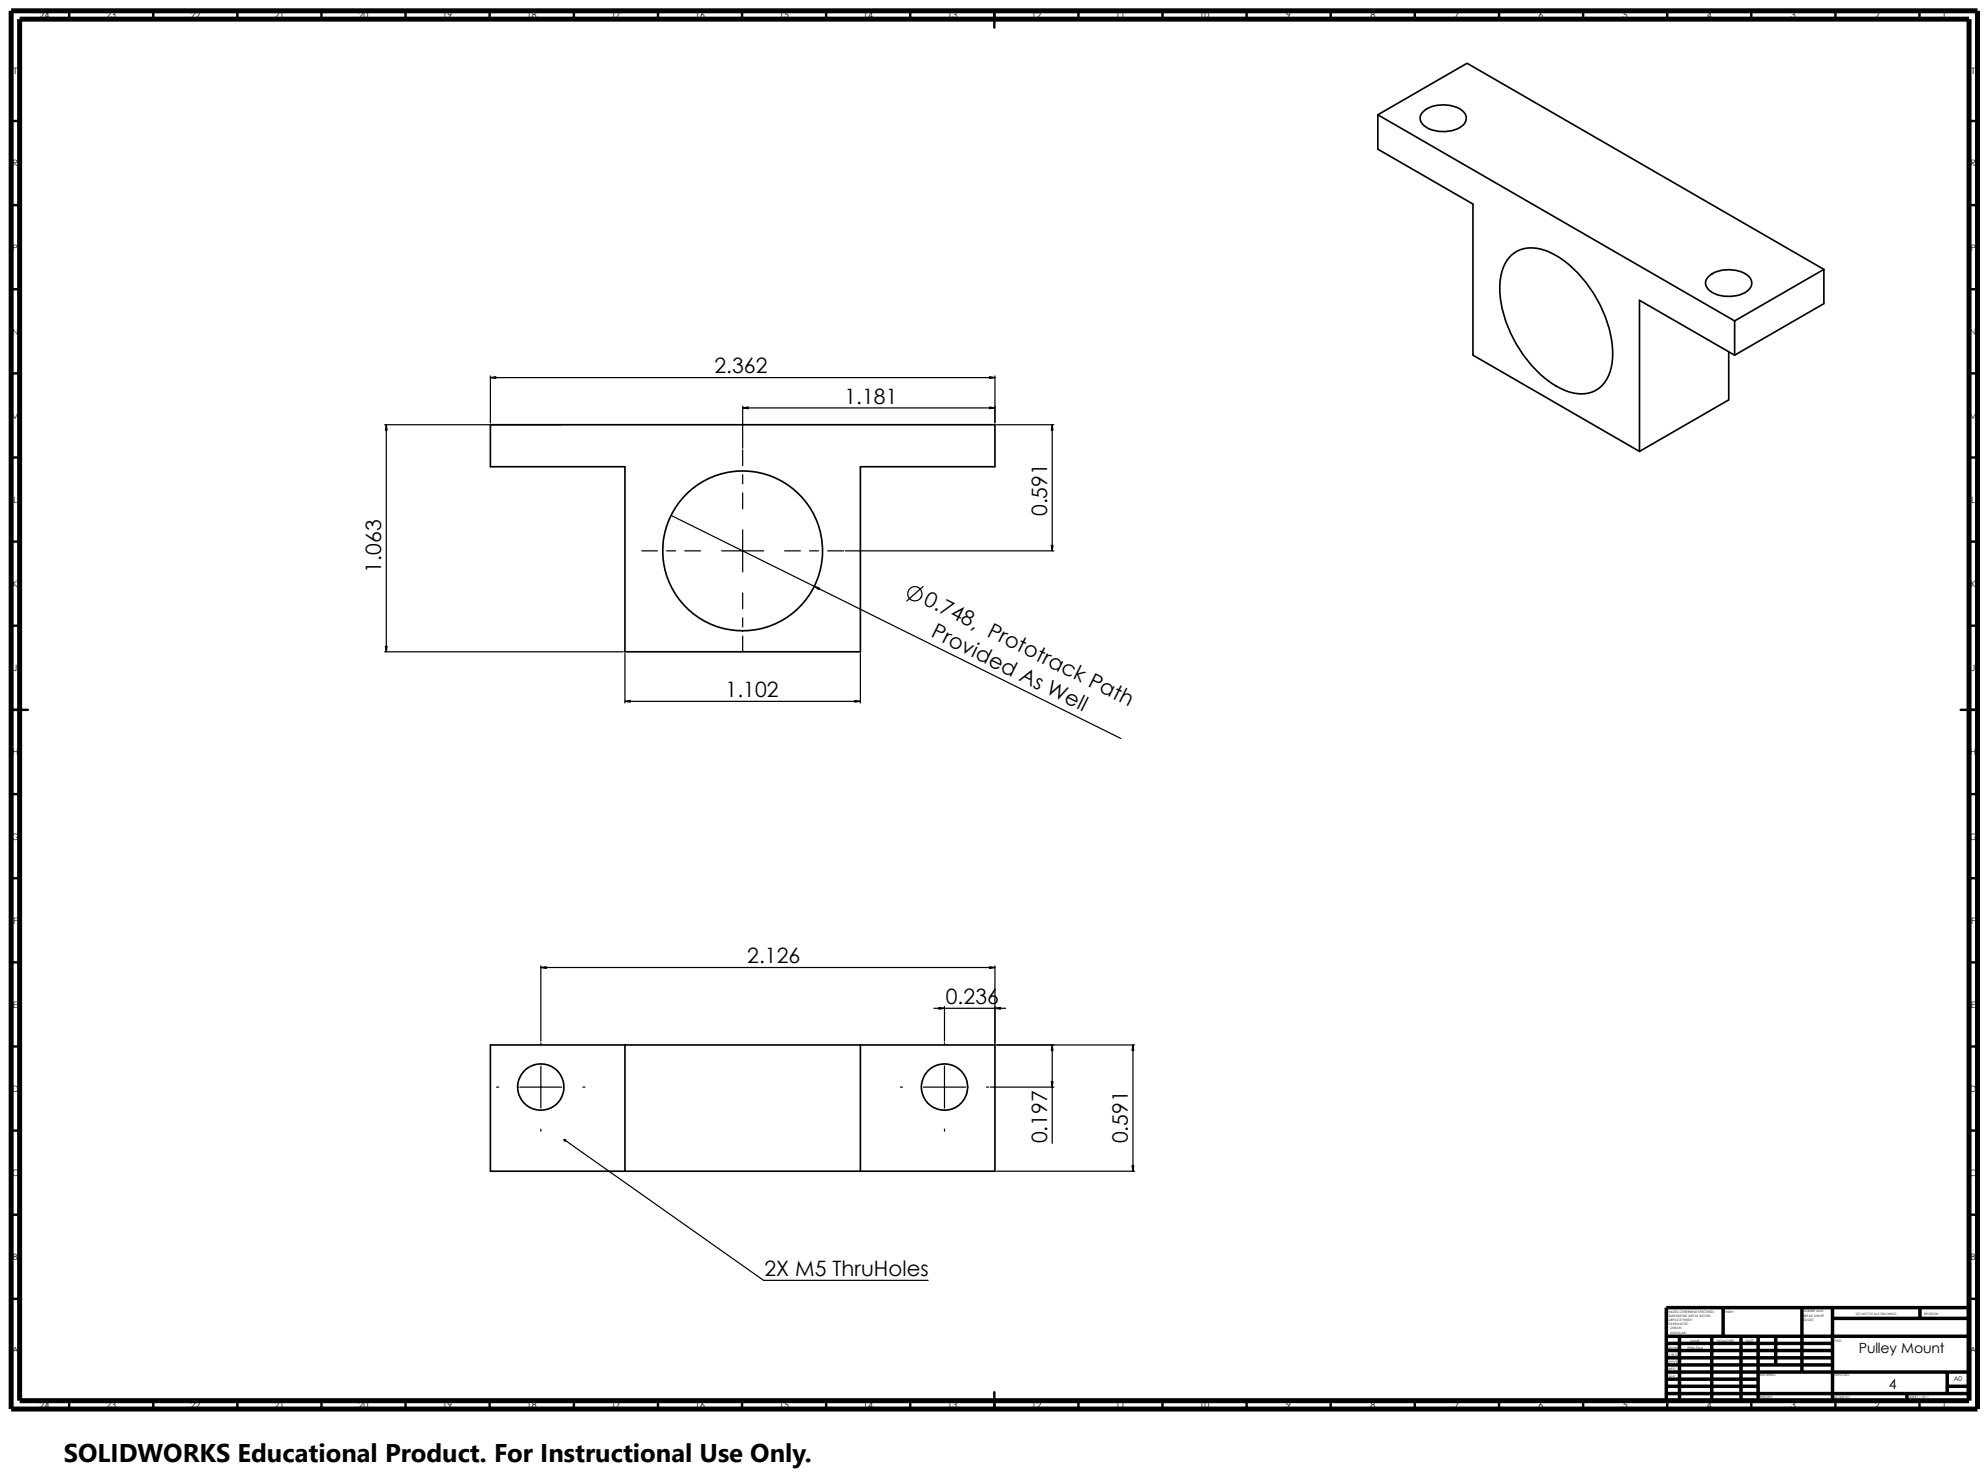
[picture p48: page 1]
FINISH:; EDGES; DO NOT SCALE DRAWING; REVISION; DEBURR AND BREAK SHARP; 2X M5 ThruHoles; 0.748, Prototrack Path

Provided As Well

UNLESS OTHERWISE SPECIFIED:
DIMENSIONS ARE IN INCHES
SURFACE FINISH:
TOLERANCES:
LINEAR:
ANGULAR:

NAME | SIGNATURE | DATE | | | | TITLE: Pulley Mount

DRAWN | Philip Sieg
CHK'D APPV'D

MFG
Q.A | | | | MATERIAL: | DWG NO. 4 | A0

24 23 22 21 20 19 18 17 16 15 14 13 | 12 11 10 9 8 7 6 5 | 4 | WEIGHT: 3 | SCALE:5:1 SHEET 1 OF 1 2 1

SOLIDWORKS Educational Product. For Instructional Use Only.
