AlpAydinoglu/cartpole_mechanical_setup/Mechanical Design/Documents/Drawings - PDF/5-BeltTensioner.pdf

P | P
R | R

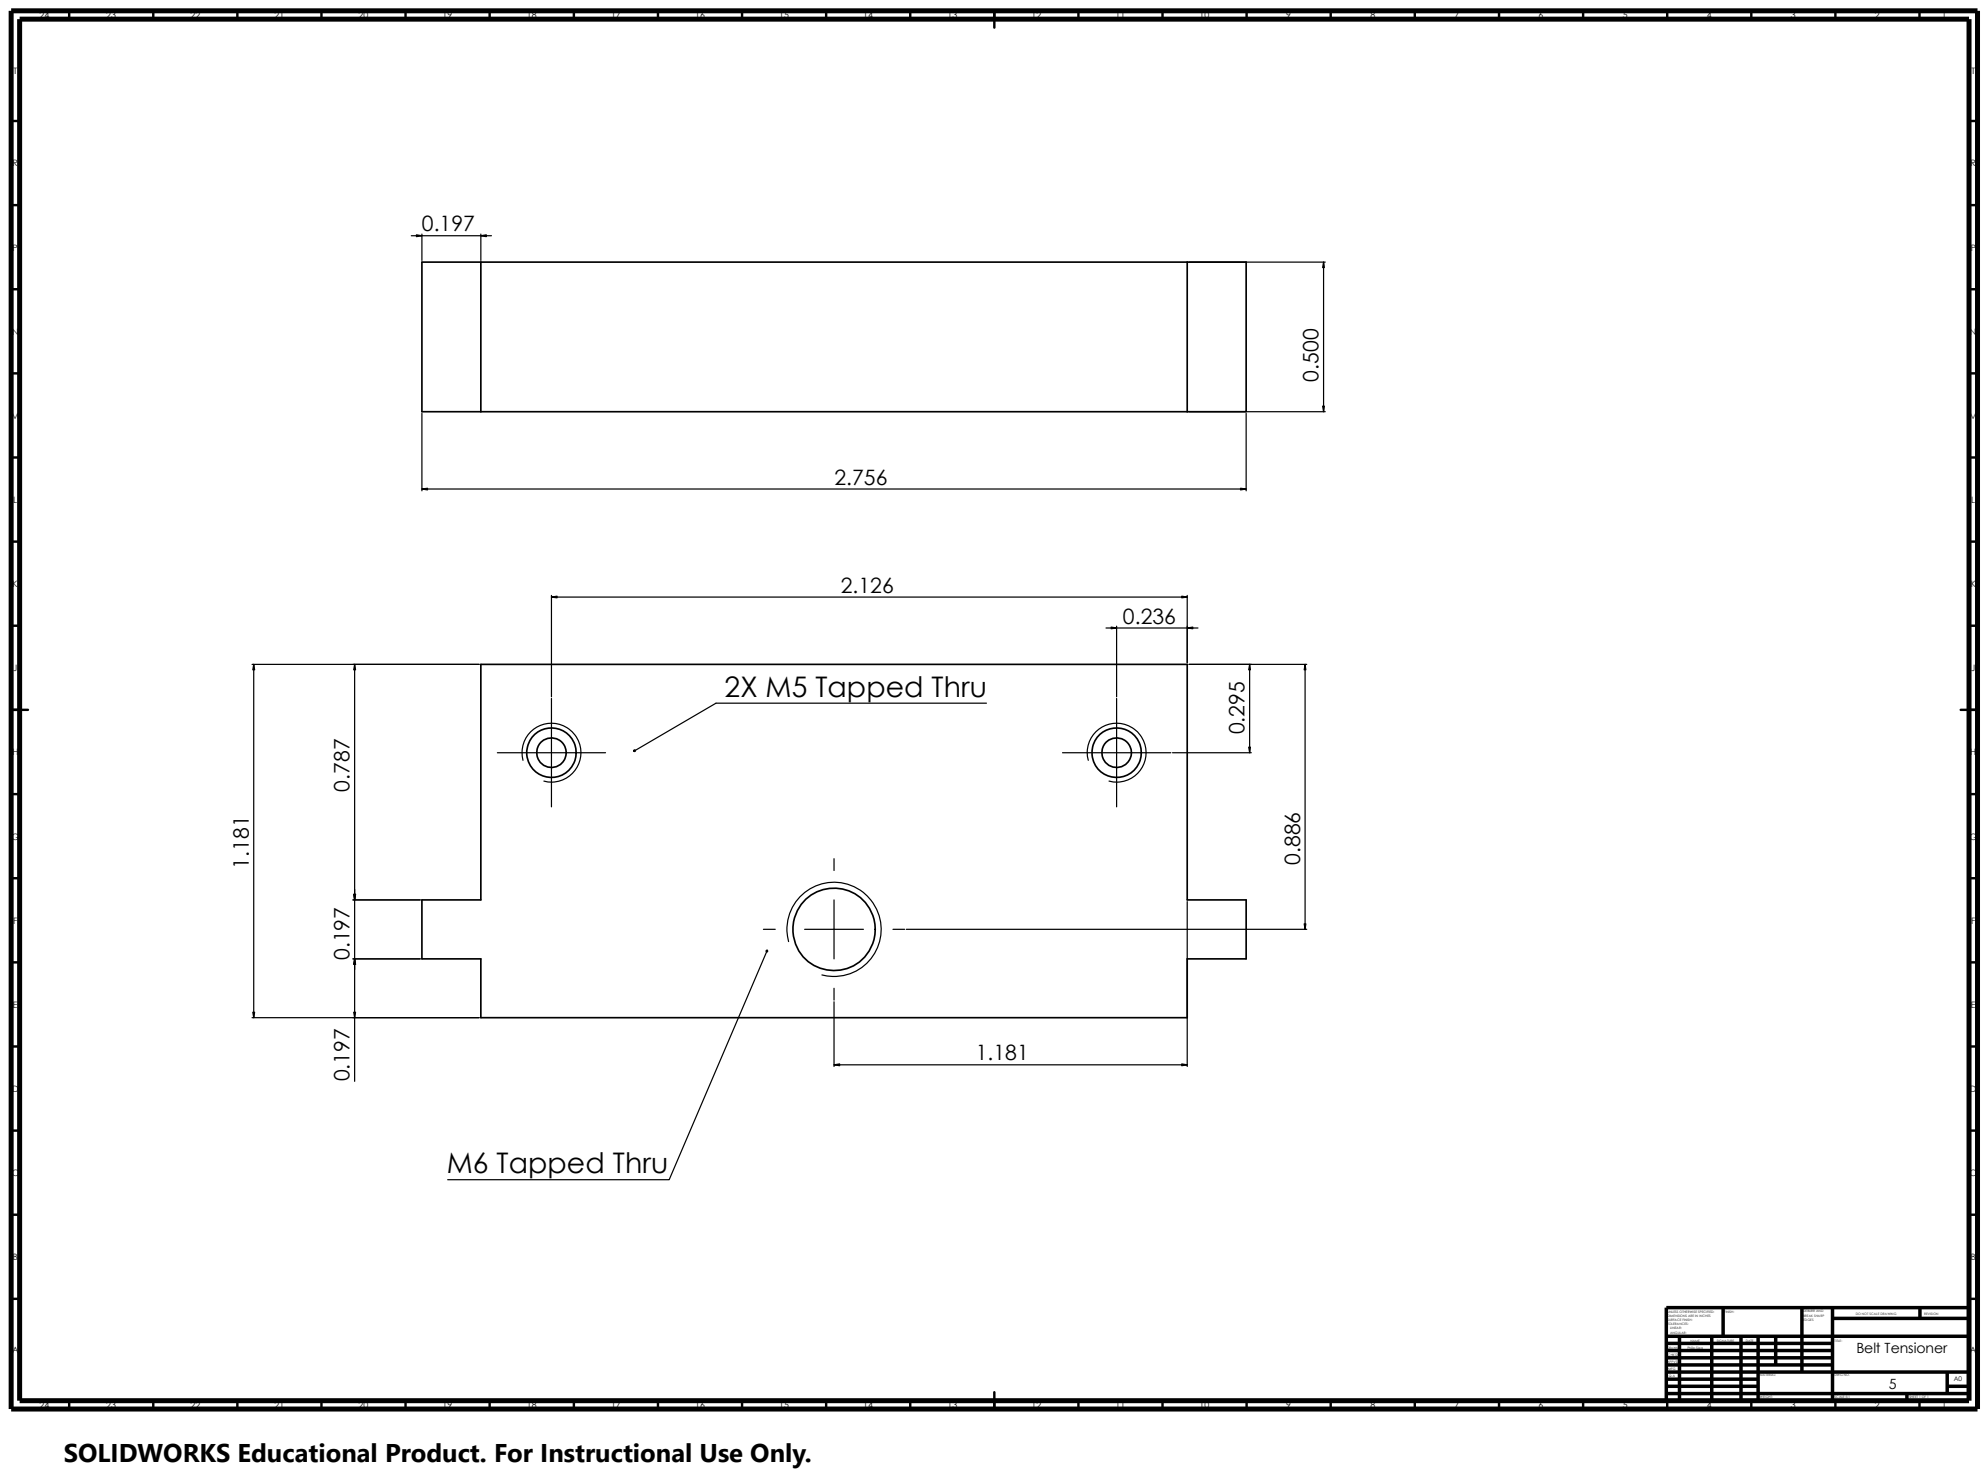
[picture p49: page 1]
FINISH:; EDGES; DO NOT SCALE DRAWING; REVISION; DEBURR AND BREAK SHARP; 2X M5 Tapped Thru; M6 Tapped Thru

UNLESS OTHERWISE SPECIFIED:
DIMENSIONS ARE IN INCHES
SURFACE FINISH:
TOLERANCES:
LINEAR:
ANGULAR:

NAME | SIGNATURE | DATE | | | | TITLE: Belt Tensioner

DRAWN | Philip Sieg
CHK'D APPV'D
Q.A | | | | MATERIAL: | DWG NO. 5 | A0

MFG

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

SOLIDWORKS Educational Product. For Instructional Use Only.
