AlpAydinoglu/cartpole_mechanical_setup/Mechanical Design/Documents/Drawings - PDF/6-ScrewPress.pdf

P | P
R | R

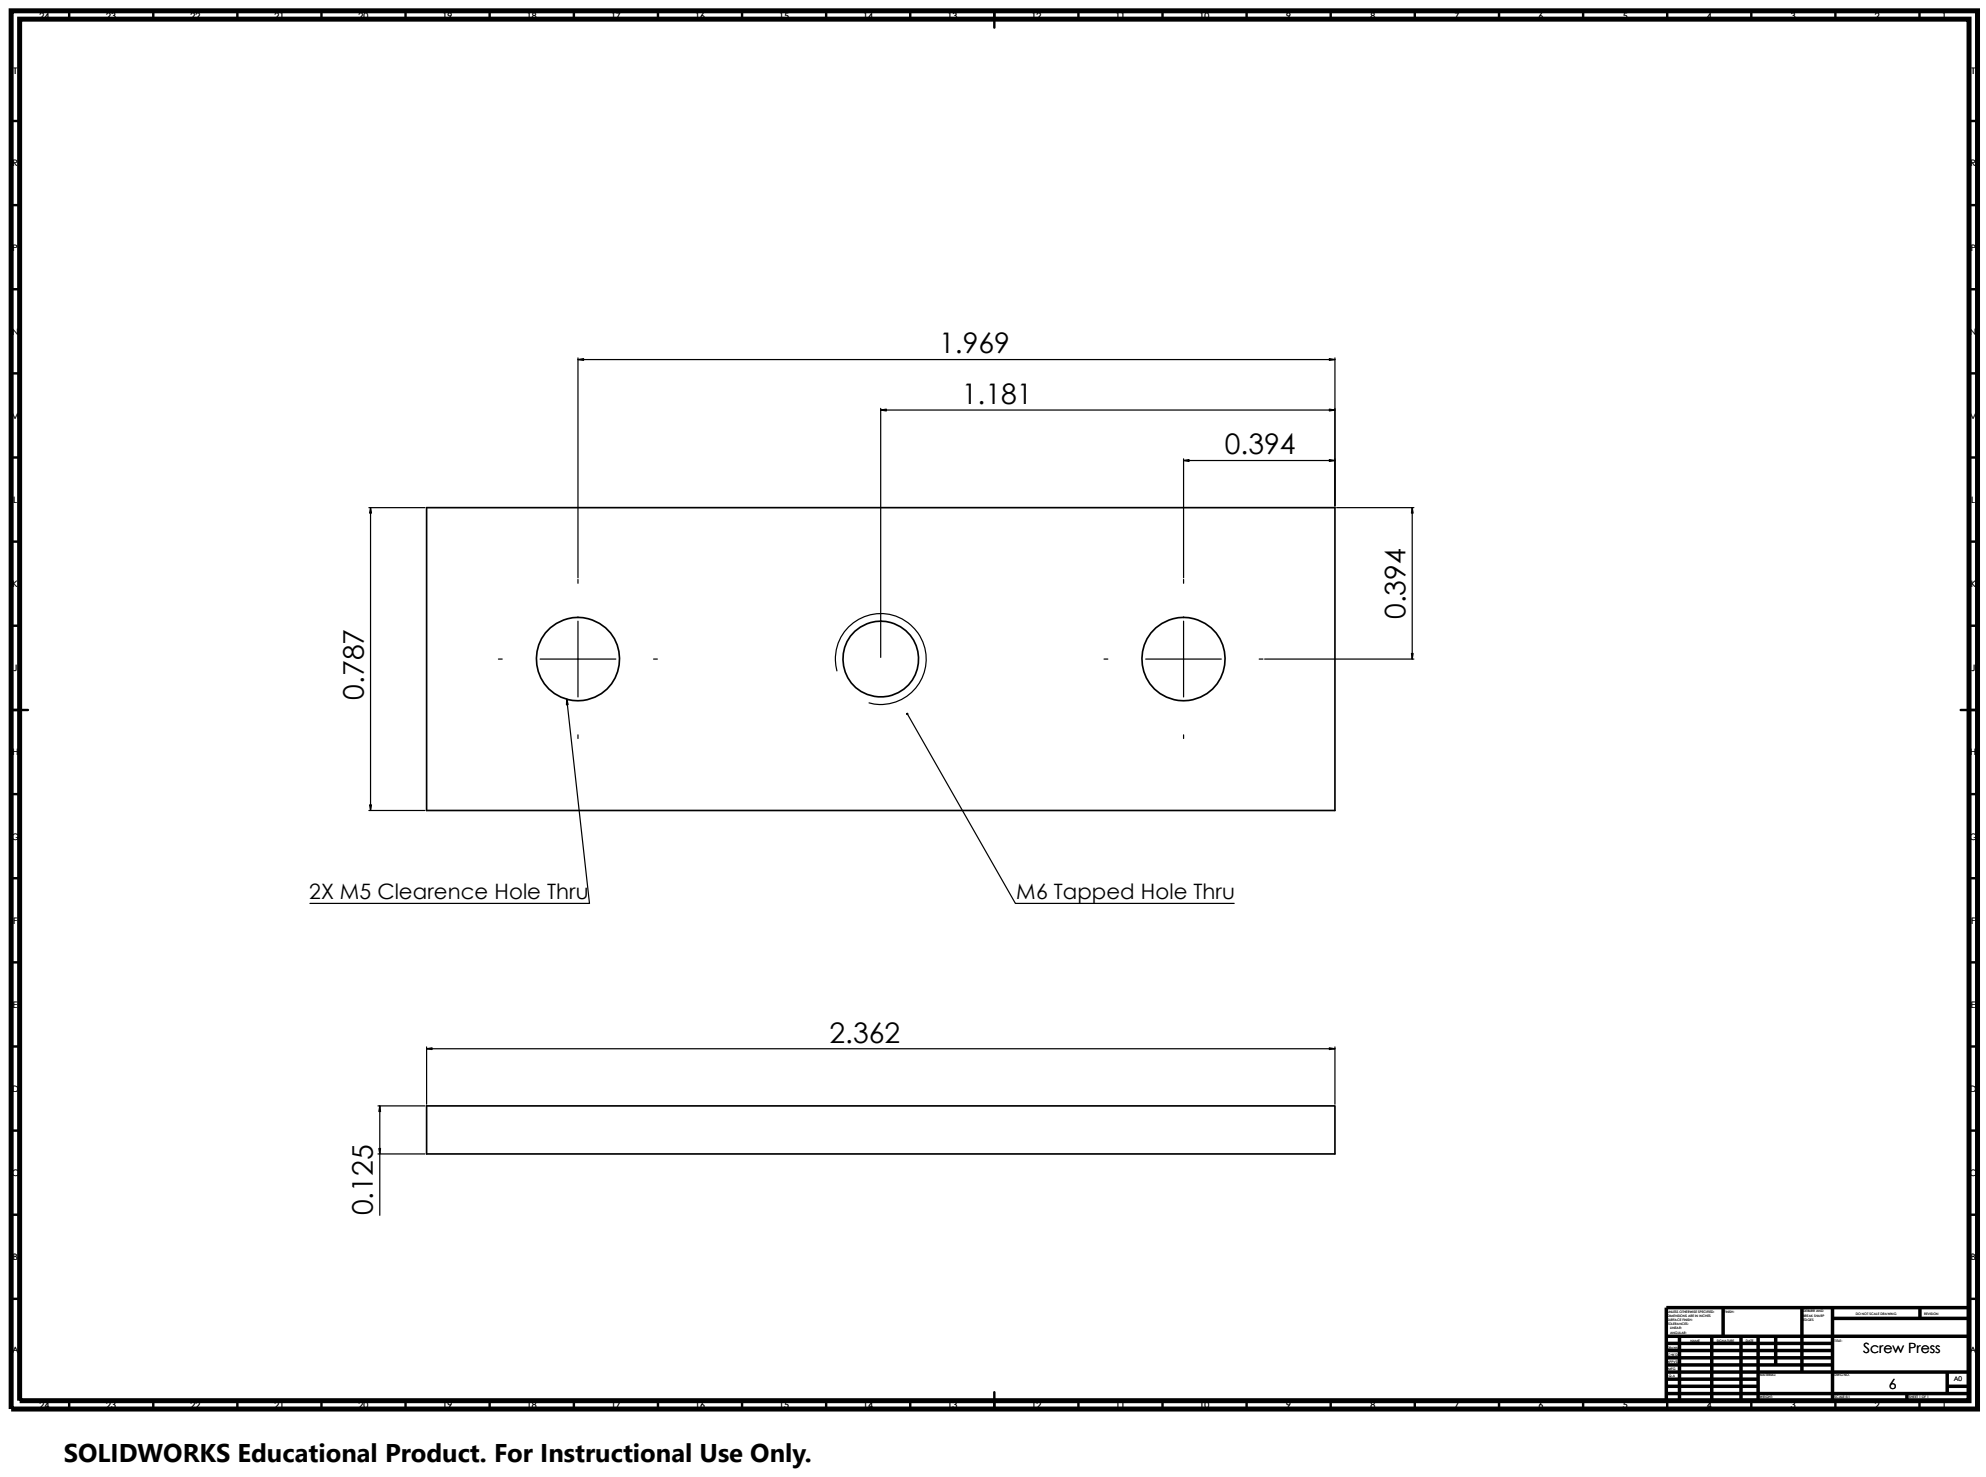
[picture p50: page 1]
FINISH:; DEBURR AND; BREAK SHARP EDGES; NAME; SIGNATURE; DATE; MATERIAL:; DO NOT SCALE DRAWING; REVISION; TITLE:; DWG NO.; SCALE:5:1; SHEET 1 OF 1; WEIGHT:; Screw Press; 2X M5 Clearence Hole Thru; M6 Tapped Hole Thru

UNLESS OTHERWISE SPECIFIED:
DIMENSIONS ARE IN INCHES
SURFACE FINISH:
TOLERANCES:
LINEAR:
ANGULAR:

DRAWN
CHK'D CHK'D APPV'D APPV'D

MFG MFG Q.A Q.A

SOLIDWORKS Educational Product. For Instructional Use Only.
