AlpAydinoglu/cartpole_mechanical_setup/Mechanical Design/Documents/Drawings - PDF/7-CartBase.pdf

P | P
R | R

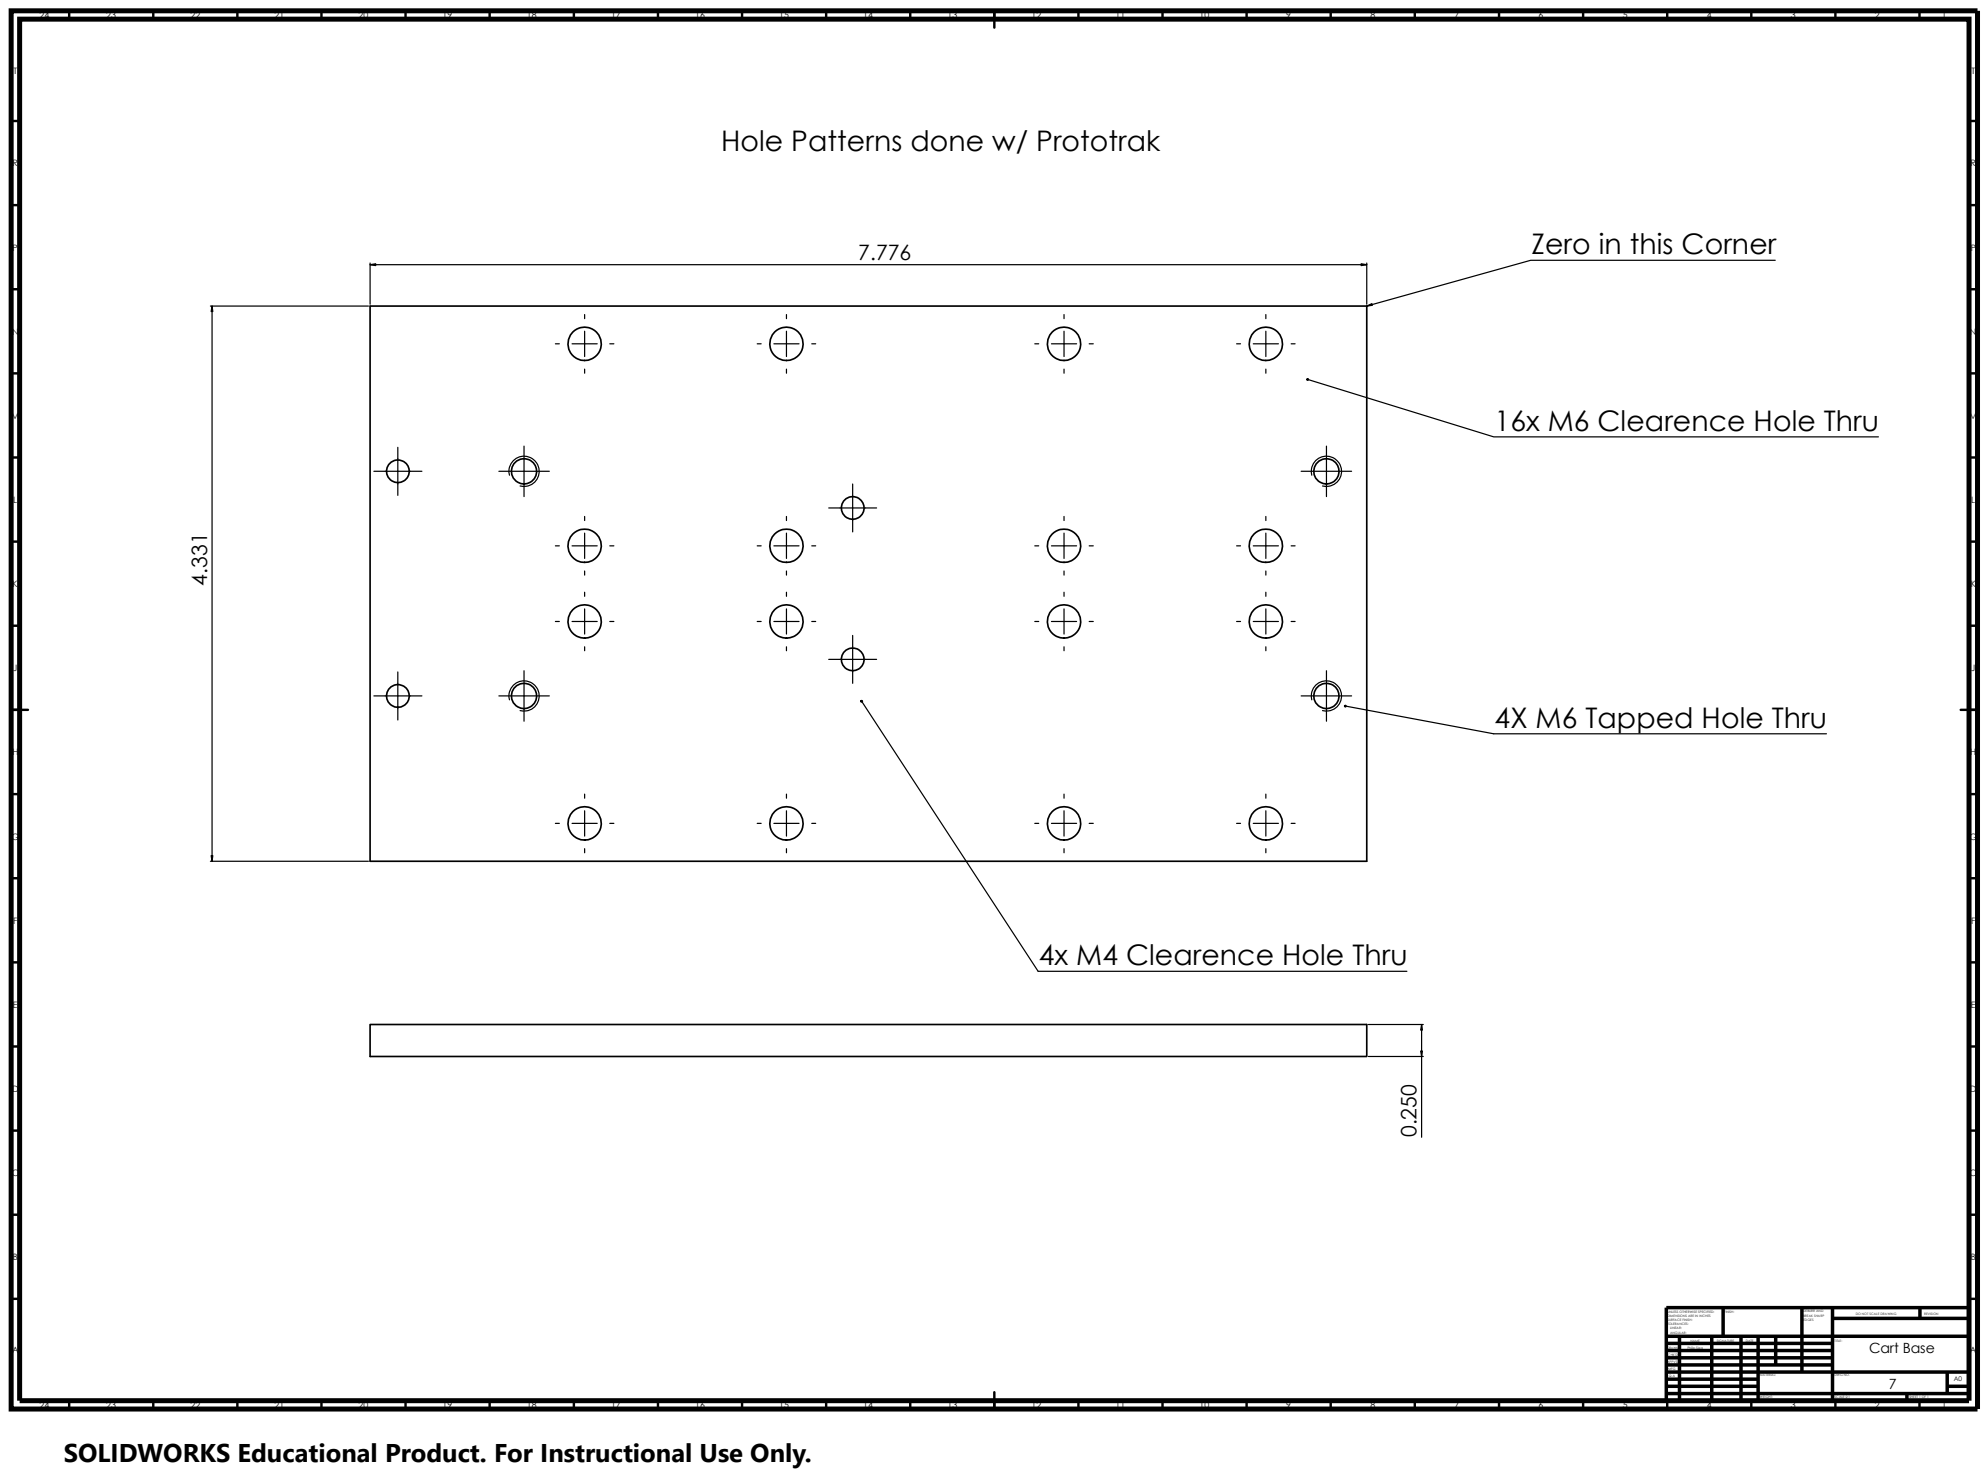
[picture p51: page 1]
WEIGHT:; SCALE:2:1; SHEET 1 OF 1; DWG NO.; FINISH:; EDGES; NAME; SIGNATURE; DATE; MATERIAL:; DO NOT SCALE DRAWING; REVISION; TITLE:; DEBURR AND BREAK SHARP; Cart Base

Hole Patterns done w/ Prototrak

Zero in this Corner

16x M6 Clearence Hole Thru

4X M6 Tapped Hole Thru

4x M4 Clearence Hole Thru

UNLESS OTHERWISE SPECIFIED:
DIMENSIONS ARE IN INCHES
SURFACE FINISH:
TOLERANCES:
LINEAR:
ANGULAR:

DRAWN | Philip Sieg
CHK'D APPV'D

MFG

SOLIDWORKS Educational Product. For Instructional Use Only.
