AlpAydinoglu/cartpole_mechanical_setup/Mechanical Design/Documents/Drawings - PDF/8-EncoderMount.pdf

P | P
R | R

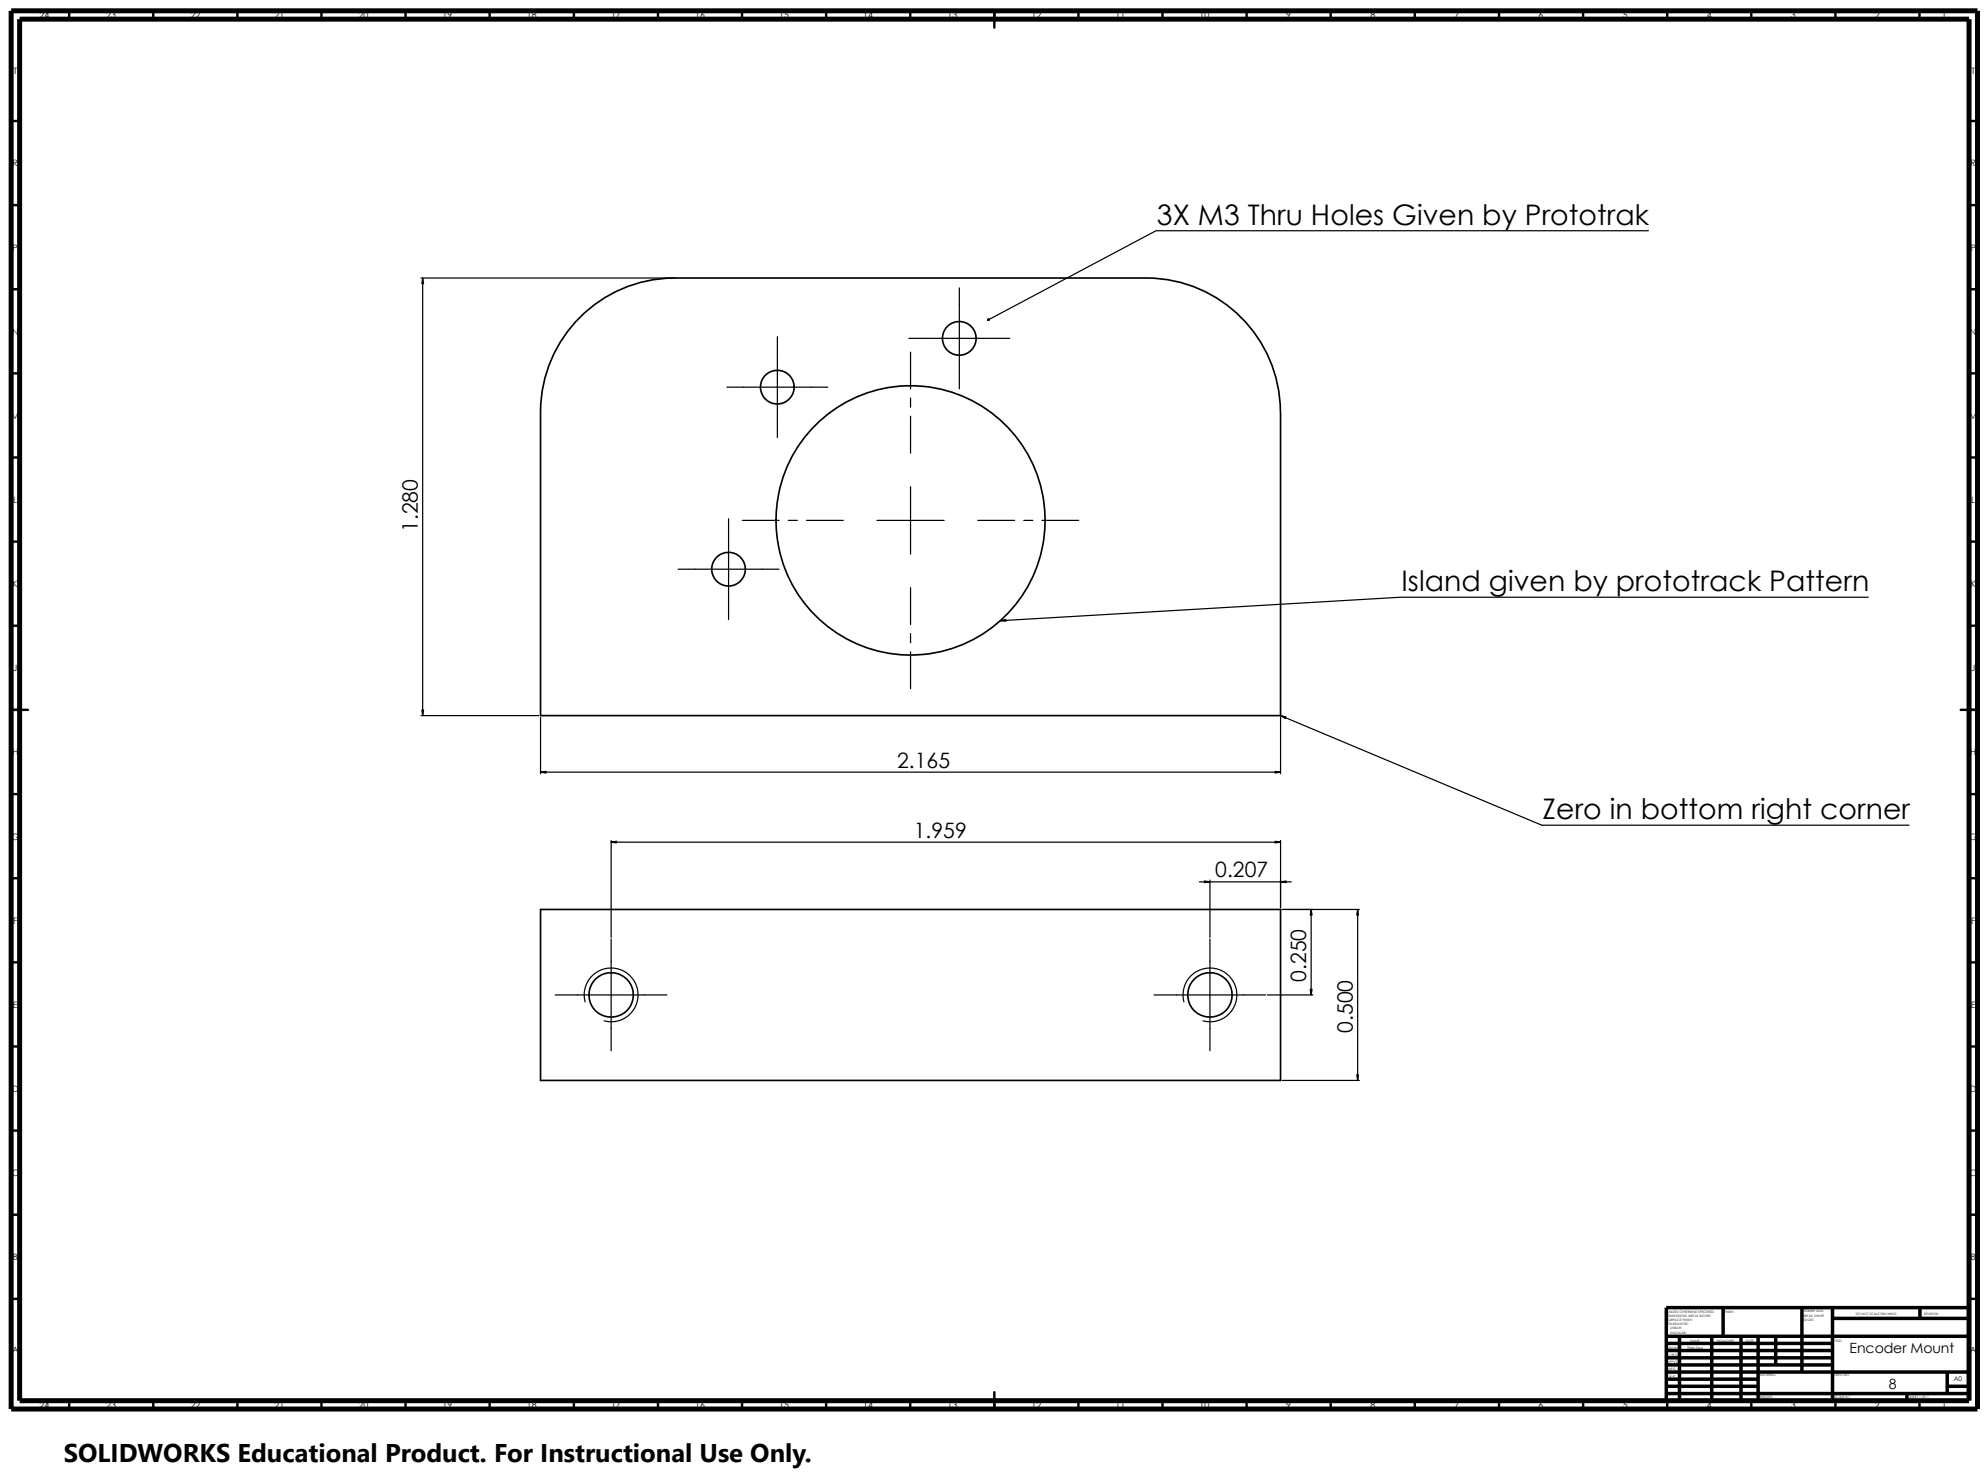
[picture p52: page 1]
DO NOT SCALE DRAWING; REVISION UNLESS OTHERWISE SPECIFIED: DIMENSIONS ARE IN INCHES

3X M3 Thru Holes Given by Prototrak

Island given by prototrack Pattern

Zero in bottom right corner

SURFACE FINISH: TOLERANCES: LINEAR: ANGULAR: | FINISH: | DEBURR AND EDGES BREAK SHARP

NAME | SIGNATURE | DATE | | | | TITLE: Encoder Mount

DRAWN | Philip Sieg
CHK'D APPV'D
Q.A | | | | MATERIAL: | DWG NO. 8 | A0

MFG

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

SOLIDWORKS Educational Product. For Instructional Use Only.
