AlpAydinoglu/cartpole_mechanical_setup/Mechanical Design/Documents/Drawings - PDF/9-CartAssembly.pdf

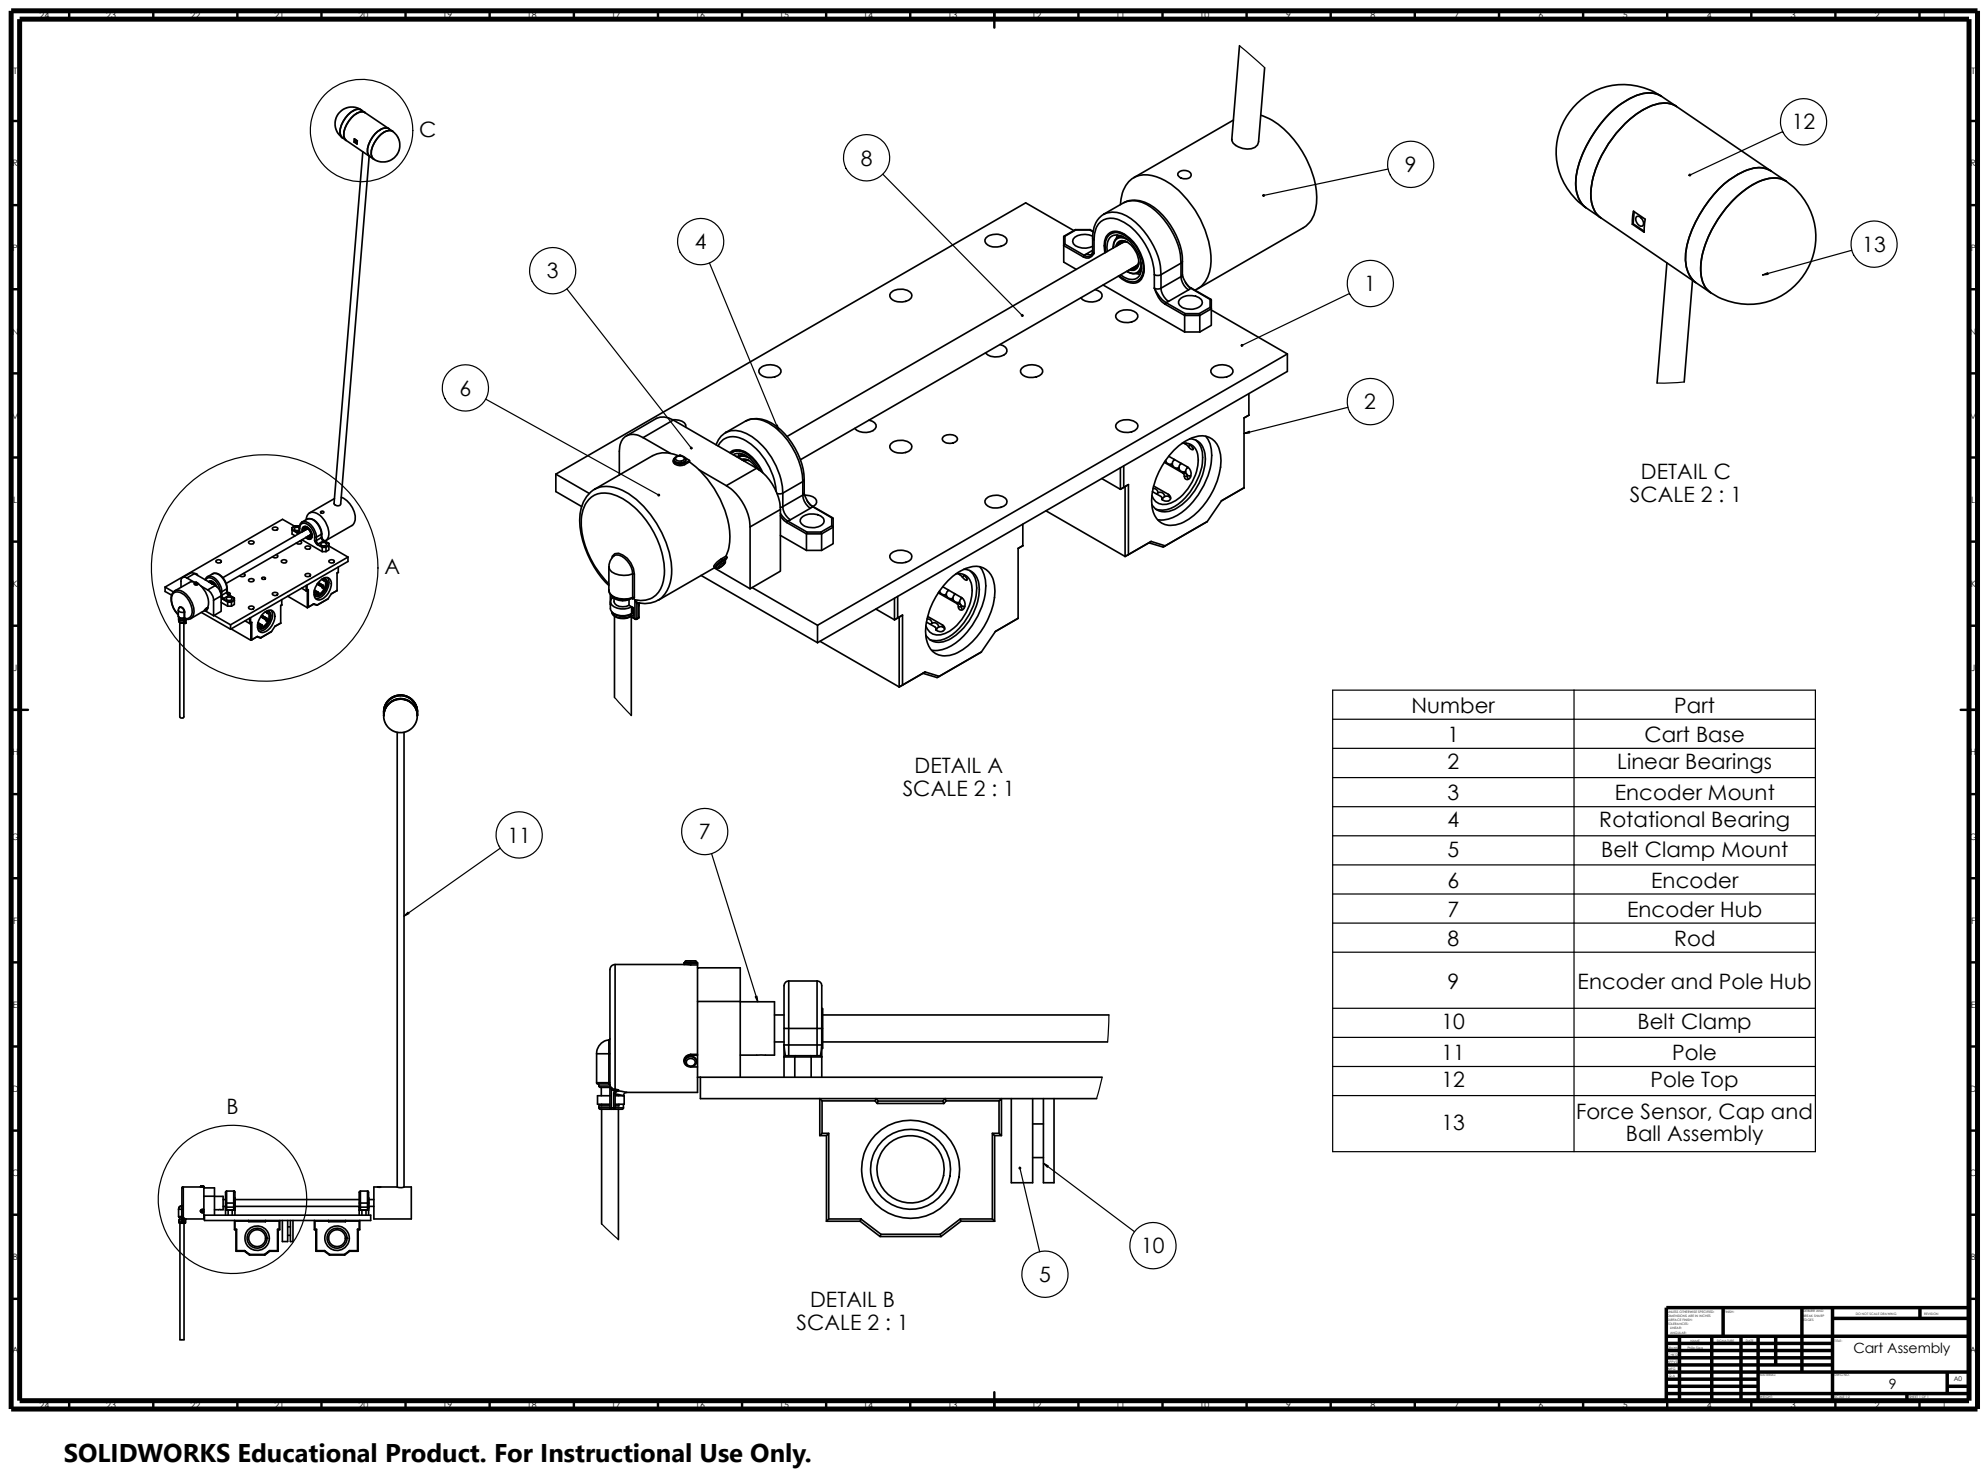
[picture p53: page 1]
FINISH:; EDGES; DO NOT SCALE DRAWING; REVISION; DEBURR AND BREAK SHARP; SCALE 2 : 1; DETAIL C; DETAIL B SCALE 2 : 1; DETAIL A SCALE 2 : 1

Number | Part
1 | Cart Base
2 | Linear Bearings
3 | Encoder Mount
4 | Rotational Bearing
5 | Belt Clamp Mount
6 | Encoder
7 | Encoder Hub
8 | Rod
9 | Encoder and Pole Hub
10 | Belt Clamp
11 | Pole
12 | Pole Top
13 | Force Sensor, Cap and Ball Assembly

UNLESS OTHERWISE SPECIFIED:
DIMENSIONS ARE IN INCHES
SURFACE FINISH:
TOLERANCES:
LINEAR:
ANGULAR:

NAME | SIGNATURE | DATE | | | | TITLE: Cart Assembly

DRAWN | Philip Sieg
CHK'D APPV'D
Q.A | | | | MATERIAL: | DWG NO. 9 | A0

MFG

24 23 22 21 20 19 18 17 16 15 14 13 | 12 11 10 9 8 7 6 5 | 4 | WEIGHT: 3 | SCALE:1:2 SHEET 1 OF 1 2 1

SOLIDWORKS Educational Product. For Instructional Use Only.
