AlpAydinoglu/cartpole_mechanical_setup/Mechanical Design/Documents/Instructions/Mechanical B.O.M..pdf

# Bill of Materials - Mechanical Components

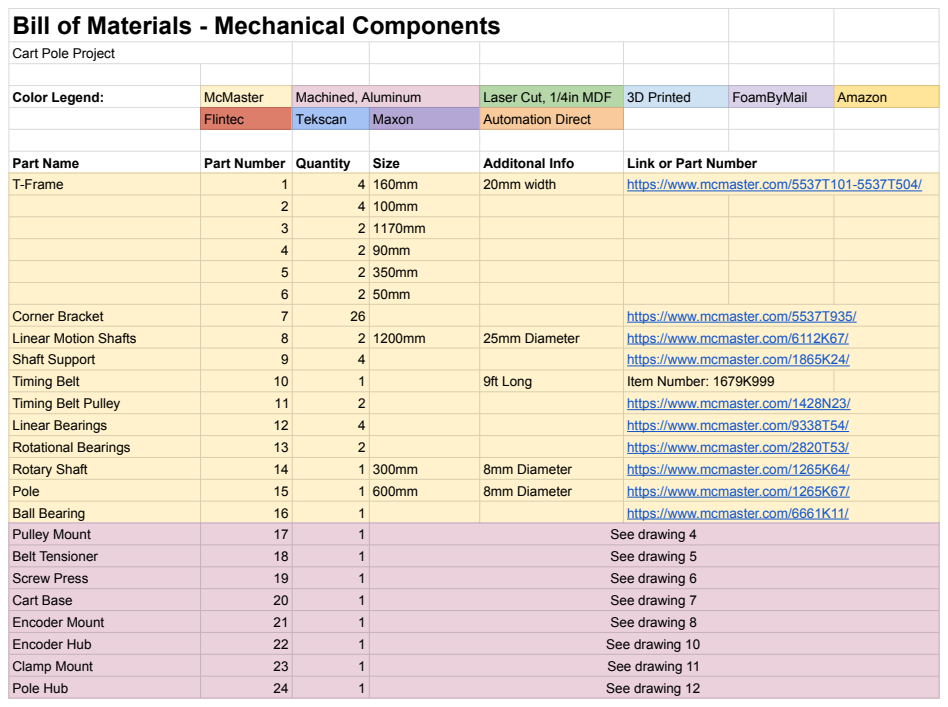
[picture p54: page 1]
Color Legend:; McMaster; Machined, Aluminum; Laser Cut, 1/4in MDF; 3D Printed; FoamByMail; Amazon; Flintec; Tekscan; Maxon; Automation Direct; Part Name; Part Number Quantity; Size; Additonal Info; Link or Part Number; T-Frame; 20mm width; https://www.mcmaster.com/5537T101-5537T504/; Corner Bracket; https://www.mcmaster.com/5537T935/; Linear Motion Shafts; 25mm Diameter; https://www.mcmaster.com/6112K67/; Shaft Support; https://www.mcmaster.com/1865K24/; Timing Belt; 9ft Long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

Cart Pole Project

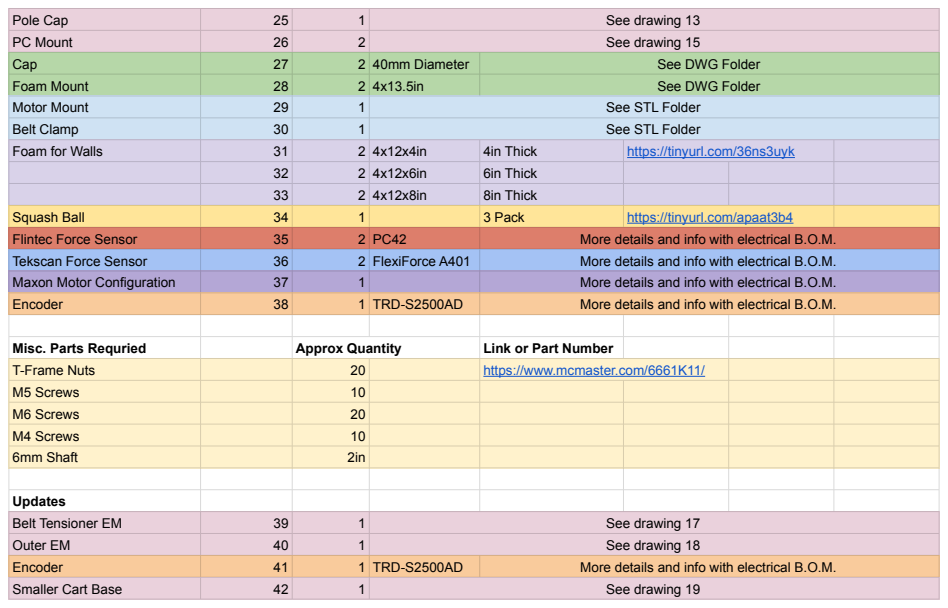
[picture p55: page 2]
Pole Cap; See drawing 13; PC Mount; See drawing 15; Cap; 2 40mm Diameter; See DWG Folder; Foam Mount; Motor Mount; See STL Folder; Belt Clamp; Foam for Walls; 4in Thick; https://tinyurl.com/36ns3uyk; 6in Thick; 8in Thick; Squash Ball; 3 Pack; https://tinyurl.com/apaat3b4; Flintec Force Sensor; More details and info with electrical B.O.M.; Tekscan Force Sensor; 2 FlexiForce A401; Maxon Motor Configuration; Encoder; 1 TRD-S2500AD; Misc. Parts Requried; Approx Quantity; Link or Part Number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
